casktura/SIBOOR-Voron-2.4-AUG/00_My_Build/STLs/BTT HDMI5 V1.2 display mount Voron/hdmi5-v1_2-mount-assy_voronlogo.step

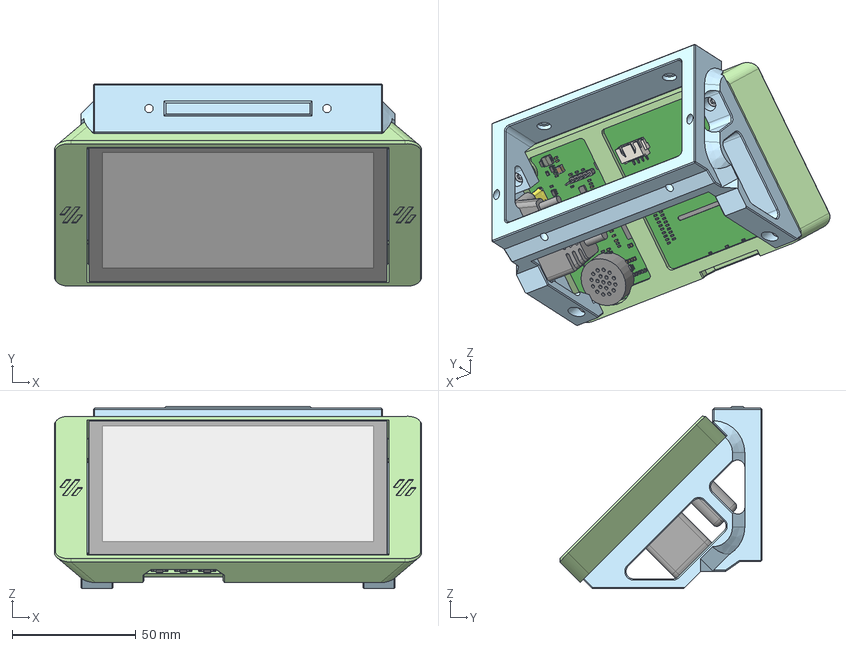
[picture p1: CAD file, 2026-06-15]
00_My_Build/STLs/BTT HDMI5 V1.2 display mount Voron/hdmi5-v1_2-mount-assy_voronlogo.step
148.4 x 81.8 x 73.8 mm
Hex socket head cap screw M3x0.50 x 6 x 4
BTT HDMI5 V1-2 mount bracket
USB-C 90 deg cable
BTT HDMI5 V1_2 mount frame
HDMI 90 deg cable
Speaker
R0603 x 150
Extruded x 150
SOT-23-5 x 14
User_Library-LTST-C190GKT_Lens
ts-1101vs-c-a-a x 3
Board
User_Library-LED_0603_G_Fillet
User_Library-LED_0603_G_Pad004
User_Library-LTST-C190GKT_Pad006
TSSOP-10
XH2.54-WS-Òý½Å x 4
R0805 x 2
LOGO?0.5 x 14
User_Library-LTST-C190GKT_Pad004
XB-CF24P-1
0420¶Ë×Ó x 2
CSAC0420
User_Library-LTST-C190GKT_Pad007
XH2.54-WS-4P x 3
L_tende.stp x 10
base.stp x 5
User_Library-LTST-C190GKT_Pad
User_Library-SOT1176-1-1_RGB659217 x 3
User_Library-LTST-C190GKT_Pad005
User_Library-SOT23-6-2 x 2
SOT-223_MP04A x 6
User_Library-C-1210-2_5x2_5x3_2
User_Library-LTST-C190GKT_Pad001
String+
String-
LOGOÔ²££°.£³ x 14
SOD-123
User_Library-LED_0603_G_Pad
LOGO?0.15 x 28
OSC_3225-4 x 12
User_Library-24_QFN_3x3 x 26
LOGO?0.25 x 14
FPC0.5_2H-W_Òý½Å x 6
FPC0.5_2H-S-W-6P x 2
LOGO? x 14
R_0603 x 3
User_Library-LTST-C190GKT_Pad003
User_Library-LED_0603_G_Pocket002
Strip
Button
Pin
Sheet_Metal_Part6 x 2
TSSOP-8 x 9
User_Library-LED_0603_G_Pocket001
COMPOUND^FPC-SMD_KH-FG0.5-H2.0-50PIN_U1_FPC0.5MM_WS_50P_C2797221(2)_F PC0.5MM_WS_50P_C2797221 x 56
QFN76_L9_W9_P0R4 x 78
