casktura/SIBOOR-Voron-2.4-AUG/00_My_Build/STLs/00_Prints/Annes Engineering - Panel Clips/2 Sides/lock_body_6mm_x4.STL

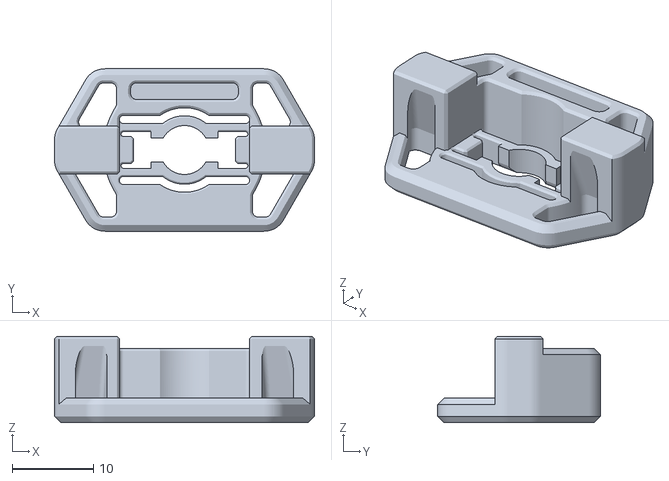
[picture p3: CAD file, 2026-05-06]
00_My_Build/STLs/00_Prints/Annes Engineering - Panel Clips/2 Sides/lock_body_6mm_x4.STL
32.0 x 20.0 x 10.6
