casktura/SIBOOR-Voron-2.4-AUG/00_My_Build/STLs/00_Prints/Annes Engineering - Panel Clips/Back/key_asymmetric_5_x11.STL

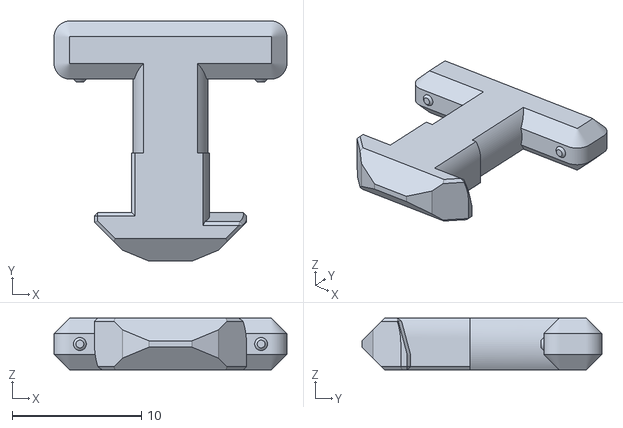
[picture p4: CAD file, 2026-05-06]
00_My_Build/STLs/00_Prints/Annes Engineering - Panel Clips/Back/key_asymmetric_5_x11.STL
18.0 x 18.6 x 4.00
