casktura/SIBOOR-Voron-2.4-AUG/00_My_Build/STLs/00_Prints/Annes Engineering - Panel Clips/Top/lock_body_4mm_x4.STL

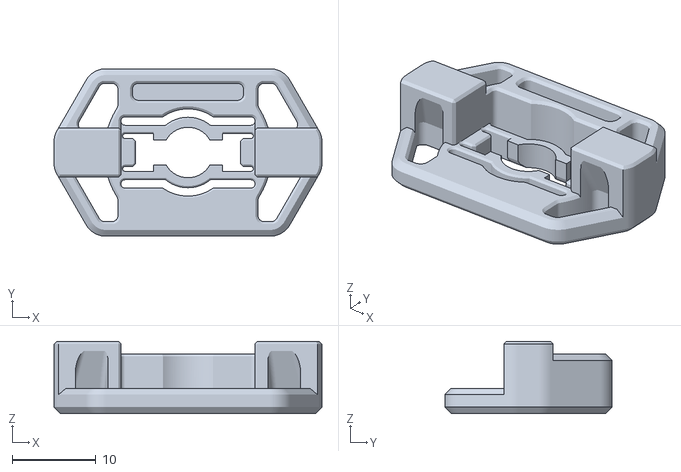
[picture p5: CAD file, 2026-05-06]
00_My_Build/STLs/00_Prints/Annes Engineering - Panel Clips/Top/lock_body_4mm_x4.STL
32.0 x 20.0 x 8.60
