casktura/SIBOOR-Voron-2.4-AUG/00_My_Build/STLs/00_Prints/Magnetic Door Hinge for V2.4 Remixed/magnetic_door_hinge_tape_v2__4mm.stl

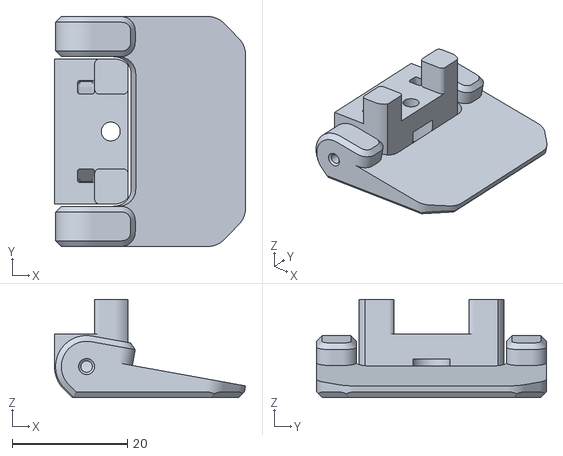
[picture p6: CAD file, 2026-05-18]
00_My_Build/STLs/00_Prints/Magnetic Door Hinge for V2.4 Remixed/magnetic_door_hinge_tape_v2__4mm.stl
33.2 x 40.0 x 17.1
