casktura/SIBOOR-Voron-2.4-AUG/00_My_Build/STLs/2020 Extrusion Cable Clips/clip_small.stl

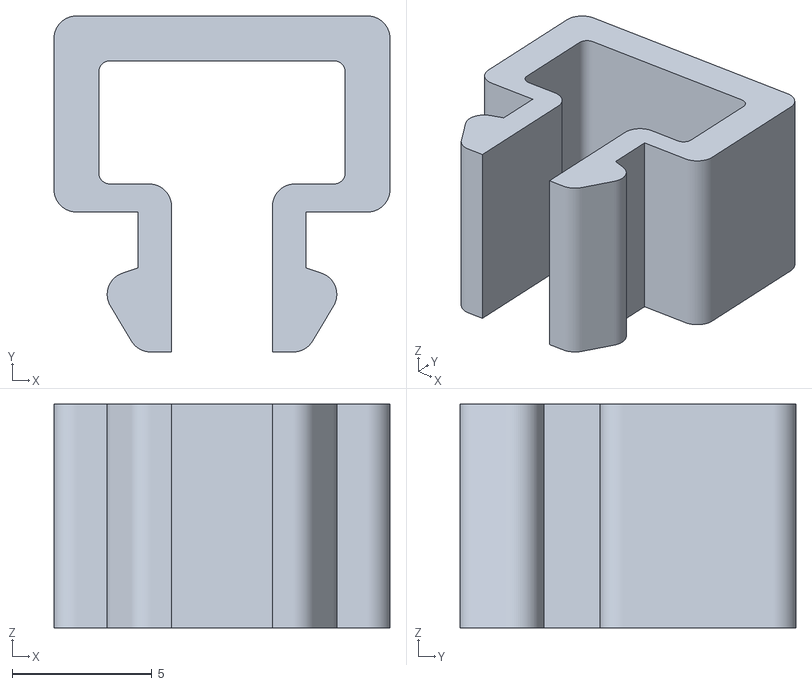
[picture p7: CAD file, 2026-05-06]
00_My_Build/STLs/2020 Extrusion Cable Clips/clip_small.stl
12.0 x 12.0 x 8.00
