casktura/SIBOOR-Voron-2.4-AUG/00_My_Build/STLs/Annes Engineering - Panel Clips/Source/hinge/qr/STL/support_plate_6mm_mirror.stl

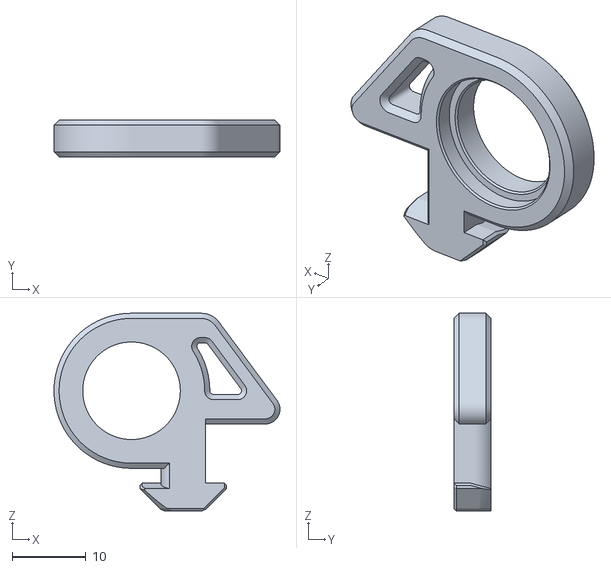
[picture p8: CAD file, 2026-05-06]
00_My_Build/STLs/Annes Engineering - Panel Clips/Source/hinge/qr/STL/support_plate_6mm_mirror.stl
30.6 x 5.00 x 26.8
