casktura/SIBOOR-Voron-2.4-AUG/00_My_Build/STLs/Annes Engineering - Panel Clips/Source/panel_clips_and_corners/key/CAD/key_asymmetric_9.STEP

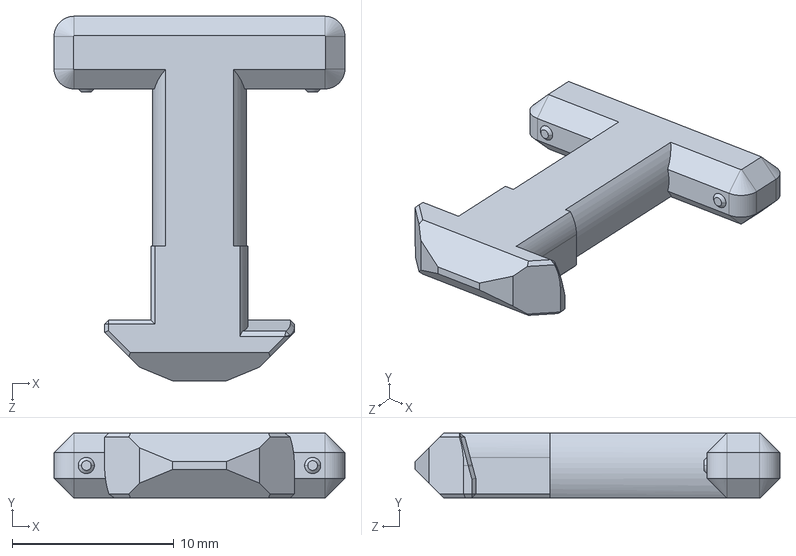
[picture p11: CAD file, 2026-05-06]
00_My_Build/STLs/Annes Engineering - Panel Clips/Source/panel_clips_and_corners/key/CAD/key_asymmetric_9.STEP
18.0 x 4.00 x 22.6 mm
