casktura/SIBOOR-Voron-2.4-AUG/00_My_Build/STLs/Annes Engineering - Panel Clips/Source/panel_latch/CAD/latch.STEP

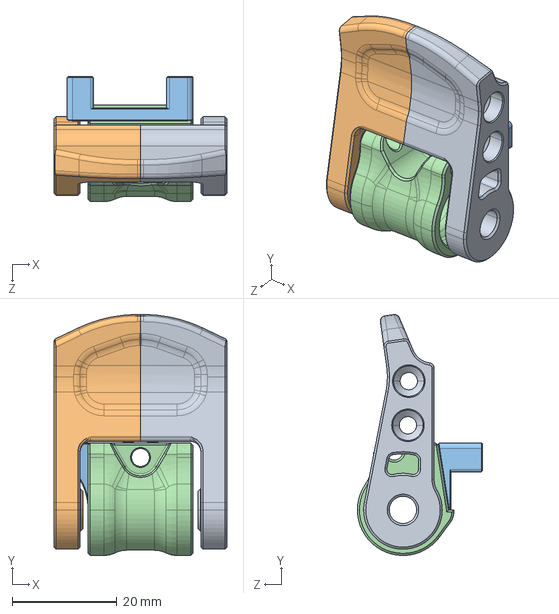
[picture p13: CAD file, 2026-05-06]
00_My_Build/STLs/Annes Engineering - Panel Clips/Source/panel_latch/CAD/latch.STEP
33.0 x 46.0 x 23.9 mm
