casktura/SIBOOR-Voron-2.4-AUG/00_My_Build/STLs/Annes Engineering - Panel Clips/Source/panel_latch/STLs/right.STL

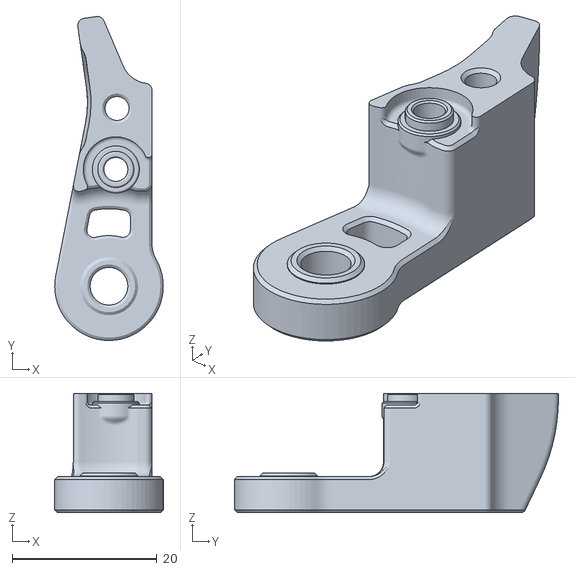
[picture p14: CAD file, 2026-05-06]
00_My_Build/STLs/Annes Engineering - Panel Clips/Source/panel_latch/STLs/right.STL
15.0 x 44.8 x 16.5
