casktura/SIBOOR-Voron-2.4-AUG/00_My_Build/STLs/Annes Engineering - Panel Clips/Source/panel_support/locking/STL/locing_panel_support_key_4mm.stl

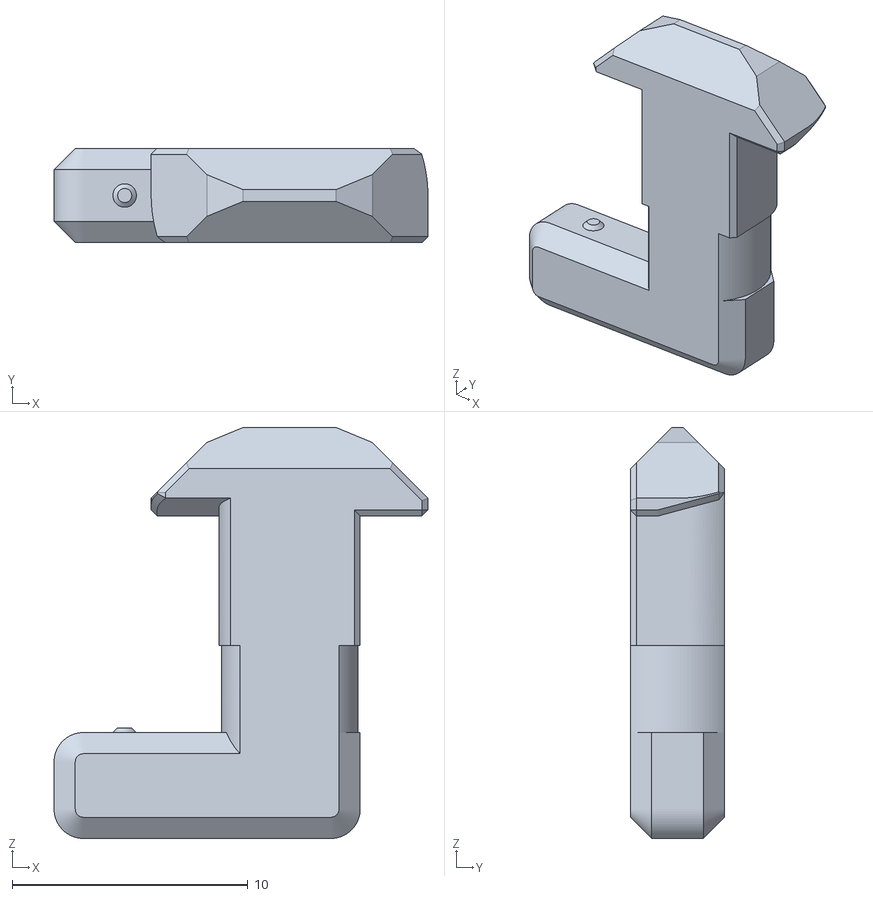
[picture p15: CAD file, 2026-05-06]
00_My_Build/STLs/Annes Engineering - Panel Clips/Source/panel_support/locking/STL/locing_panel_support_key_4mm.stl
15.9 x 4.00 x 17.4
