casktura/SIBOOR-Voron-2.4-AUG/00_My_Build/STLs/Annex Clip Wrench/annex_clips_wrench.stl

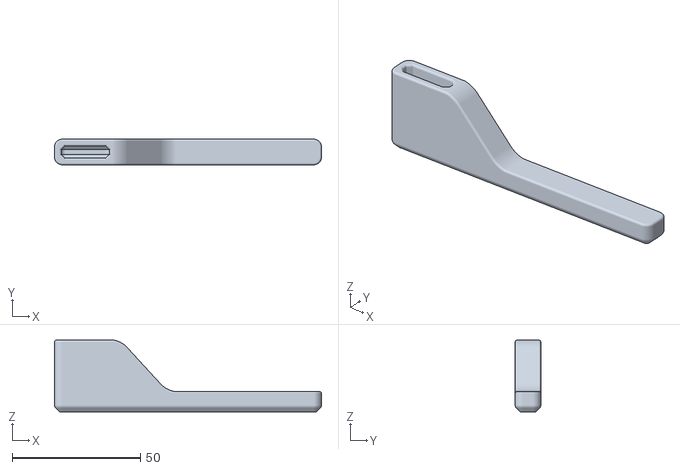
[picture p17: CAD file, 2026-05-20]
00_My_Build/STLs/Annex Clip Wrench/annex_clips_wrench.stl
104.0 x 10.0 x 28.0
