casktura/SIBOOR-Voron-2.4-AUG/00_My_Build/STLs/BTT HDMI5 V1.2 Display Voron V2.4 Mount/btt-hdmi5-v1_2-mount-frame_regular.stl

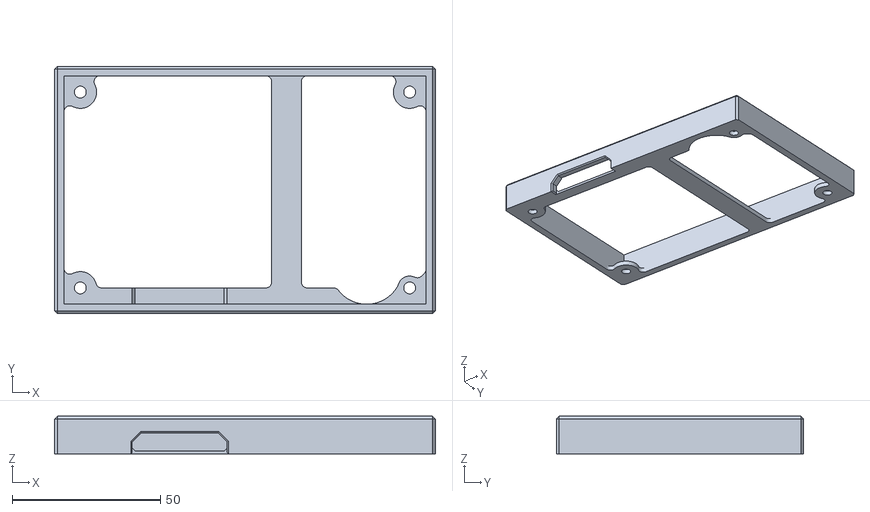
[picture p18: CAD file, 2026-06-15]
00_My_Build/STLs/BTT HDMI5 V1.2 Display Voron V2.4 Mount/btt-hdmi5-v1_2-mount-frame_regular.stl
128.4 x 83.4 x 12.7
