casktura/SIBOOR-Voron-2.4-AUG/00_My_Build/STLs/Exhaust Cover/Exhaust_cover.step

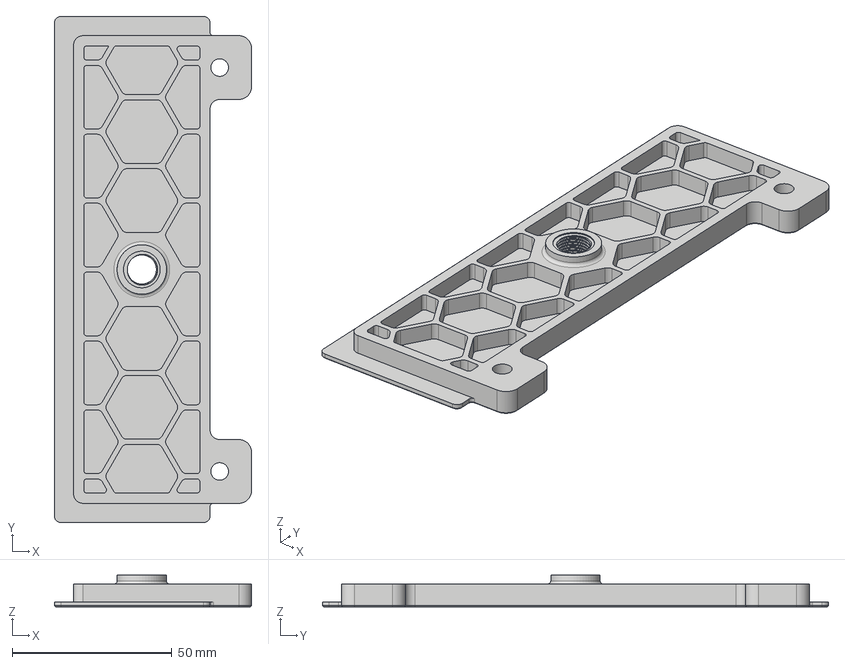
[picture p19: CAD file, 2026-05-06]
00_My_Build/STLs/Exhaust Cover/Exhaust_cover.step
61.8 x 158.6 x 10.00 mm
