casktura/SIBOOR-Voron-2.4-AUG/00_My_Build/STLs/Front Door M3/hinge_left_x2.stl

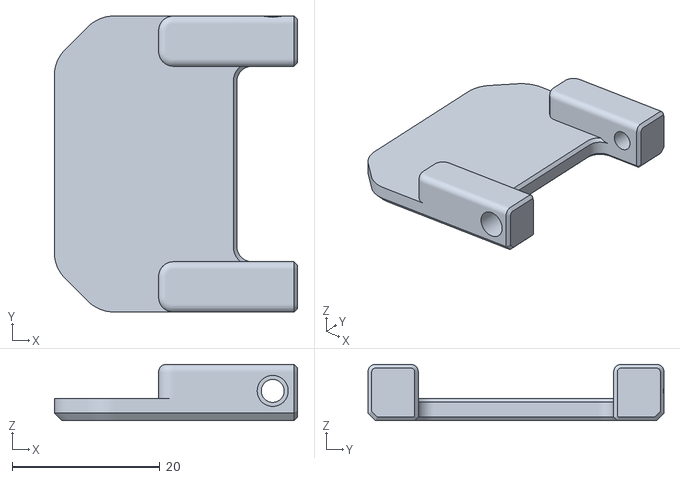
[picture p20: CAD file, 2026-05-06]
00_My_Build/STLs/Front Door M3/hinge_left_x2.stl
32.9 x 40.0 x 7.60
