casktura/SIBOOR-Voron-2.4-AUG/00_My_Build/STLs/GT2 Belt Tension Meter/CAD/Tension Meter Blank 1.0mm Offset.step

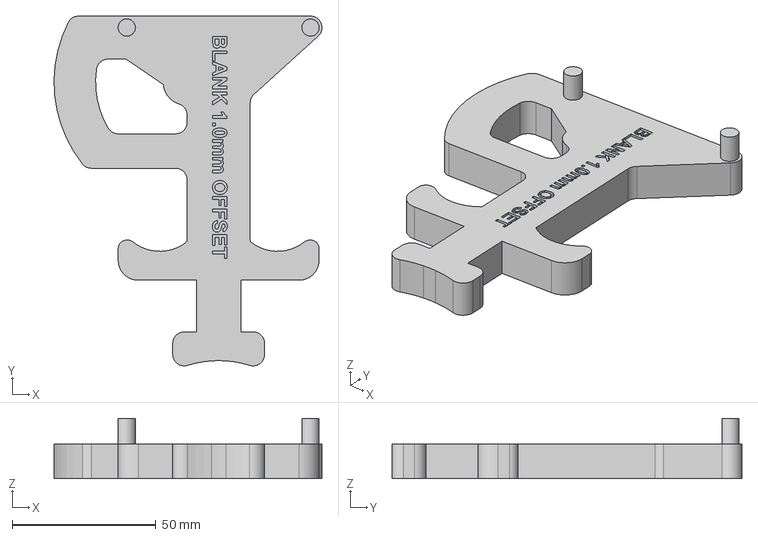
[picture p21: CAD file, 2026-06-15]
00_My_Build/STLs/GT2 Belt Tension Meter/CAD/Tension Meter Blank 1.0mm Offset.step
93.3 x 121.8 x 21.0 mm
