casktura/SIBOOR-Voron-2.4-AUG/00_My_Build/STLs/GT2 Belt Tension Meter/STLs/Needle 05-RC2.stl

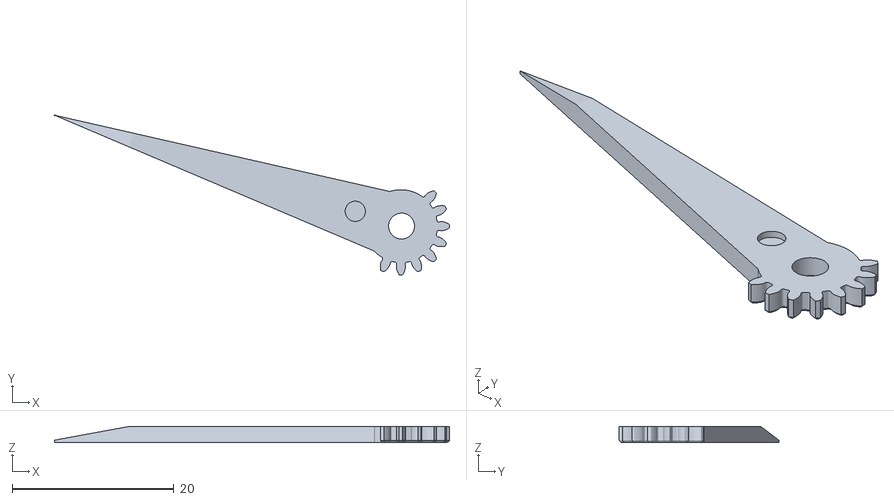
[picture p22: CAD file, 2026-06-15]
00_My_Build/STLs/GT2 Belt Tension Meter/STLs/Needle 05-RC2.stl
48.8 x 19.7 x 2.00
