casktura/SIBOOR-Voron-2.4-AUG/00_My_Build/STLs/Magnetic Door Hinge for V2.4 Remixed/Magnetic_door_hinge_v1/magnetic_door_hinge_4mm.stl

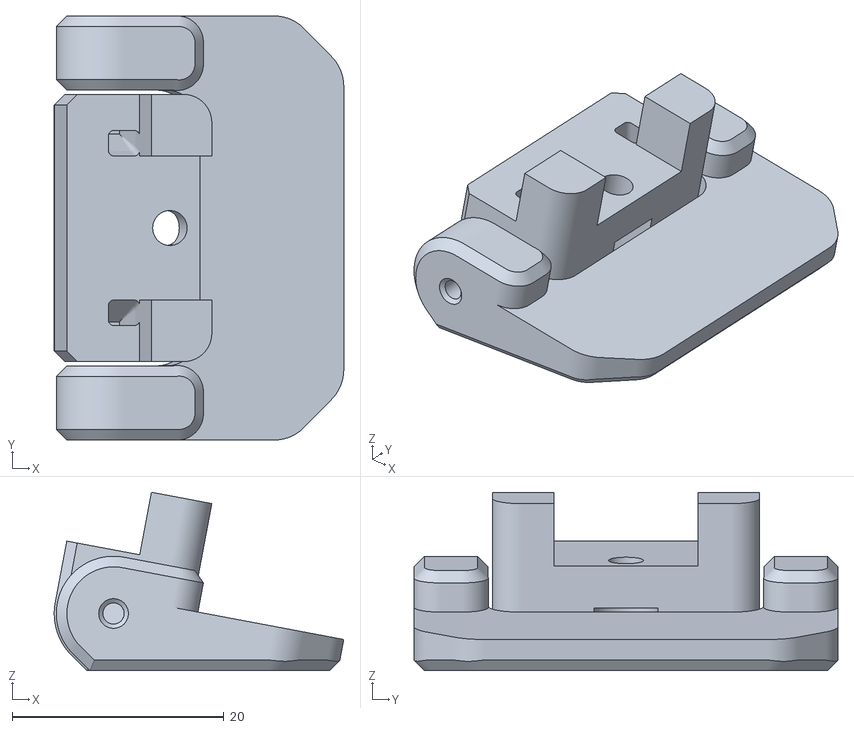
[picture p23: CAD file, 2026-05-18]
00_My_Build/STLs/Magnetic Door Hinge for V2.4 Remixed/Magnetic_door_hinge_v1/magnetic_door_hinge_4mm.stl
27.3 x 40.0 x 16.8
