casktura/SIBOOR-Voron-2.4-AUG/00_My_Build/STLs/Magnetic Door Hinge for V2.4 Remixed/Magnetic_door_hinge_v2 Tape_mount/magnetic_door_hinge_tape_v2_nologo__11mm.stl

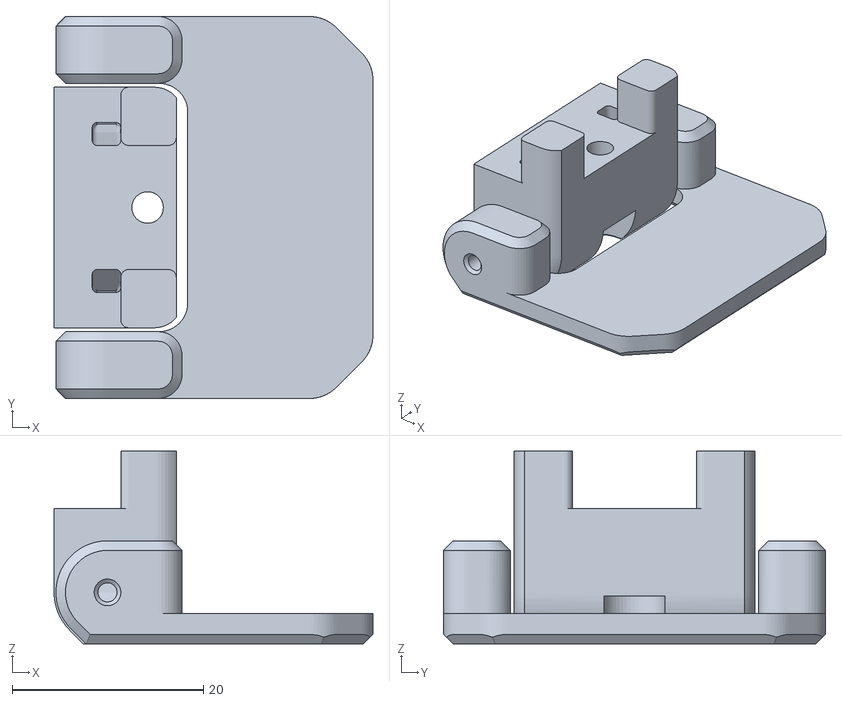
[picture p24: CAD file, 2026-05-18]
00_My_Build/STLs/Magnetic Door Hinge for V2.4 Remixed/Magnetic_door_hinge_v2 Tape_mount/magnetic_door_hinge_tape_v2_nologo__11mm.stl
33.4 x 40.0 x 20.2
