casktura/SIBOOR-Voron-2.4-AUG/00_My_Build/STLs/Mellow StealthBurner LED/Fly_Stealthburner_LED.step

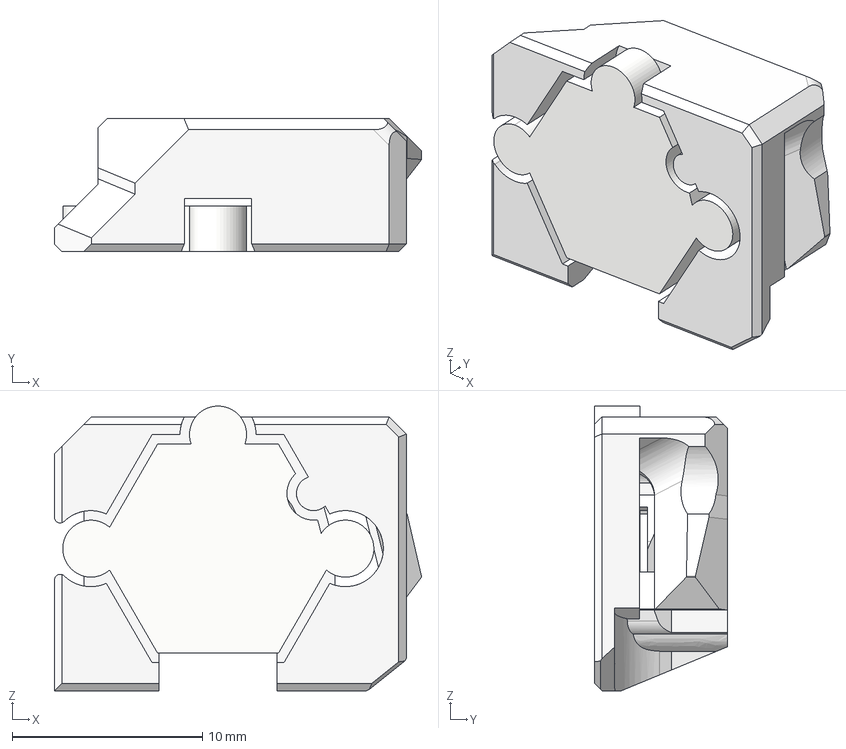
[picture p25: CAD file, 2026-06-09]
00_My_Build/STLs/Mellow StealthBurner LED/Fly_Stealthburner_LED.step
19.3 x 7.01 x 15.0 mm
