casktura/SIBOOR-Voron-2.4-AUG/00_My_Build/STLs/My Designs/Wi-Fi Card.stl

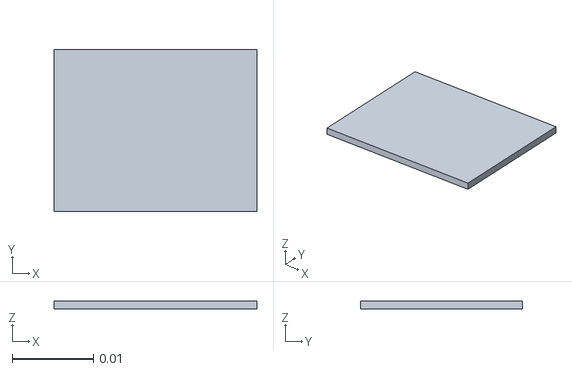
[picture p26: CAD file, 2026-06-09]
00_My_Build/STLs/My Designs/Wi-Fi Card.stl
0.025 x 0.02 x 0.001
