casktura/SIBOOR-Voron-2.4-AUG/00_My_Build/STLs/Nevermore V6 Carbon Filter- Easy Lid Remix With Magnets/door-v16.step

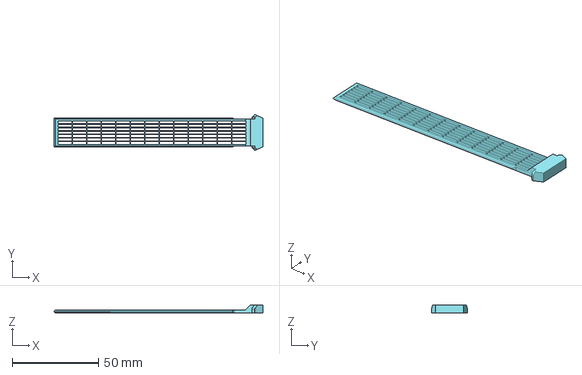
[picture p27: CAD file, 2026-06-09]
00_My_Build/STLs/Nevermore V6 Carbon Filter- Easy Lid Remix With Magnets/door-v16.step
121.2 x 20.6 x 4.80 mm
