casktura/SIBOOR-Voron-2.4-AUG/00_My_Build/STLs/Nevermore V6 Carbon Filter- Easy Lid Remix With Magnets/Superseeded/catridge-90-v14.step

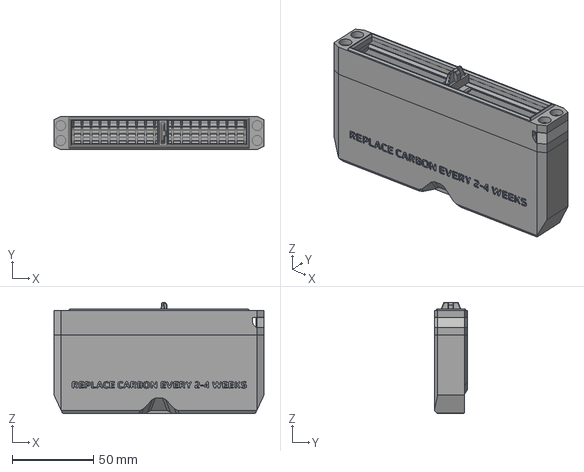
[picture p28: CAD file, 2026-06-09]
00_My_Build/STLs/Nevermore V6 Carbon Filter- Easy Lid Remix With Magnets/Superseeded/catridge-90-v14.step
129.6 x 20.6 x 68.7 mm
