casktura/SIBOOR-Voron-2.4-AUG/00_My_Build/STLs/Ultra Cool BTT Octopus Stepper Driver Fan Duct/Octopus_Stepper_Duct v3 - No Top or Side Vents.stl

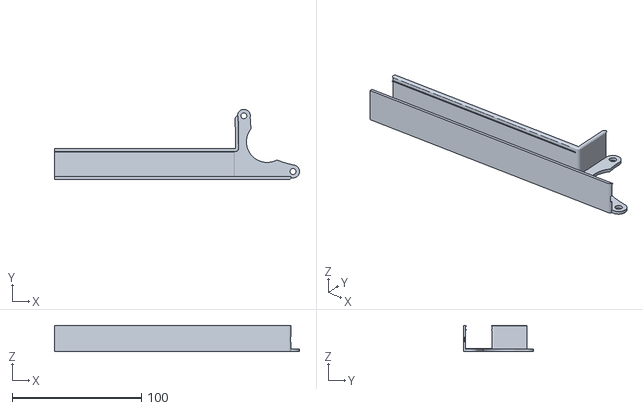
[picture p29: CAD file, 2026-06-09]
00_My_Build/STLs/Ultra Cool BTT Octopus Stepper Driver Fan Duct/Octopus_Stepper_Duct v3 - No Top or Side Vents.stl
189.4 x 54.3 x 20.3
