casktura/SIBOOR-Voron-2.4-AUG/00_My_Build/STLs/Voron 2.4 Carrying Handle/Voron Trident Handles.3mf

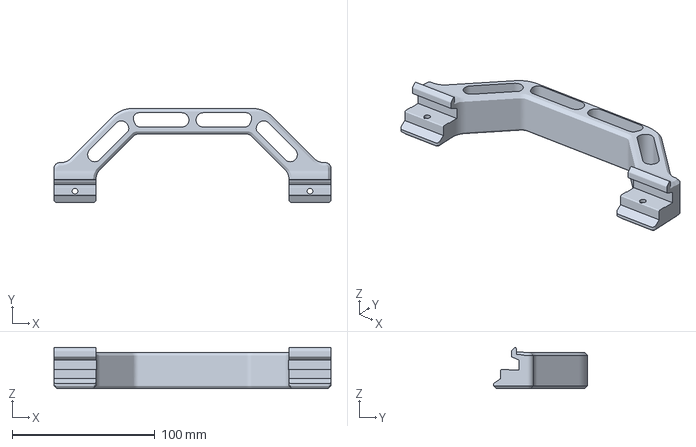
[picture p30: CAD file, 2026-05-06]
00_My_Build/STLs/Voron 2.4 Carrying Handle/Voron Trident Handles.3mf
194.3 x 66.0 x 28.9 mm
