casktura/SIBOOR-Voron-2.4-AUG/00_My_Build/STLs/Voron 2.4 Magnetic Door Hinges/Door holder right.step

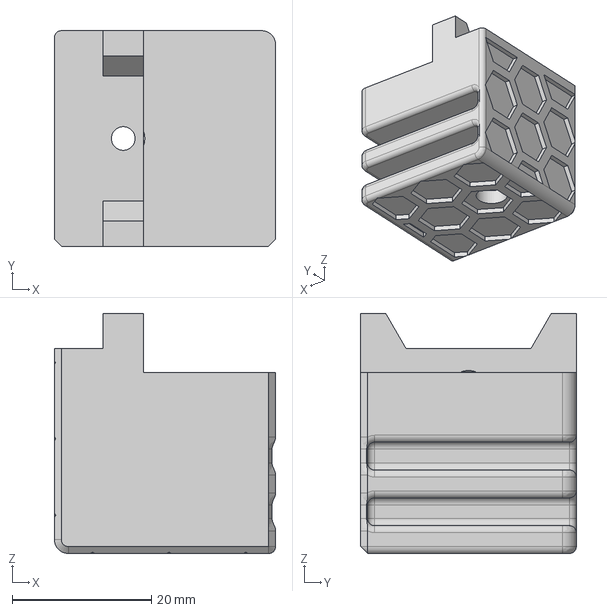
[picture p31: CAD file, 2026-05-18]
00_My_Build/STLs/Voron 2.4 Magnetic Door Hinges/Door holder right.step
31.8 x 31.0 x 34.5 mm
