casktura/SIBOOR-Voron-2.4-AUG/00_My_Build/STLs/Voron Chamber Temperature Sensor Mount/Chamber_Sensor_Voron.stp

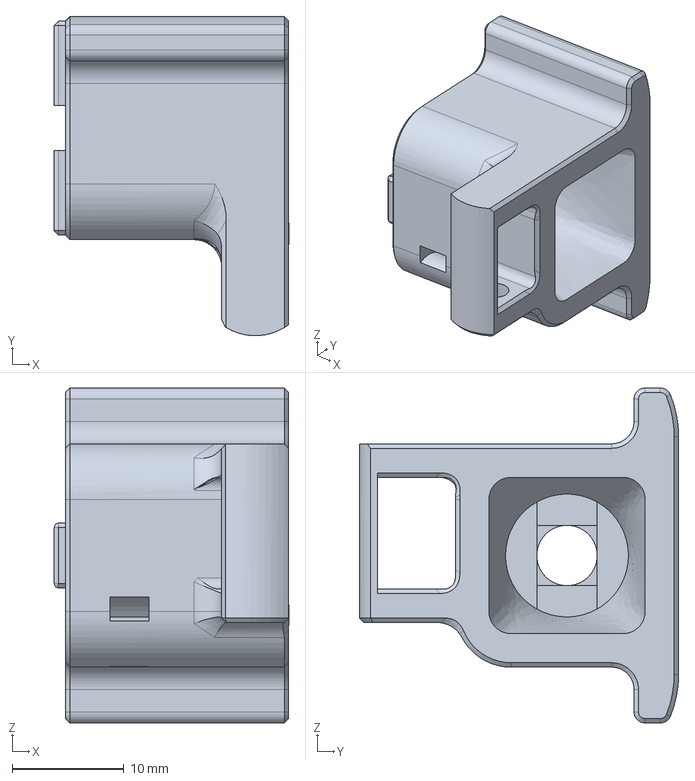
[picture p32: CAD file, 2026-05-06]
00_My_Build/STLs/Voron Chamber Temperature Sensor Mount/Chamber_Sensor_Voron.stp
21.0 x 28.6 x 30.0 mm
