casktura/SIBOOR-Voron-2.4-AUG/00_My_Build/STLs/Voron Exhaust Cover BTT SFS V2.0 Mount/BTT SFS V2.0 Sensor Mount.stl

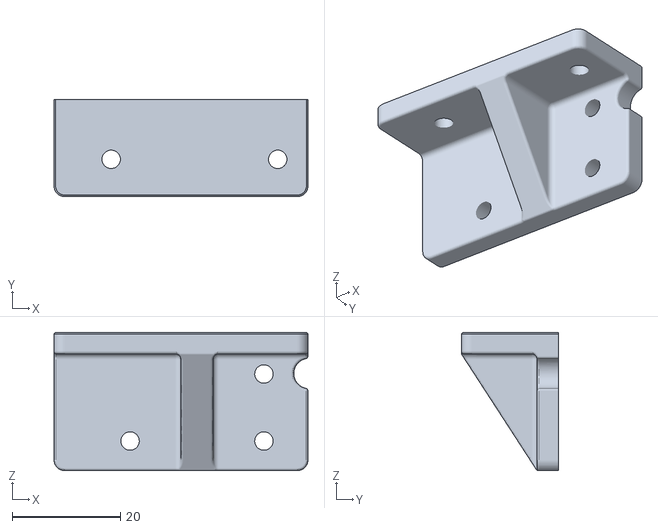
[picture p33: CAD file, 2026-05-06]
00_My_Build/STLs/Voron Exhaust Cover BTT SFS V2.0 Mount/BTT SFS V2.0 Sensor Mount.stl
47.0 x 18.0 x 25.6
