casktura/SIBOOR-Voron-2.4-AUG/00_My_Build/STLs/Voron Rollback Stands/mirrored-logo.stp

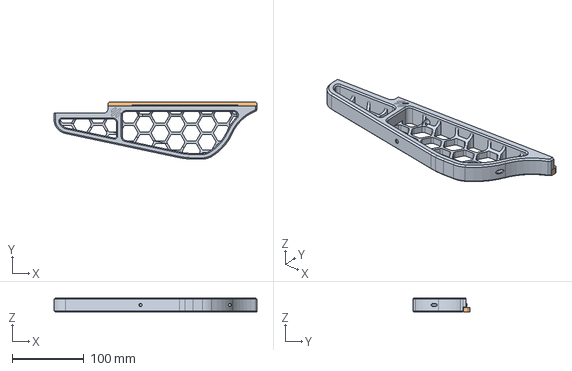
[picture p34: CAD file, 2026-05-06]
00_My_Build/STLs/Voron Rollback Stands/mirrored-logo.stp
282.2 x 79.5 x 20.0 mm
