casktura/SIBOOR-Voron-2.4-AUG/00_My_Build/STLs/00_Prints/Annes Engineering - Panel Clips/Back/corner_lock_body_5_x4.STL

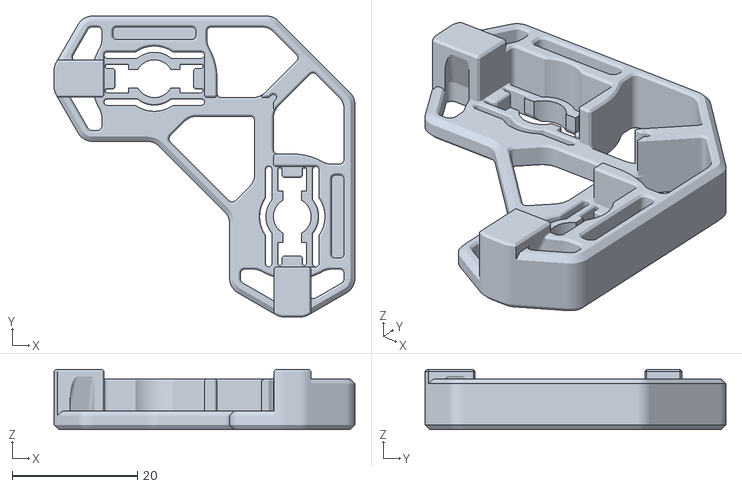
[picture p36: CAD file, 2026-05-06]
00_My_Build/STLs/00_Prints/Annes Engineering - Panel Clips/Back/corner_lock_body_5_x4.STL
48.0 x 48.0 x 9.60
