casktura/SIBOOR-Voron-2.4-AUG/00_My_Build/STLs/2020 Extrusion Cable Clips/flush_clip_small.stl

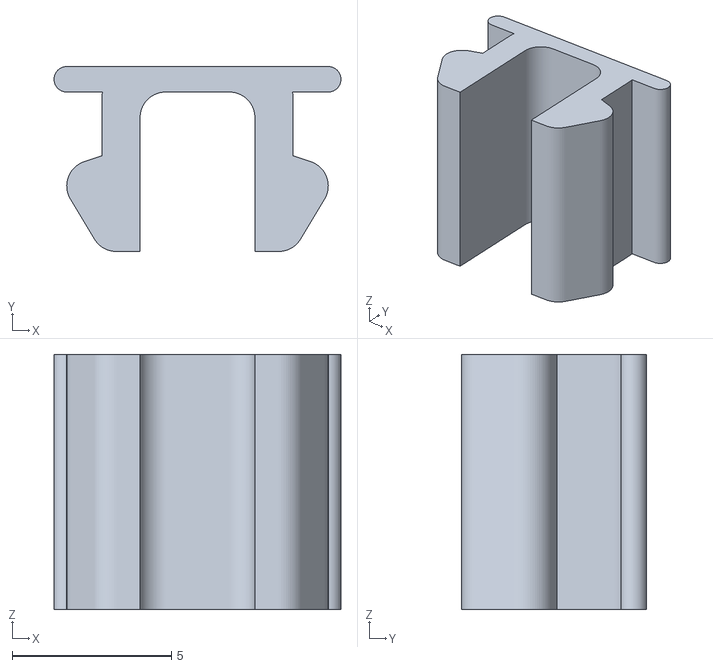
[picture p38: CAD file, 2026-05-06]
00_My_Build/STLs/2020 Extrusion Cable Clips/flush_clip_small.stl
9.00 x 5.80 x 8.00
