casktura/SIBOOR-Voron-2.4-AUG/00_My_Build/STLs/Annes Engineering - Panel Clips/Source/hinge/qr/STL/arm_6mm.stl

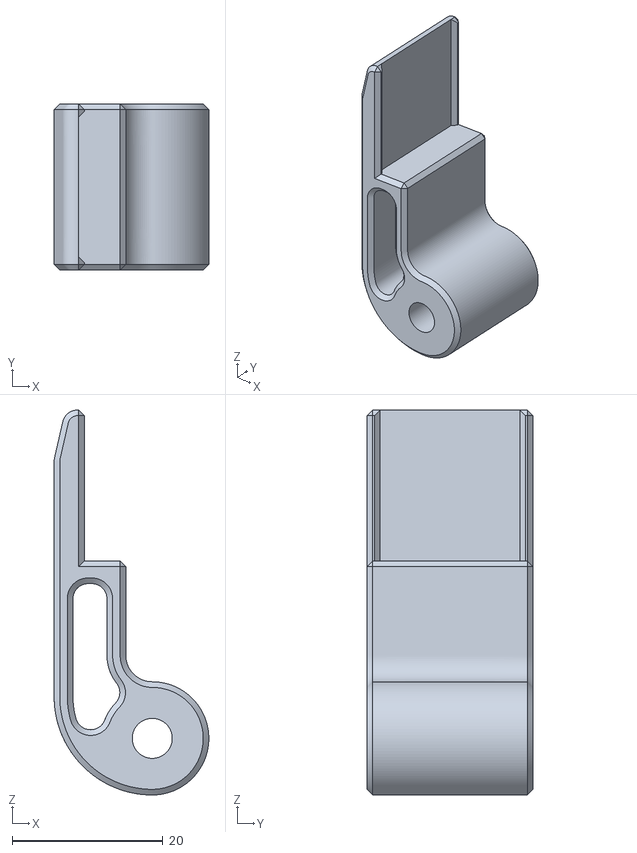
[picture p39: CAD file, 2026-05-06]
00_My_Build/STLs/Annes Engineering - Panel Clips/Source/hinge/qr/STL/arm_6mm.stl
20.5 x 22.0 x 51.0
