casktura/SIBOOR-Voron-2.4-AUG/00_My_Build/STLs/Annes Engineering - Panel Clips/Source/panel_clips_and_corners/corner/CAD/corner_lock_body_4.5.STEP

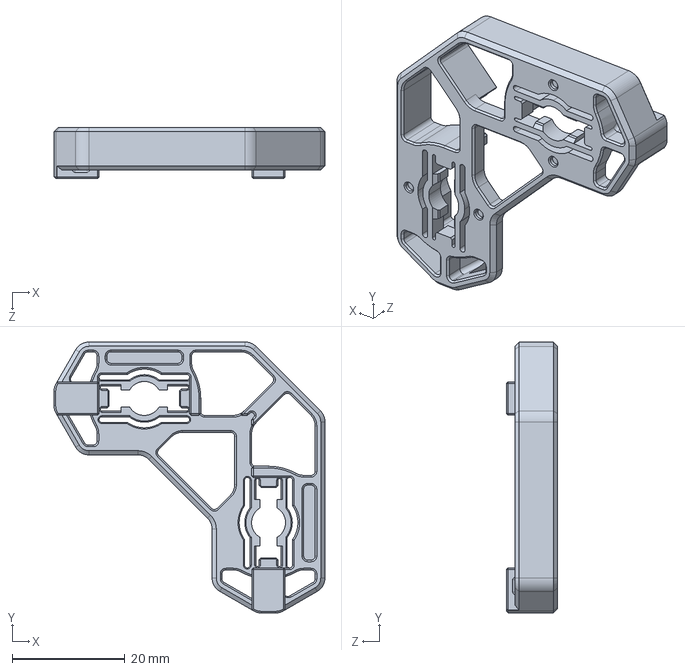
[picture p40: CAD file, 2026-05-06]
00_My_Build/STLs/Annes Engineering - Panel Clips/Source/panel_clips_and_corners/corner/CAD/corner_lock_body_4.5.STEP
48.0 x 48.0 x 9.10 mm
