casktura/SIBOOR-Voron-2.4-AUG/00_My_Build/STLs/Annes Engineering - Panel Clips/Source/panel_clips_and_corners/key/CAD/key_asymmetric_3.5.STEP

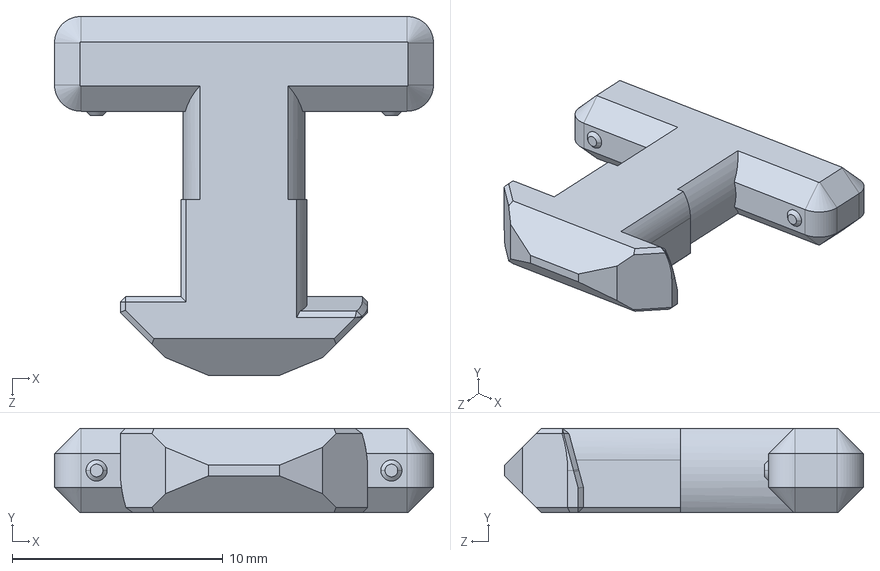
[picture p42: CAD file, 2026-05-06]
00_My_Build/STLs/Annes Engineering - Panel Clips/Source/panel_clips_and_corners/key/CAD/key_asymmetric_3.5.STEP
18.0 x 4.00 x 17.1 mm
