casktura/SIBOOR-Voron-2.4-AUG/00_My_Build/STLs/Annes Engineering - Panel Clips/Source/panel_clips_and_corners/single/CAD/lock_body_8mm.STEP

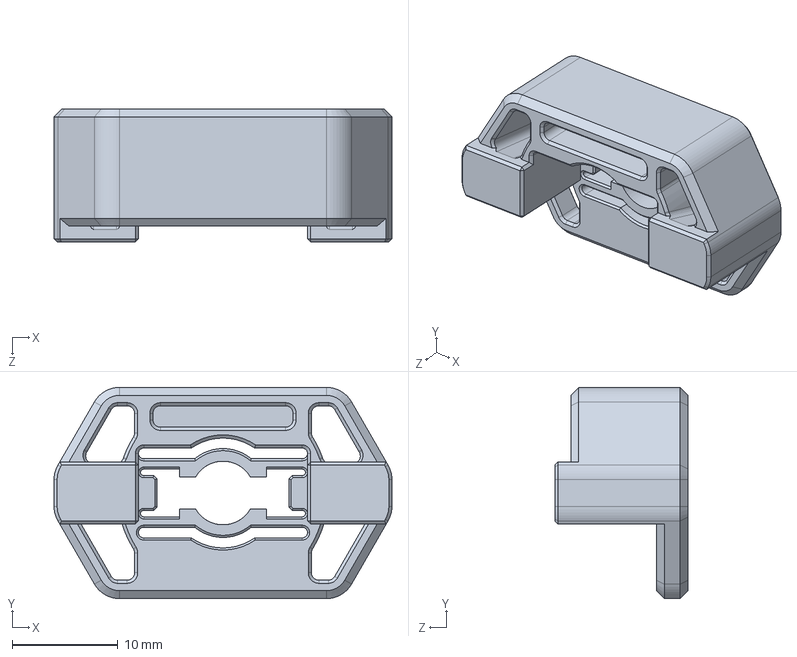
[picture p43: CAD file, 2026-05-06]
00_My_Build/STLs/Annes Engineering - Panel Clips/Source/panel_clips_and_corners/single/CAD/lock_body_8mm.STEP
32.0 x 20.0 x 12.6 mm
