casktura/SIBOOR-Voron-2.4-AUG/00_My_Build/STLs/Annes Engineering - Panel Clips/Source/panel_latch/STLs/body.STL

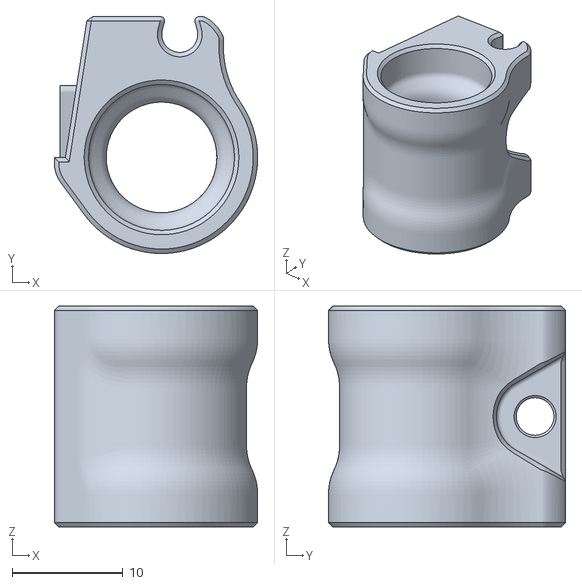
[picture p44: CAD file, 2026-05-06]
00_My_Build/STLs/Annes Engineering - Panel Clips/Source/panel_latch/STLs/body.STL
18.4 x 21.4 x 20.0
