casktura/SIBOOR-Voron-2.4-AUG/00_My_Build/STLs/Annes Engineering - Panel Clips/Source/panel_support/locking/STL/locing_panel_support_body_4mm.stl

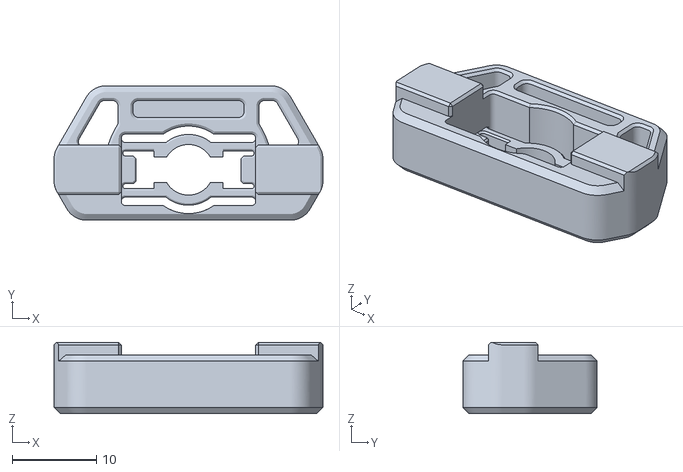
[picture p45: CAD file, 2026-05-06]
00_My_Build/STLs/Annes Engineering - Panel Clips/Source/panel_support/locking/STL/locing_panel_support_body_4mm.stl
32.0 x 16.0 x 8.50
