casktura/SIBOOR-Voron-2.4-AUG/00_My_Build/STLs/Annes Engineering - Panel Clips/Source/panel_support/simple/STL/panel_support_simple_4mm.stl

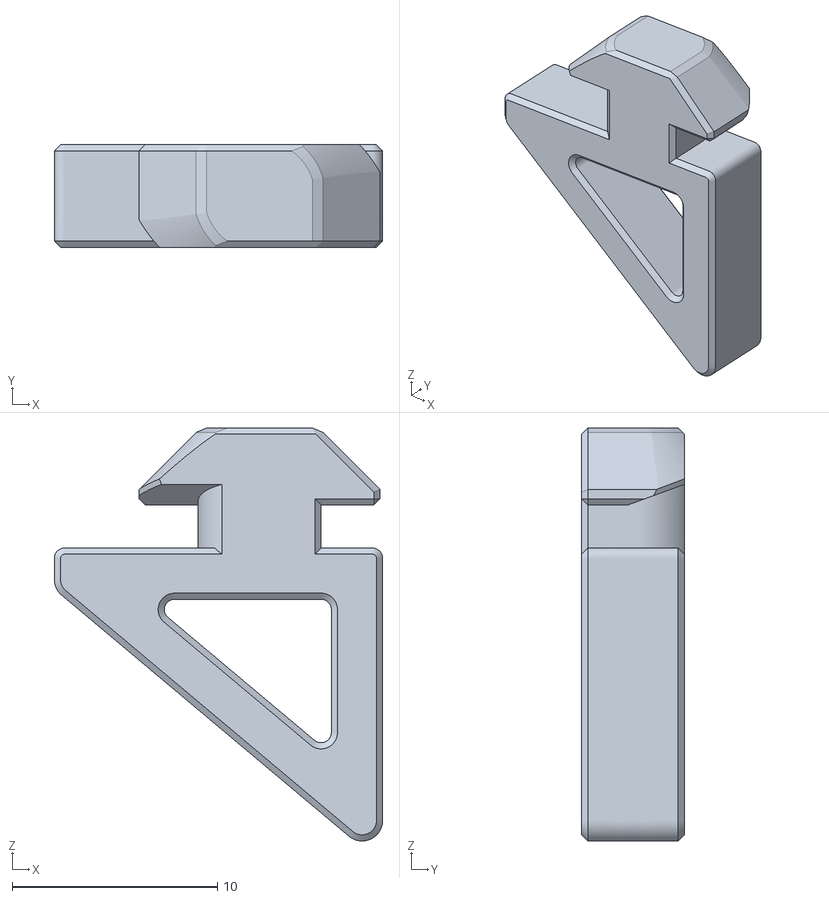
[picture p46: CAD file, 2026-05-06]
00_My_Build/STLs/Annes Engineering - Panel Clips/Source/panel_support/simple/STL/panel_support_simple_4mm.stl
16.0 x 5.00 x 20.1
