casktura/SIBOOR-Voron-2.4-AUG/00_My_Build/STLs/BTT HDMI5 V1.2 display mount Voron/btt-hdmi5-v1_2-mount-frame_voron-logo.stl

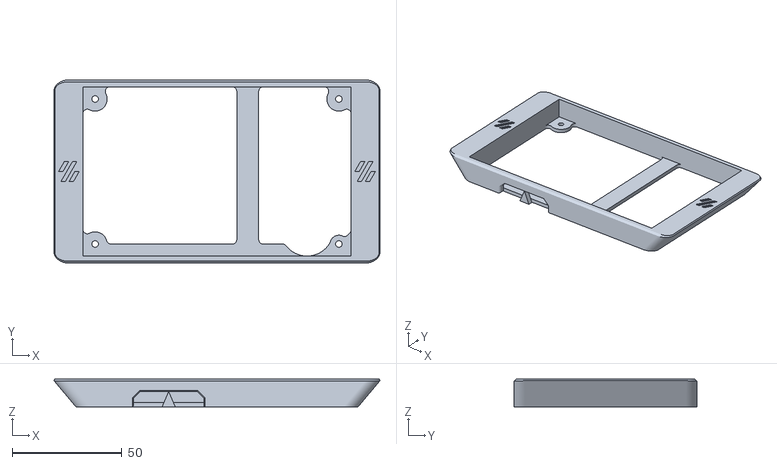
[picture p47: CAD file, 2026-06-15]
00_My_Build/STLs/BTT HDMI5 V1.2 display mount Voron/btt-hdmi5-v1_2-mount-frame_voron-logo.stl
148.4 x 83.4 x 12.7
