casktura/SIBOOR-Voron-2.4-AUG/00_My_Build/STLs/Front Door M3/latch_x2.stl

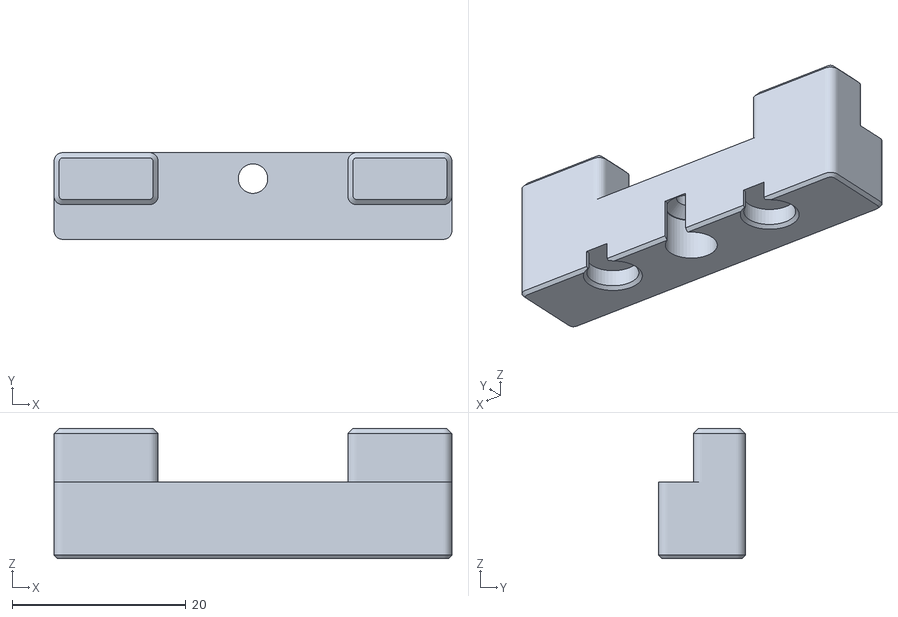
[picture p48: CAD file, 2026-05-06]
00_My_Build/STLs/Front Door M3/latch_x2.stl
45.9 x 10.00 x 15.0
