casktura/SIBOOR-Voron-2.4-AUG/00_My_Build/STLs/GT2 Belt Tension Meter/CAD/Tension Meter Blank 0.5mm Offset.step

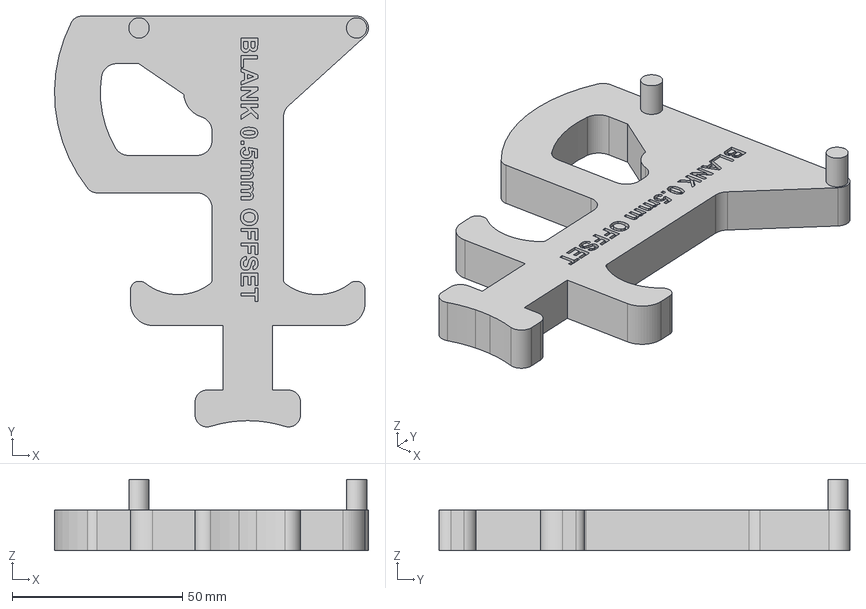
[picture p49: CAD file, 2026-06-15]
00_My_Build/STLs/GT2 Belt Tension Meter/CAD/Tension Meter Blank 0.5mm Offset.step
92.3 x 120.8 x 21.0 mm
