casktura/SIBOOR-Voron-2.4-AUG/00_My_Build/STLs/Magnetic Door Hinge for V2.4 Remixed/Magnetic_door_hinge_v1/magnetic_door_hinge_2mm.stl

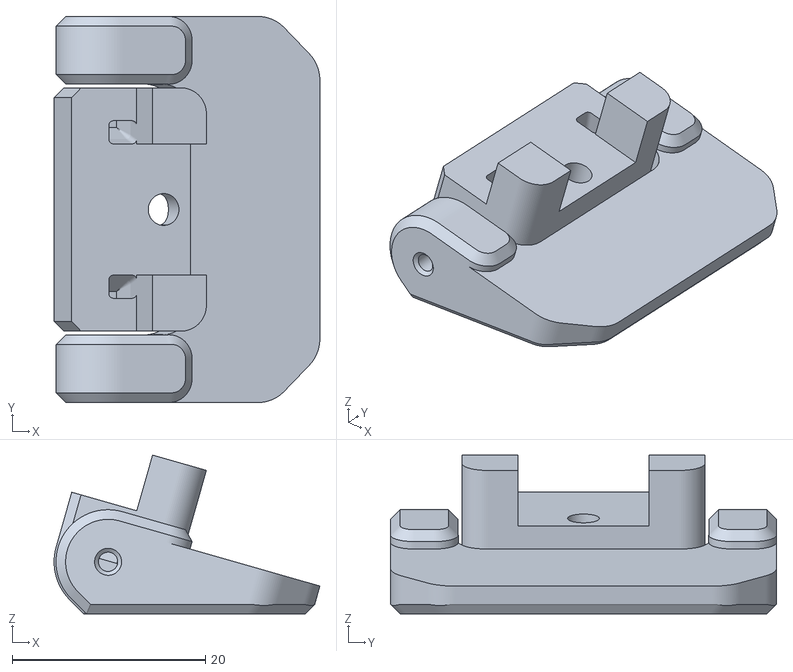
[picture p51: CAD file, 2026-05-18]
00_My_Build/STLs/Magnetic Door Hinge for V2.4 Remixed/Magnetic_door_hinge_v1/magnetic_door_hinge_2mm.stl
27.6 x 40.0 x 16.5
