casktura/SIBOOR-Voron-2.4-AUG/00_My_Build/STLs/My Designs/Door Jig.stl

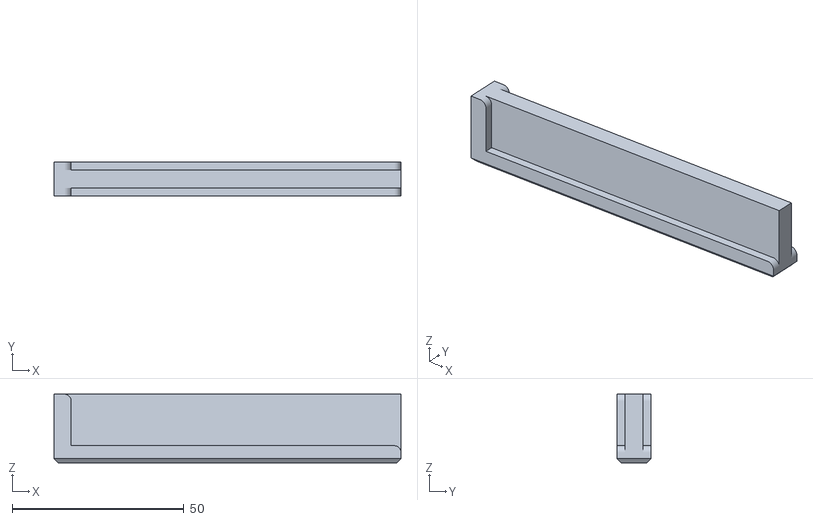
[picture p53: CAD file, 2026-06-09]
00_My_Build/STLs/My Designs/Door Jig.stl
101.0 x 10.0 x 20.0
