casktura/SIBOOR-Voron-2.4-AUG/00_My_Build/STLs/Nevermore V6 Carbon Filter- Easy Lid Remix With Magnets/cartridge-straight-v16.step

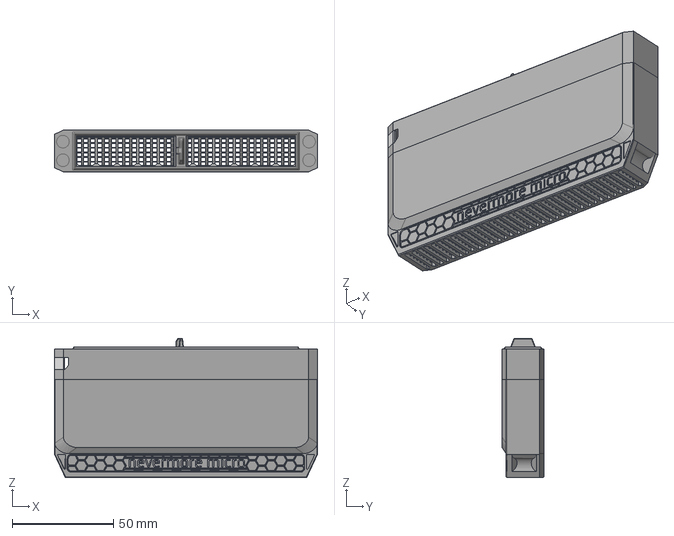
[picture p54: CAD file, 2026-06-09]
00_My_Build/STLs/Nevermore V6 Carbon Filter- Easy Lid Remix With Magnets/cartridge-straight-v16.step
129.6 x 20.6 x 68.7 mm
