casktura/SIBOOR-Voron-2.4-AUG/00_My_Build/STLs/Ultra Cool BTT Octopus Stepper Driver Fan Duct/Empty_Place_Filler.stl

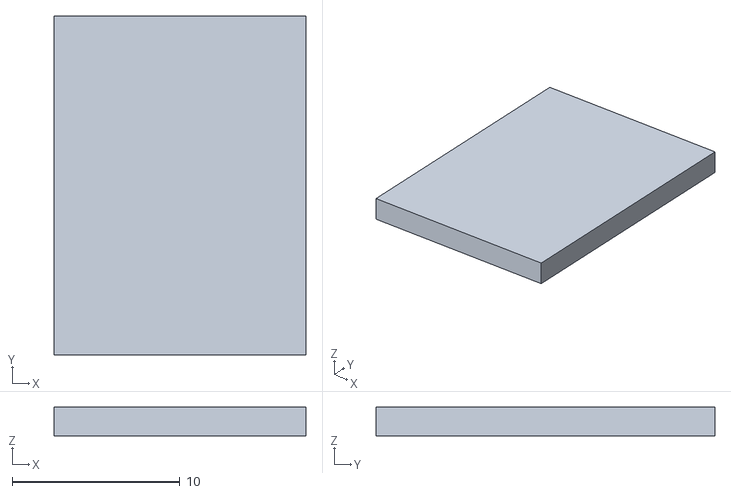
[picture p55: CAD file, 2026-06-09]
00_My_Build/STLs/Ultra Cool BTT Octopus Stepper Driver Fan Duct/Empty_Place_Filler.stl
15.0 x 20.2 x 1.70
