casktura/SIBOOR-Voron-2.4-AUG/00_My_Build/STLs/Voron Exhaust Cover BTT SFS V2.0 Mount/Voron BTT SFS Exhaust Cover.stl

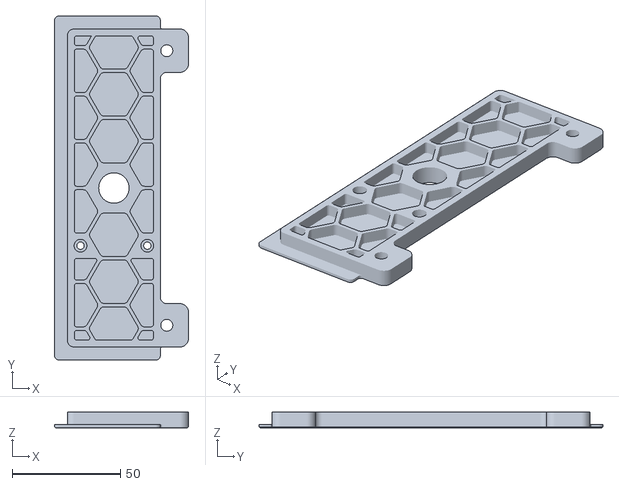
[picture p56: CAD file, 2026-05-06]
00_My_Build/STLs/Voron Exhaust Cover BTT SFS V2.0 Mount/Voron BTT SFS Exhaust Cover.stl
61.8 x 158.6 x 7.20
