casktura/SIBOOR-Voron-2.4-AUG/00_My_Build/STLs/Voron Rollback Stands/right-rocker3mmtape.stl

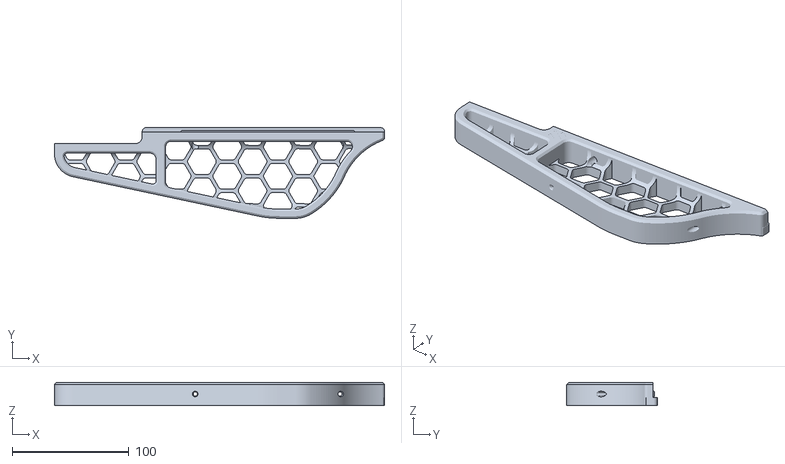
[picture p57: CAD file, 2026-05-06]
00_My_Build/STLs/Voron Rollback Stands/right-rocker3mmtape.stl
282.2 x 77.5 x 20.0
