casktura/SIBOOR-Voron-2.4-AUG/00_My_Build/STLs/00_Prints/Annes Engineering - Panel Clips/2 Sides/key_asymmetric_6_x12.STL

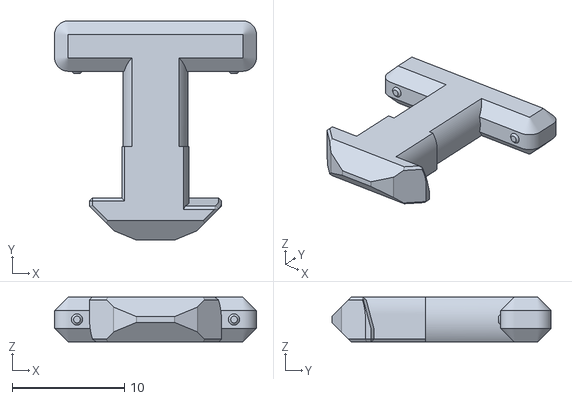
[picture p58: CAD file, 2026-05-06]
00_My_Build/STLs/00_Prints/Annes Engineering - Panel Clips/2 Sides/key_asymmetric_6_x12.STL
18.0 x 19.6 x 4.00
