casktura/SIBOOR-Voron-2.4-AUG/00_My_Build/STLs/00_Prints/Annes Engineering - Panel Clips/Back/lock_body_5mm_x3.STL

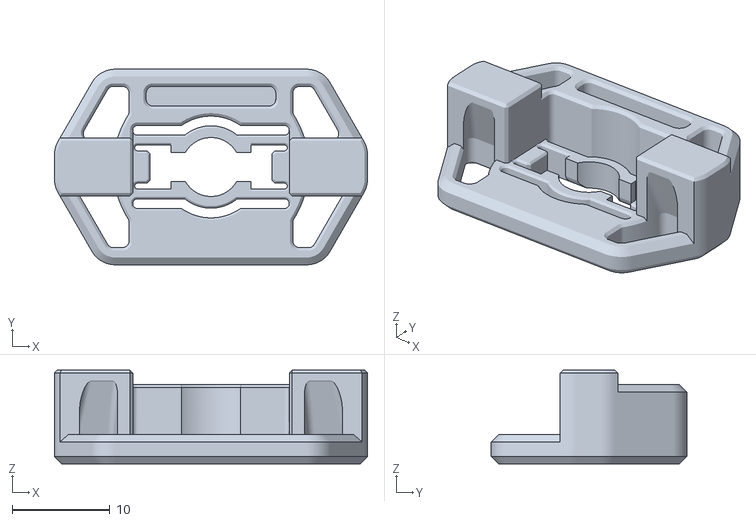
[picture p59: CAD file, 2026-05-06]
00_My_Build/STLs/00_Prints/Annes Engineering - Panel Clips/Back/lock_body_5mm_x3.STL
32.0 x 20.0 x 9.60
