casktura/SIBOOR-Voron-2.4-AUG/00_My_Build/STLs/00_Prints/Annes Engineering - Panel Clips/Top/key_asymmetric_4_x12.STL

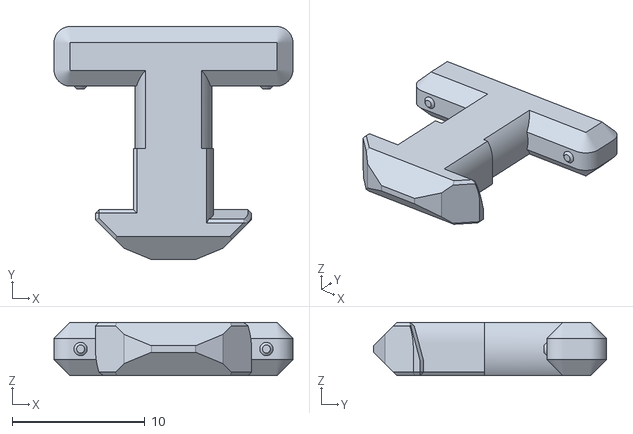
[picture p60: CAD file, 2026-05-06]
00_My_Build/STLs/00_Prints/Annes Engineering - Panel Clips/Top/key_asymmetric_4_x12.STL
18.0 x 17.5 x 4.00
