casktura/SIBOOR-Voron-2.4-AUG/00_My_Build/STLs/Annes Engineering - Panel Clips/Source/panel_clips_and_corners/single/CAD/lock_body_7mm.STEP

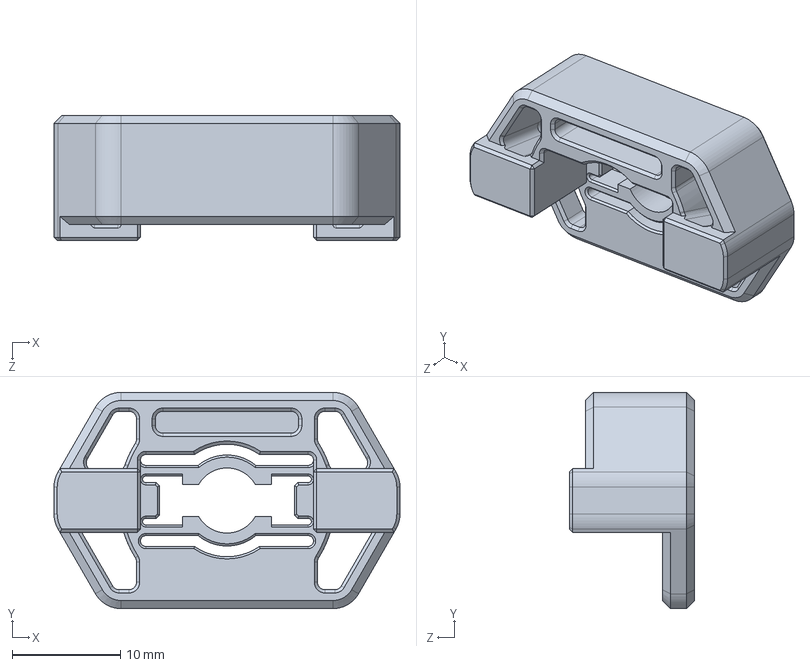
[picture p63: CAD file, 2026-05-06]
00_My_Build/STLs/Annes Engineering - Panel Clips/Source/panel_clips_and_corners/single/CAD/lock_body_7mm.STEP
32.0 x 20.0 x 11.6 mm
