casktura/SIBOOR-Voron-2.4-AUG/00_My_Build/STLs/Annes Engineering - Panel Clips/Source/panel_support/simple/STL/front_panel_support_simple_4mm.stl

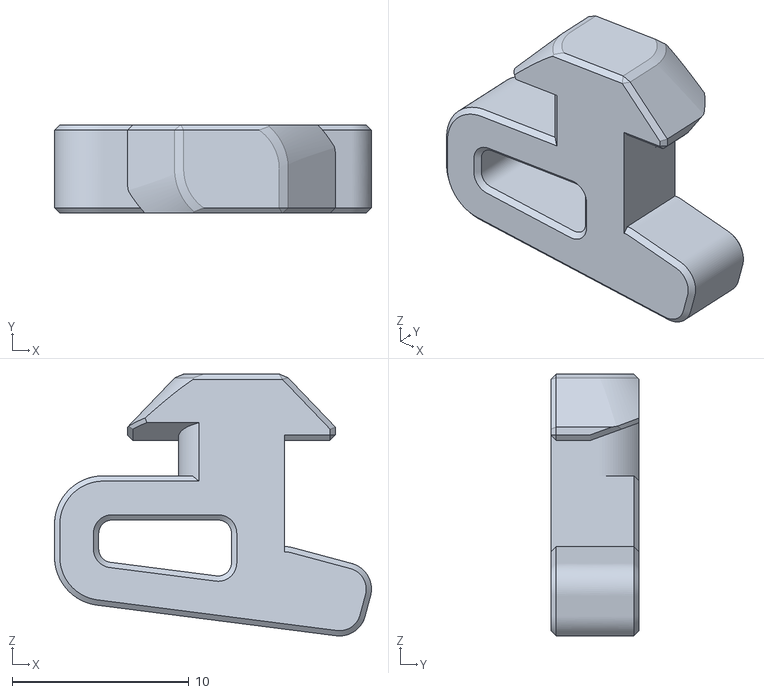
[picture p64: CAD file, 2026-05-06]
00_My_Build/STLs/Annes Engineering - Panel Clips/Source/panel_support/simple/STL/front_panel_support_simple_4mm.stl
17.9 x 5.00 x 14.8
