casktura/SIBOOR-Voron-2.4-AUG/00_My_Build/STLs/BTT HDMI5 V1.2 display mount Voron/btt-hdmi5-v1_2-mount-bracket_regular.stl

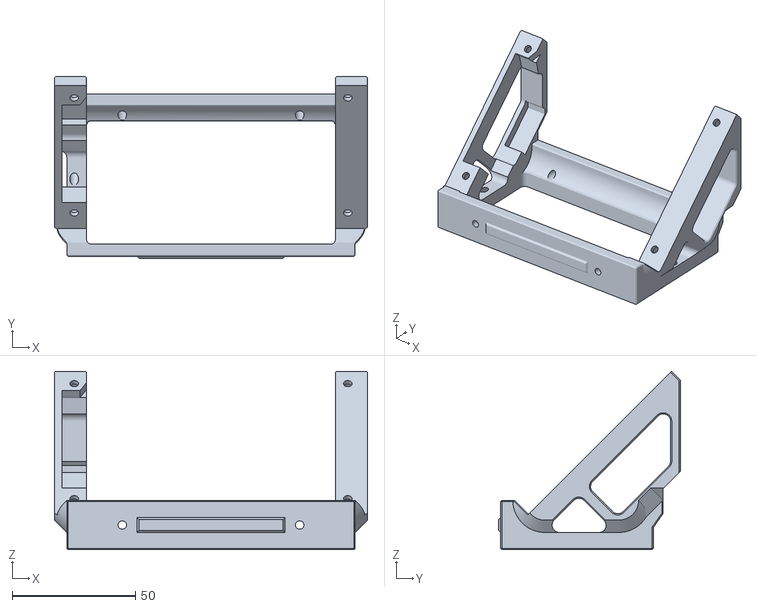
[picture p65: CAD file, 2026-06-15]
00_My_Build/STLs/BTT HDMI5 V1.2 display mount Voron/btt-hdmi5-v1_2-mount-bracket_regular.stl
127.0 x 73.8 x 72.4
