casktura/SIBOOR-Voron-2.4-AUG/00_My_Build/STLs/GT2 Belt Tension Meter/CAD/Tension Meter Blank 0.0mm Offset.step

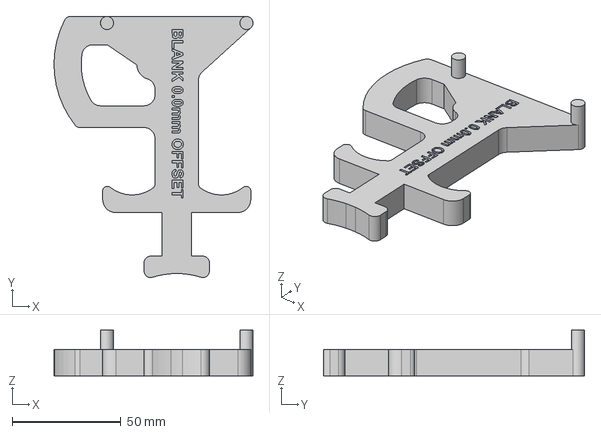
[picture p66: CAD file, 2026-06-15]
00_My_Build/STLs/GT2 Belt Tension Meter/CAD/Tension Meter Blank 0.0mm Offset.step
91.3 x 119.8 x 21.0 mm
