casktura/SIBOOR-Voron-2.4-AUG/00_My_Build/STLs/GT2 Belt Tension Meter/STLs/Meter Base-RC2.stl

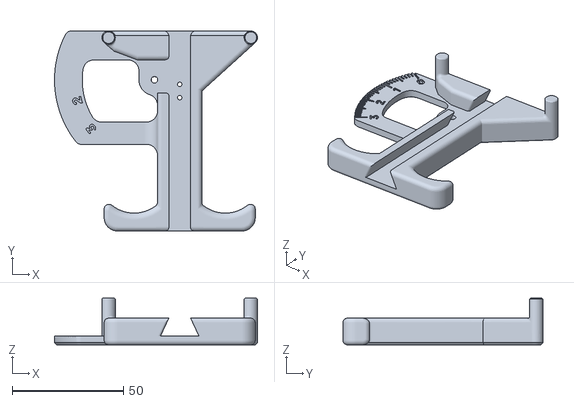
[picture p67: CAD file, 2026-06-15]
00_My_Build/STLs/GT2 Belt Tension Meter/STLs/Meter Base-RC2.stl
91.3 x 90.0 x 21.0
