casktura/SIBOOR-Voron-2.4-AUG/00_My_Build/STLs/Magnetic Door Hinge for V2.4 Remixed/Magnetic_door_hinge_v1/magnetic_door_hinge_2.5mm.stl

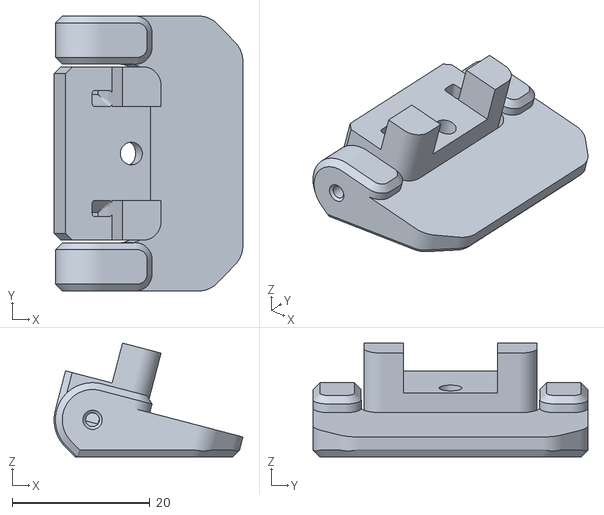
[picture p68: CAD file, 2026-05-18]
00_My_Build/STLs/Magnetic Door Hinge for V2.4 Remixed/Magnetic_door_hinge_v1/magnetic_door_hinge_2.5mm.stl
27.5 x 40.0 x 16.6
