casktura/SIBOOR-Voron-2.4-AUG/00_My_Build/STLs/Ultra Cool BTT Octopus Stepper Driver Fan Duct/Slip Cover v3.stl

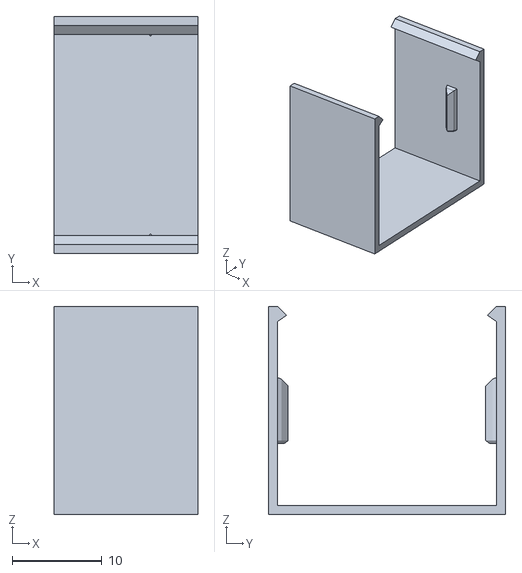
[picture p69: CAD file, 2026-06-09]
00_My_Build/STLs/Ultra Cool BTT Octopus Stepper Driver Fan Duct/Slip Cover v3.stl
16.0 x 26.4 x 23.2
