casktura/SIBOOR-Voron-2.4-AUG/00_My_Build/STLs/Voron 2.4 Magnetic Door Hinges/Door hinge mag.step

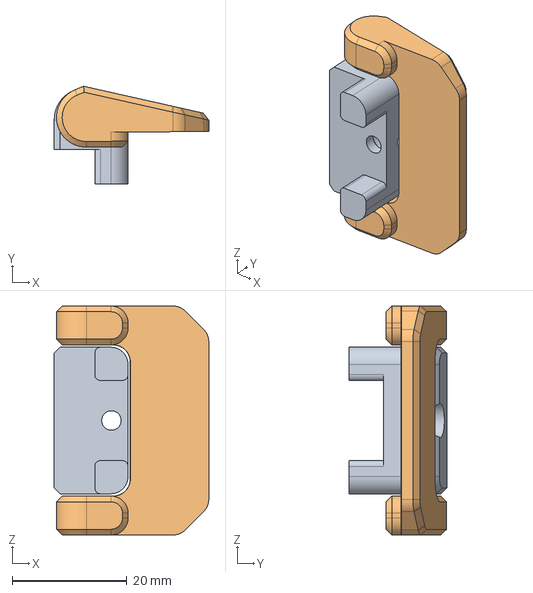
[picture p70: CAD file, 2026-05-18]
00_My_Build/STLs/Voron 2.4 Magnetic Door Hinges/Door hinge mag.step
27.0 x 17.0 x 40.0 mm
Magnetic door hinge int
Magnetic door hing ext
