casktura/SIBOOR-Voron-2.4-AUG/00_My_Build/STLs/Annes Engineering - Panel Clips/Source/hinge/qr/STL/support_plate_3.5mm_mirror.stl

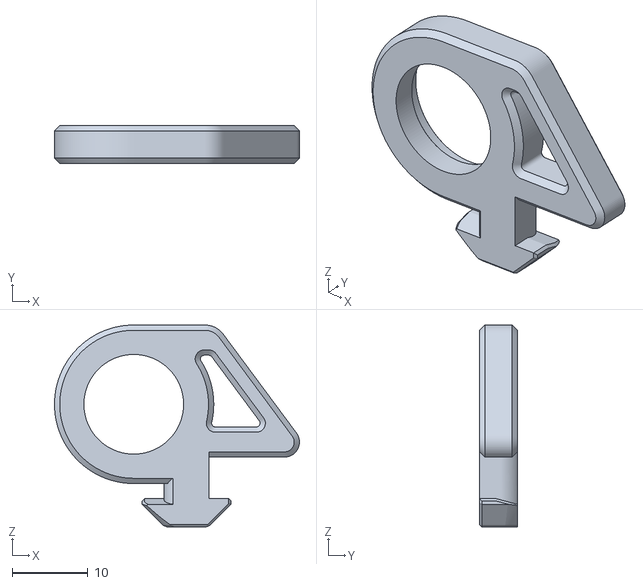
[picture p71: CAD file, 2026-05-06]
00_My_Build/STLs/Annes Engineering - Panel Clips/Source/hinge/qr/STL/support_plate_3.5mm_mirror.stl
32.5 x 5.00 x 26.8
