casktura/SIBOOR-Voron-2.4-AUG/00_My_Build/STLs/Annes Engineering - Panel Clips/Source/panel_clips_and_corners/key/CAD/key_asymmetric_8.5.STEP

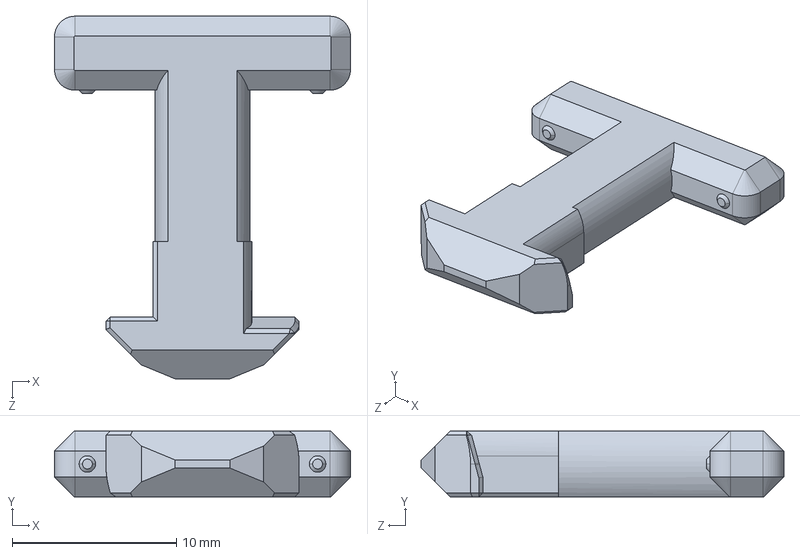
[picture p73: CAD file, 2026-05-06]
00_My_Build/STLs/Annes Engineering - Panel Clips/Source/panel_clips_and_corners/key/CAD/key_asymmetric_8.5.STEP
18.0 x 4.00 x 22.1 mm
