casktura/SIBOOR-Voron-2.4-AUG/00_My_Build/STLs/Annes Engineering - Panel Clips/Source/panel_latch/STLs/base.STL

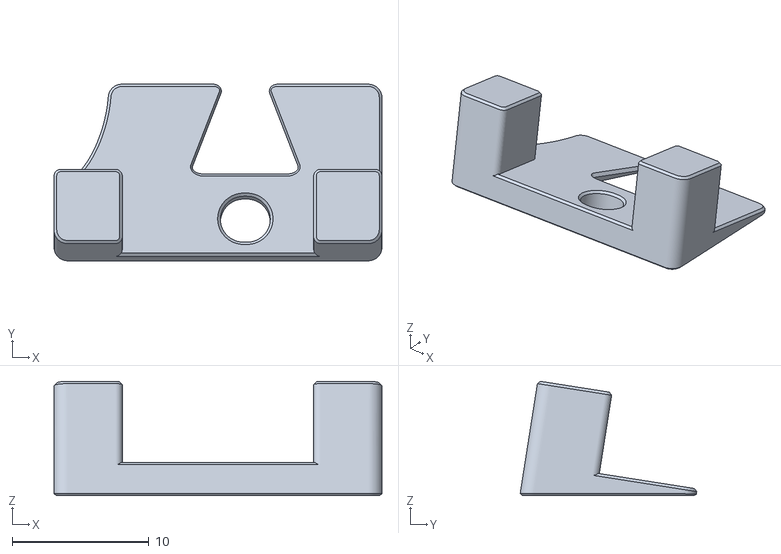
[picture p74: CAD file, 2026-05-06]
00_My_Build/STLs/Annes Engineering - Panel Clips/Source/panel_latch/STLs/base.STL
24.0 x 12.9 x 8.37
