casktura/SIBOOR-Voron-2.4-AUG/00_My_Build/STLs/Front Door M3/hinge_mount_x4.stl

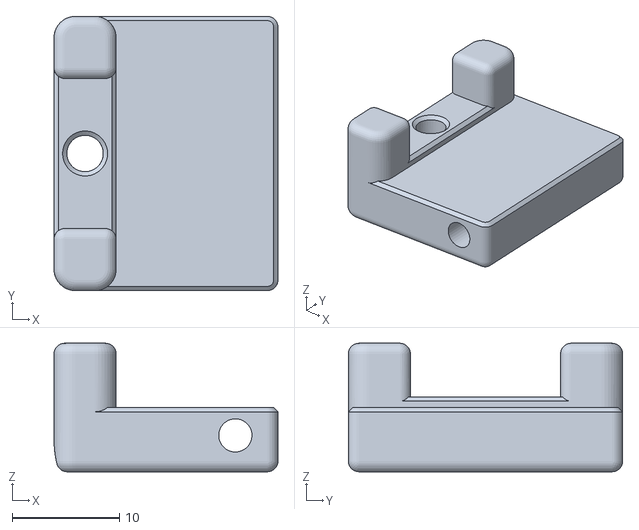
[picture p75: CAD file, 2026-05-06]
00_My_Build/STLs/Front Door M3/hinge_mount_x4.stl
20.9 x 25.6 x 12.0
