casktura/SIBOOR-Voron-2.4-AUG/00_My_Build/STLs/GT2 Belt Tension Meter/STLs/Needle 01-RC2.stl

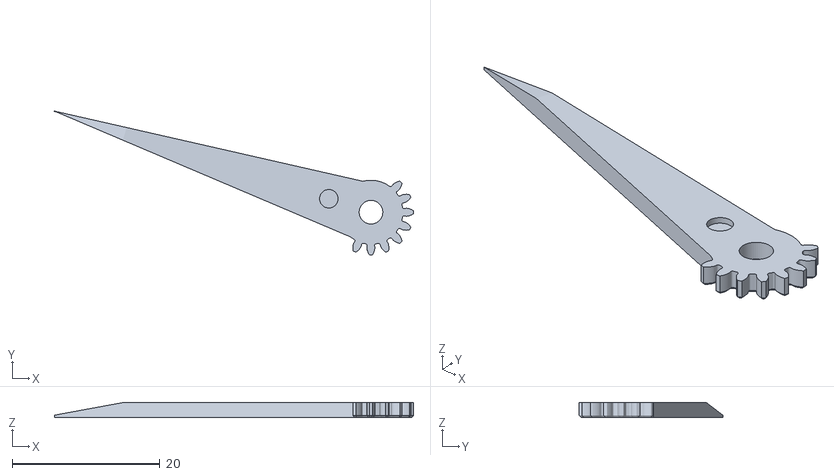
[picture p76: CAD file, 2026-06-15]
00_My_Build/STLs/GT2 Belt Tension Meter/STLs/Needle 01-RC2.stl
48.6 x 19.5 x 2.00
