casktura/SIBOOR-Voron-2.4-AUG/00_My_Build/STLs/Voron 2.4 Magnetic Door Hinges/Door-mag-hinge.3mf

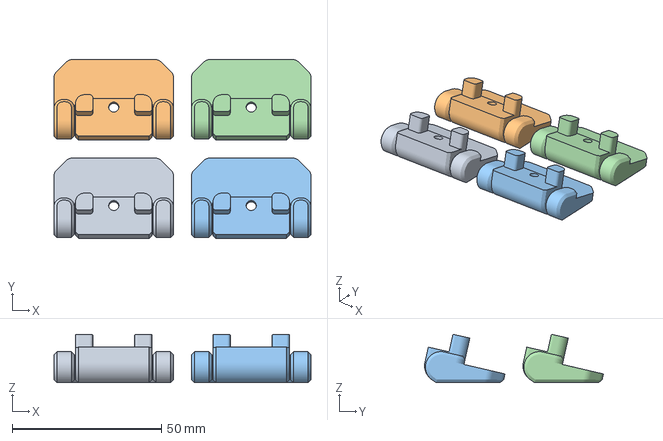
[picture p78: CAD file, 2026-05-18]
00_My_Build/STLs/Voron 2.4 Magnetic Door Hinges/Door-mag-hinge.3mf
86.0 x 59.9 x 16.2 mm
