casktura/SIBOOR-Voron-2.4-AUG/00_My_Build/STLs/Annes Engineering - Panel Clips/Source/panel_clips_and_corners/corner/CAD/corner_lock_body_9.STEP

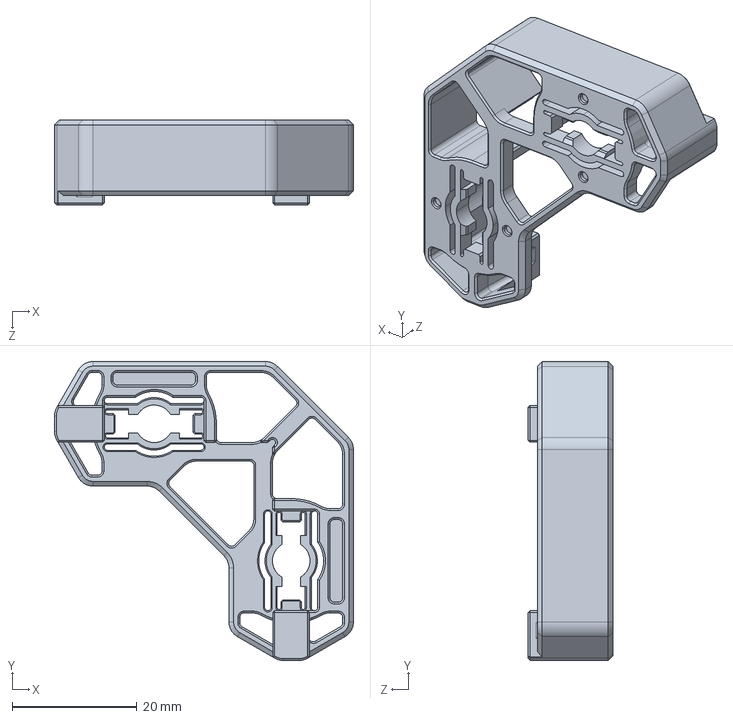
[picture p79: CAD file, 2026-05-06]
00_My_Build/STLs/Annes Engineering - Panel Clips/Source/panel_clips_and_corners/corner/CAD/corner_lock_body_9.STEP
48.0 x 48.0 x 13.6 mm
