casktura/SIBOOR-Voron-2.4-AUG/00_My_Build/STLs/Annes Engineering - Panel Clips/Source/panel_clips_and_corners/key/CAD/key_asymmetric_7.STEP

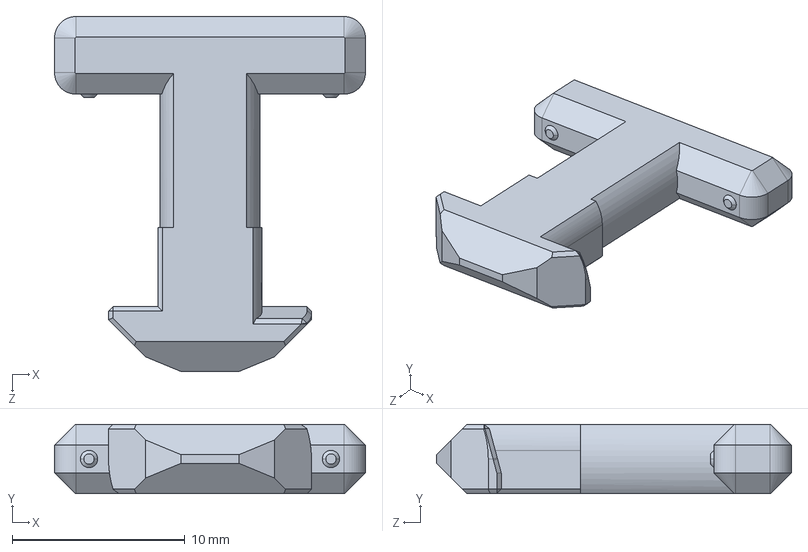
[picture p81: CAD file, 2026-05-06]
00_My_Build/STLs/Annes Engineering - Panel Clips/Source/panel_clips_and_corners/key/CAD/key_asymmetric_7.STEP
18.0 x 4.00 x 20.6 mm
