casktura/SIBOOR-Voron-2.4-AUG/00_My_Build/STLs/BTT HDMI5 V1.2 display mount Voron/btt-hdmi5-v1-2-mount-bracket_clicky-clack.stl

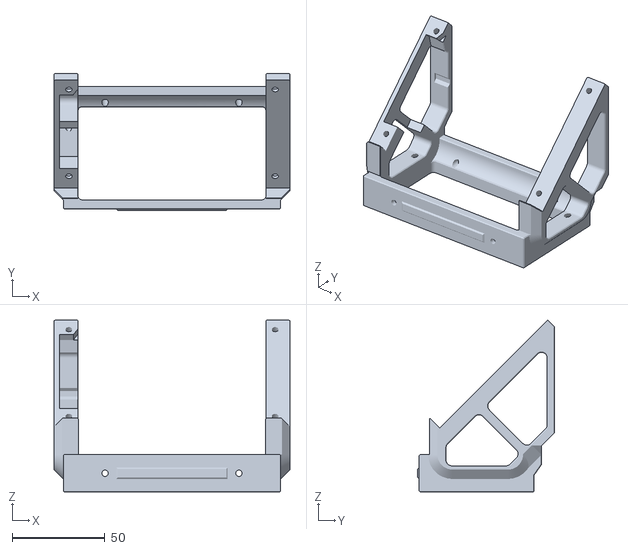
[picture p83: CAD file, 2026-06-15]
00_My_Build/STLs/BTT HDMI5 V1.2 display mount Voron/btt-hdmi5-v1-2-mount-bracket_clicky-clack.stl
127.0 x 73.8 x 92.4
