casktura/SIBOOR-Voron-2.4-AUG/00_My_Build/STLs/Magnetic Door Hinge for V2.4 Remixed/Magnetic_door_hinge_v2 Tape_mount/magnetic_door_hinge_tape_v2__10mm.stl

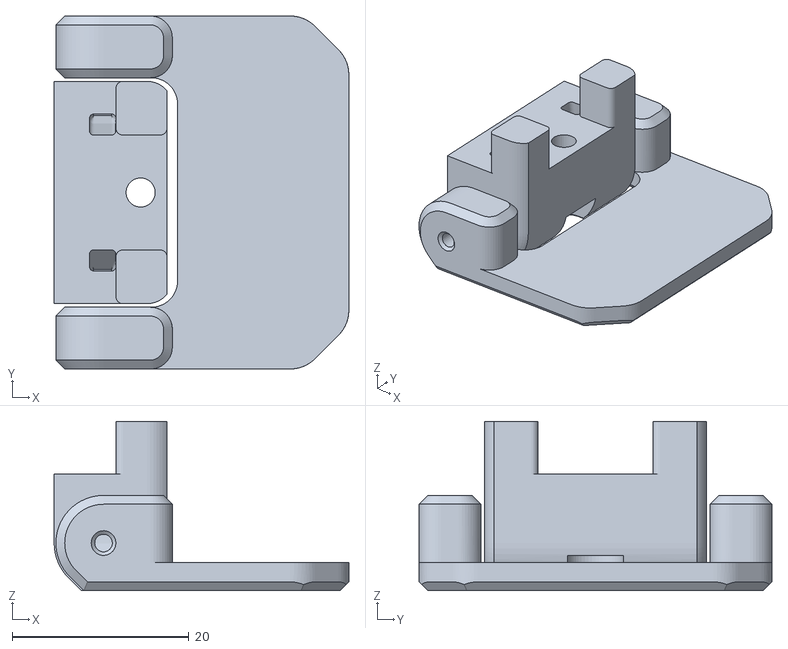
[picture p85: CAD file, 2026-05-18]
00_My_Build/STLs/Magnetic Door Hinge for V2.4 Remixed/Magnetic_door_hinge_v2 Tape_mount/magnetic_door_hinge_tape_v2__10mm.stl
33.4 x 40.0 x 19.2
