casktura/SIBOOR-Voron-2.4-AUG/00_My_Build/STLs/Voron 2.4 Magnetic Door Hinges/Door-holder.3mf

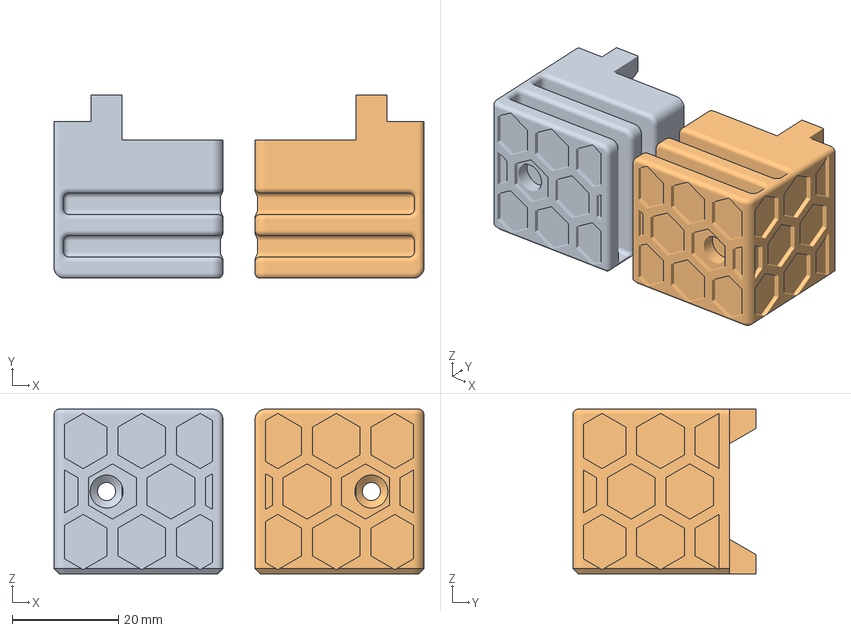
[picture p87: CAD file, 2026-05-18]
00_My_Build/STLs/Voron 2.4 Magnetic Door Hinges/Door-holder.3mf
69.6 x 34.5 x 31.0 mm
Door-holder-left.stl
Door-holder-right.stl
