casktura/SIBOOR-Voron-2.4-AUG/00_My_Build/STLs/Annes Engineering - Panel Clips/Source/panel_clips_and_corners/key/CAD/key_asymmetric_4.5.STEP

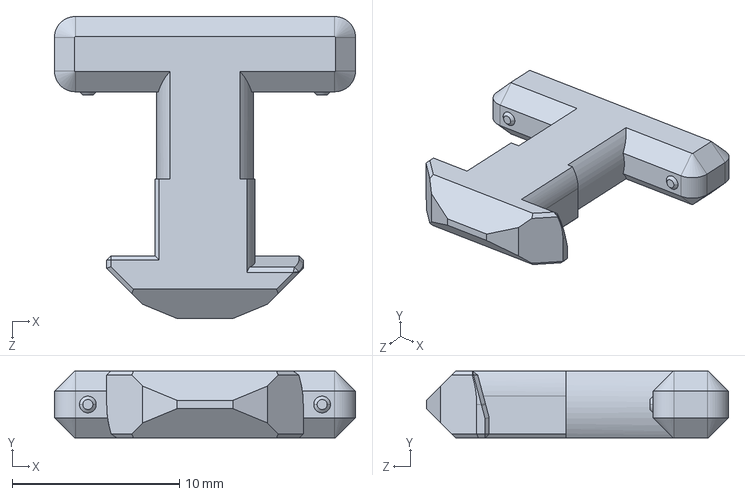
[picture p90: CAD file, 2026-05-06]
00_My_Build/STLs/Annes Engineering - Panel Clips/Source/panel_clips_and_corners/key/CAD/key_asymmetric_4.5.STEP
18.0 x 4.00 x 18.1 mm
