casktura/SIBOOR-Voron-2.4-AUG/00_My_Build/STLs/Ultra Cool BTT Octopus Stepper Driver Fan Duct/Octopus_Stepper_Duct Fan Base.stl

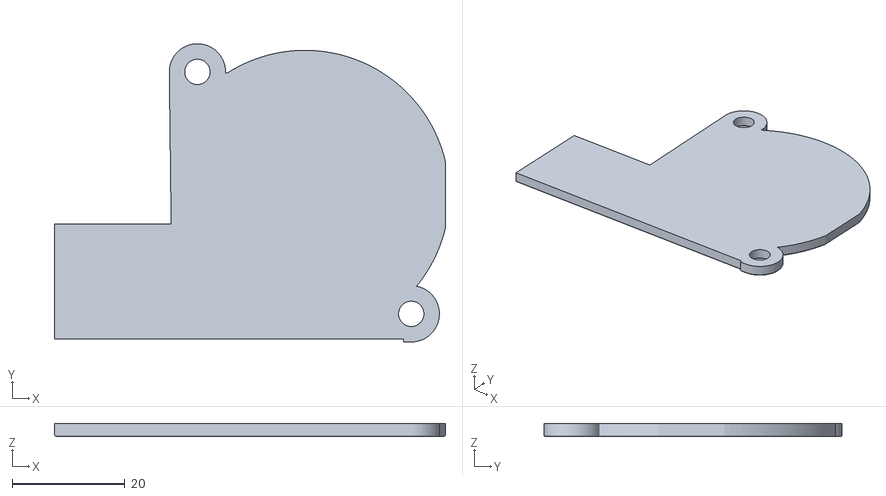
[picture p94: CAD file, 2026-06-09]
00_My_Build/STLs/Ultra Cool BTT Octopus Stepper Driver Fan Duct/Octopus_Stepper_Duct Fan Base.stl
69.5 x 53.0 x 2.30
