casktura/SIBOOR-Voron-2.4-AUG/00_My_Build/STLs/GT2 Belt Tension Meter/STLs/Meter Slide-RC2 .stl

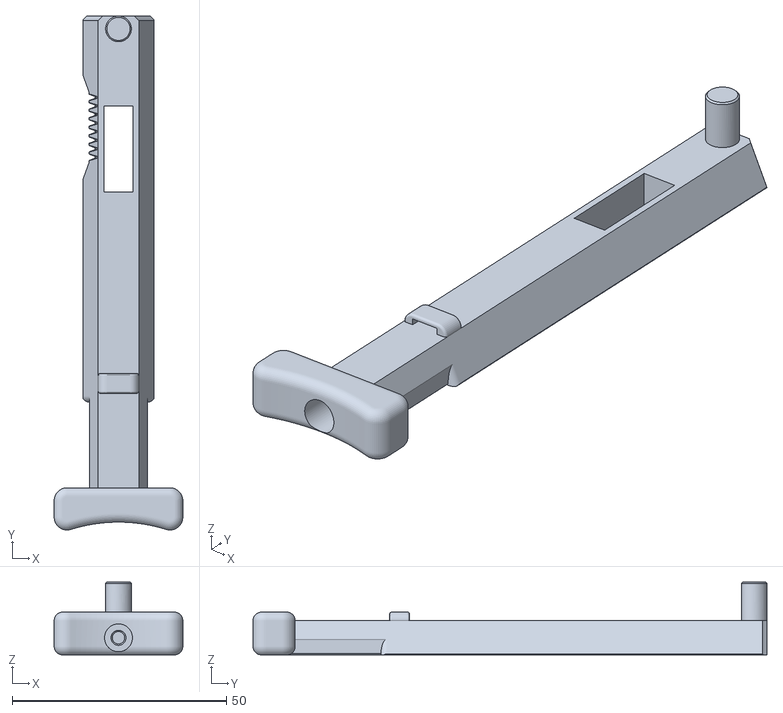
[picture p99: CAD file, 2026-06-15]
00_My_Build/STLs/GT2 Belt Tension Meter/STLs/Meter Slide-RC2 .stl
30.0 x 119.8 x 17.0
