casktura/SIBOOR-Voron-2.4-AUG/00_My_Build/STLs/GT2 Belt Tension Meter/STLs/Spring Block-RC2.stl

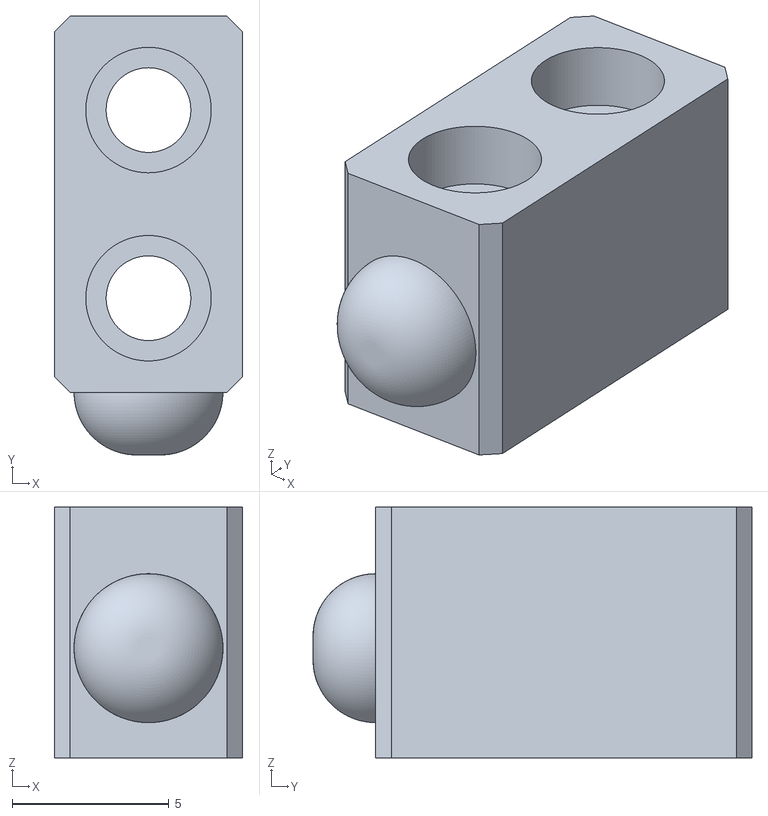
[picture p103: CAD file, 2026-06-15]
00_My_Build/STLs/GT2 Belt Tension Meter/STLs/Spring Block-RC2.stl
6.00 x 14.0 x 8.00
