casktura/SIBOOR-Voron-2.4-AUG/00_My_Build/STLs/GT2 Belt Tension Meter/STLs/Spring Spacer-RC2.stl

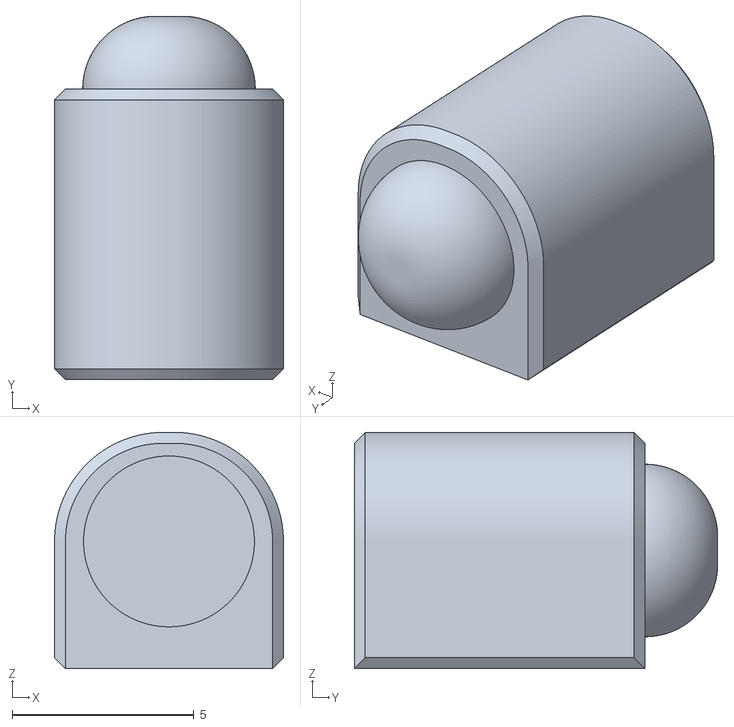
[picture p110: CAD file, 2026-06-15]
00_My_Build/STLs/GT2 Belt Tension Meter/STLs/Spring Spacer-RC2.stl
6.30 x 10.0 x 6.50
