casktura/SIBOOR-Voron-2.4-AUG/00_My_Build/STLs/GT2 Belt Tension Meter/STLs/GT2 Calibration Wire Pivot 0.032.stl

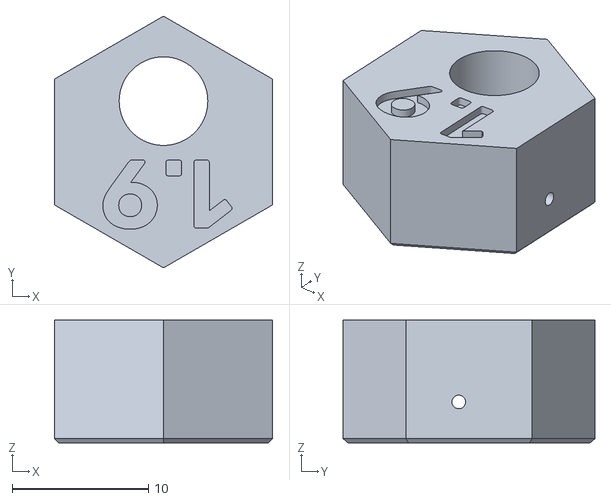
[picture p115: CAD file, 2026-06-15]
00_My_Build/STLs/GT2 Belt Tension Meter/STLs/GT2 Calibration Wire Pivot 0.032.stl
16.0 x 18.5 x 9.00
