casktura/SIBOOR-Voron-2.4-AUG/00_My_Build/STLs/Magnetic Door Hinge for V2.4 Remixed/Magnetic_door_hinge_v2 Tape_mount/magnetic_door_hinge_tape_v2__9mm.stl

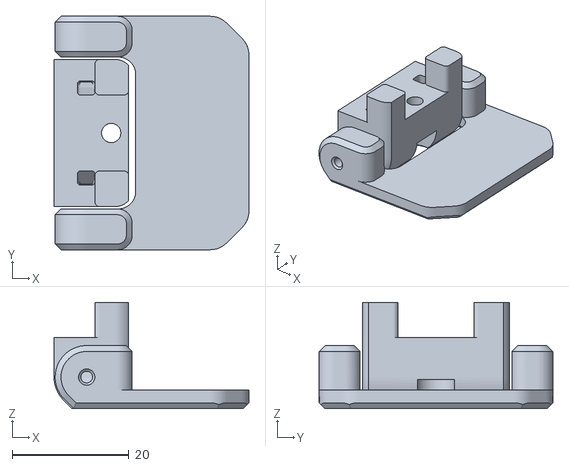
[picture p116: CAD file, 2026-05-18]
00_My_Build/STLs/Magnetic Door Hinge for V2.4 Remixed/Magnetic_door_hinge_v2 Tape_mount/magnetic_door_hinge_tape_v2__9mm.stl
33.4 x 40.0 x 18.2
