casktura/SIBOOR-Voron-2.4-AUG/(list of files, cad)

Other CAD files:
00_My_Build/STLs/BTT HDMI5 V1.2 Display Voron V2.4 Mount/btt-hdmi5-v12-mount.step
00_My_Build/STLs/Nevermore V6 Carbon Filter- Easy Lid Remix With Magnets/Superseeded/door-v14.step
00_My_Build/STLs/Voron 2.4 Magnetic Door Hinges/Door holder left.step
00_My_Build/STLs/Annes Engineering - Panel Clips/Source/hinge/qr/STL/support_plate_6mm.stl
00_My_Build/STLs/Annes Engineering - Panel Clips/Source/panel_clips_and_corners/key/CAD/key_asymmetric_6.STEP
00_My_Build/STLs/Annes Engineering - Panel Clips/Source/panel_latch/STLs/left.STL
00_My_Build/STLs/Front Door M3/hinge_right_x2.stl
00_My_Build/STLs/Magnetic Door Hinge for V2.4 Remixed/Magnetic_door_hinge_v2 Tape_mount/magnetic_door_hinge_tape_v2__2.5mm.stl
00_My_Build/STLs/Nevermore V6 Carbon Filter- Easy Lid Remix With Magnets/catridge-90-v16.step
00_My_Build/STLs/Nevermore V6 Carbon Filter- Easy Lid Remix With Magnets/Superseeded/cartridge-straight-v14.step
00_My_Build/STLs/Voron Rollback Stands/left-rocker.stl
00_My_Build/STLs/Annes Engineering - Panel Clips/Source/panel_clips_and_corners/corner/CAD/corner_lock_body_4.STEP
00_My_Build/STLs/Annes Engineering - Panel Clips/Source/panel_clips_and_corners/single/CAD/lock_body_8.5mm.STEP
00_My_Build/STLs/Annes Engineering - Panel Clips/Source/panel_support/simple/STL/front_panel_support_simple_3-75mm.stl
00_My_Build/STLs/Magnetic Door Hinge for V2.4 Remixed/Magnetic_door_hinge_v1/magnetic_door_hinge_3.5mm.stl
00_My_Build/STLs/Voron Rollback Stands/leftrocker3mmtape.stl
00_My_Build/STLs/Annes Engineering - Panel Clips/Source/hinge/qr/STL/support_plate_3.5mm.stl
00_My_Build/STLs/Magnetic Door Hinge for V2.4 Remixed/Magnetic_door_hinge_v1/magnetic_door_hinge_3mm.stl
00_My_Build/STLs/Voron Rollback Stands/right-rocker.stp
00_My_Build/STLs/Annes Engineering - Panel Clips/Source/panel_clips_and_corners/corner/CAD/corner_lock_body_6.STEP
00_My_Build/STLs/Magnetic Door Hinge for V2.4 Remixed/Magnetic_door_hinge_v1/magnetic_door_hinge_5.5mm.stl
00_My_Build/STLs/Magnetic Door Hinge for V2.4 Remixed/Magnetic_door_hinge_v2 Tape_mount/magnetic_door_hinge_tape_v2__3mm.stl
00_My_Build/STLs/BTT HDMI5 V1.2 display mount Voron/btt-hdmi5-v1_2-mount-frame_regular.stl
00_My_Build/STLs/Magnetic Door Hinge for V2.4 Remixed/Magnetic_door_hinge_v1/magnetic_door_hinge_4.5mm.stl
00_My_Build/STLs/Magnetic Door Hinge for V2.4 Remixed/Magnetic_door_hinge_v2 Tape_mount/magnetic_door_hinge_tape_v2_nologo__7.5mm.stl
00_My_Build/STLs/Annes Engineering - Panel Clips/Source/panel_clips_and_corners/key/CAD/key_asymmetric_5.STEP
00_My_Build/STLs/Magnetic Door Hinge for V2.4 Remixed/Magnetic_door_hinge_v1/magnetic_door_hinge_5mm.stl
00_My_Build/STLs/Magnetic Door Hinge for V2.4 Remixed/Magnetic_door_hinge_v2 Tape_mount/magnetic_door_hinge_tape_v2__10.5mm.stl
00_My_Build/STLs/GT2 Belt Tension Meter/STLs/Needle 04-RC2.stl
00_My_Build/STLs/Magnetic Door Hinge for V2.4 Remixed/Magnetic_door_hinge_v2 Tape_mount/magnetic_door_hinge_tape_v2_nologo__6.5mm.stl
00_My_Build/STLs/Annes Engineering - Panel Clips/Source/panel_clips_and_corners/corner/CAD/corner_lock_body_5.STEP
00_My_Build/STLs/Annes Engineering - Panel Clips/Source/panel_clips_and_corners/single/CAD/lock_body_6mm.STEP
00_My_Build/STLs/Magnetic Door Hinge for V2.4 Remixed/Magnetic_door_hinge_v2 Tape_mount/magnetic_door_hinge_tape_v2_nologo__5mm.stl
00_My_Build/STLs/Annes Engineering - Panel Clips/Source/hinge/screw_mount/R4/STL/arm_4.5mm.stl
00_My_Build/STLs/Annes Engineering - Panel Clips/Source/hinge/screw_mount/R4/STL/arm_4mm.stl
00_My_Build/STLs/Annes Engineering - Panel Clips/Source/hinge/screw_mount/R4/STL/arm_6mm.stl
00_My_Build/STLs/Annes Engineering - Panel Clips/Source/hinge/screw_mount/R4/STL/bearing_mount.stl
00_My_Build/STLs/Annes Engineering - Panel Clips/Source/hinge/screw_mount/R4/STL/bearing_mount_mirror.stl
00_My_Build/STLs/Annes Engineering - Panel Clips/Source/hinge/screw_mount/R4_625/STL/arm_625_4.5mm.stl
00_My_Build/STLs/Annes Engineering - Panel Clips/Source/hinge/screw_mount/R4_625/STL/arm_625_6mm.stl
00_My_Build/STLs/Annes Engineering - Panel Clips/Source/hinge/screw_mount/R4_625/STL/bearing_mount_625.stl
00_My_Build/STLs/Annes Engineering - Panel Clips/Source/hinge/screw_mount/R4_625/STL/bearing_mount_625_mirror.stl
00_My_Build/STLs/Annes Engineering - Panel Clips/Source/hinge/screw_mount/R4_glass_alpha/STL/arm_1_8_in.stl
00_My_Build/STLs/Annes Engineering - Panel Clips/Source/hinge/screw_mount/R4_glass_alpha/STL/arm_3mm_p_3mm_f.stl
00_My_Build/STLs/Annes Engineering - Panel Clips/Source/hinge/screw_mount/R4_glass_alpha/STL/screw_plate.stl
00_My_Build/STLs/Annes Engineering - Panel Clips/Source/hinge/screw_mount/R5_hd/STL/arm_front_3p_2.6f.stl
00_My_Build/STLs/Annes Engineering - Panel Clips/Source/hinge/screw_mount/R5_hd/STL/arm_front_3p_3f.stl
00_My_Build/STLs/Annes Engineering - Panel Clips/Source/hinge/screw_mount/R5_hd/STL/arm_rear_3p_2.6f.stl
00_My_Build/STLs/Annes Engineering - Panel Clips/Source/hinge/screw_mount/R5_hd/STL/arm_rear_3p_3f.stl
00_My_Build/STLs/Annes Engineering - Panel Clips/Source/panel_clips_and_corners/corner/CAD/corner_lock_body_3.STEP
00_My_Build/STLs/Annes Engineering - Panel Clips/Source/panel_clips_and_corners/corner/CAD/corner_lock_body_5.5.STEP
00_My_Build/STLs/Annes Engineering - Panel Clips/Source/panel_clips_and_corners/corner/CAD/corner_lock_body_7.STEP
00_My_Build/STLs/Annes Engineering - Panel Clips/Source/panel_clips_and_corners/corner/CAD/corner_lock_body_8.STEP
00_My_Build/STLs/Annes Engineering - Panel Clips/Source/panel_clips_and_corners/corner/STL/corner_lock_body_10.STL
00_My_Build/STLs/Annes Engineering - Panel Clips/Source/panel_clips_and_corners/corner/STL/corner_lock_body_3.5.STL
00_My_Build/STLs/Annes Engineering - Panel Clips/Source/panel_clips_and_corners/corner/STL/corner_lock_body_3.STL
00_My_Build/STLs/Annes Engineering - Panel Clips/Source/panel_clips_and_corners/corner/STL/corner_lock_body_4.5.STL
00_My_Build/STLs/Annes Engineering - Panel Clips/Source/panel_clips_and_corners/corner/STL/corner_lock_body_5.5.STL
00_My_Build/STLs/Annes Engineering - Panel Clips/Source/panel_clips_and_corners/corner/STL/corner_lock_body_6.5.STL
00_My_Build/STLs/Annes Engineering - Panel Clips/Source/panel_clips_and_corners/corner/STL/corner_lock_body_7.5.STL
00_My_Build/STLs/Annes Engineering - Panel Clips/Source/panel_clips_and_corners/corner/STL/corner_lock_body_7.STL
00_My_Build/STLs/Annes Engineering - Panel Clips/Source/panel_clips_and_corners/corner/STL/corner_lock_body_8.5.STL
00_My_Build/STLs/Annes Engineering - Panel Clips/Source/panel_clips_and_corners/corner/STL/corner_lock_body_8.STL
00_My_Build/STLs/Annes Engineering - Panel Clips/Source/panel_clips_and_corners/corner/STL/corner_lock_body_9.5.STL
00_My_Build/STLs/Annes Engineering - Panel Clips/Source/panel_clips_and_corners/corner/STL/corner_lock_body_9.STL
00_My_Build/STLs/Annes Engineering - Panel Clips/Source/panel_clips_and_corners/corner_2060/CAD/corner_lock_body_2060_4.5.STEP
00_My_Build/STLs/Annes Engineering - Panel Clips/Source/panel_clips_and_corners/corner_2060/CAD/corner_lock_body_2060_5.5.STEP
00_My_Build/STLs/Annes Engineering - Panel Clips/Source/panel_clips_and_corners/corner_2060/CAD/corner_lock_body_2060_6.STEP
00_My_Build/STLs/Annes Engineering - Panel Clips/Source/panel_clips_and_corners/corner_2060/CAD/corner_lock_body_2060_9.STEP
00_My_Build/STLs/Annes Engineering - Panel Clips/Source/panel_clips_and_corners/corner_2060/STL/corner_lock_body_2060_10.STL
00_My_Build/STLs/Annes Engineering - Panel Clips/Source/panel_clips_and_corners/corner_2060/STL/corner_lock_body_2060_3.5.STL
00_My_Build/STLs/Annes Engineering - Panel Clips/Source/panel_clips_and_corners/corner_2060/STL/corner_lock_body_2060_3.STL
00_My_Build/STLs/Annes Engineering - Panel Clips/Source/panel_clips_and_corners/corner_2060/STL/corner_lock_body_2060_4.5.STL
00_My_Build/STLs/Annes Engineering - Panel Clips/Source/panel_clips_and_corners/corner_2060/STL/corner_lock_body_2060_4.STL
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
