casktura/SIBOOR-Voron-2.4-AUG/00_My_Build/STLs/BTT HDMI5 V1.2 display mount Voron/README.md

- https://www.printables.com/model/926845-btt-hdmi5-v12-display-mount-voron
