casktura/SIBOOR-Voron-2.4-AUG/00_My_Build/STLs/BTT HDMI5 V1.2 Display Voron V2.4 Mount/README.md

- https://www.printables.com/model/1185031-btt-hdmi5-v12-display-voron-v24-mount
