casktura/SIBOOR-Voron-2.4-AUG/00_My_Build/STLs/Mellow StealthBurner LED/README.md

- https://mellow.klipper.cn/en/docs/ProductDoc/ExtensionBoard/fly-sb-led/wiring
