casktura/SIBOOR-Voron-2.4-AUG/00_My_Build/STLs/Nevermore V6 Carbon Filter- Easy Lid Remix With Magnets/README.md

- https://www.printables.com/model/1230986-nevermore-v6-carbon-filter-easy-lid-remix-with-mag
