casktura/SIBOOR-Voron-2.4-AUG/00_My_Build/STLs/Ultra Cool BTT Octopus Stepper Driver Fan Duct/README.md

- https://www.printables.com/model/494141-ultra-cool-btt-octopus-stepper-driver-fan-duct
