casktura/SIBOOR-Voron-2.4-AUG/00_My_Build/STLs/Annex Clip Wrench/README.md

- https://www.printables.com/model/1222151-annex-clips-wrench
