casktura/SIBOOR-Voron-2.4-AUG/00_My_Build/STLs/Magnetic Door Hinge for V2.4 Remixed/README.md

- https://www.printables.com/model/359114-magnetic-door-hinge-for-v24-remixed
