casktura/SIBOOR-Voron-2.4-AUG/00_My_Build/STLs/Voron 2.4 Magnetic Door Hinges/README.md

- https://www.printables.com/model/221377-voron-24-magnetic-door-hinges
