casktura/SIBOOR-Voron-2.4-AUG/00_My_Build/STLs/2020 Extrusion Cable Clips/README.md

- https://www.printables.com/model/142395-2020-extrusion-cable-clips-flush-and-guide
