casktura/SIBOOR-Voron-2.4-AUG/00_My_Build/STLs/Annes Engineering - Panel Clips/README.md

- https://github.com/Annex-Engineering/Annex-Engineering_User_Mods/tree/main/Printers/All_Printers/annex_dev-Panel_2020_Clips_and_Hinges
