casktura/SIBOOR-Voron-2.4-AUG/00_My_Build/STLs/Exhaust Cover/README.md

- https://mods.vorondesign.com/details/sChDLllFG34KYroxSym6MQ
- https://github.com/VoronDesign/VoronUsers/tree/main/printer_mods/Fiction/Exhaust_cover
