casktura/SIBOOR-Voron-2.4-AUG/00_My_Build/STLs/Front Door M3/README.md

- https://github.com/VoronDesign/VoronUsers/tree/main/printer_mods/quattroerik/front_door_m3_180_deg_3mm
