casktura/SIBOOR-Voron-2.4-AUG/00_My_Build/STLs/Voron 2.4 Carrying Handle/README.md

- https://www.printables.com/model/450348-voron-24-trident-carrying-handle
