casktura/SIBOOR-Voron-2.4-AUG/00_My_Build/STLs/Voron Chamber Temperature Sensor Mount/README.md

- https://www.printables.com/model/473545-voron-chamber-temperature-sensor-mount
