casktura/SIBOOR-Voron-2.4-AUG/00_My_Build/STLs/Voron Exhaust Cover BTT SFS V2.0 Mount/README.md

- https://www.printables.com/model/907509-voron-exhaust-cover-btt-sfs-v20-mount
