casktura/SIBOOR-Voron-2.4-AUG/00_My_Build/STLs/Voron Rollback Stands/README.md

- https://www.printables.com/model/408015-voron-rollback-stands
