casktura/SIBOOR-Voron-2.4-AUG/00_My_Build/STLs/GT2 Belt Tension Meter/Manual/GT2_Tensiometer_Assembly_Manual.pdf

# GT2 Belt Tensiometer

(RC2)

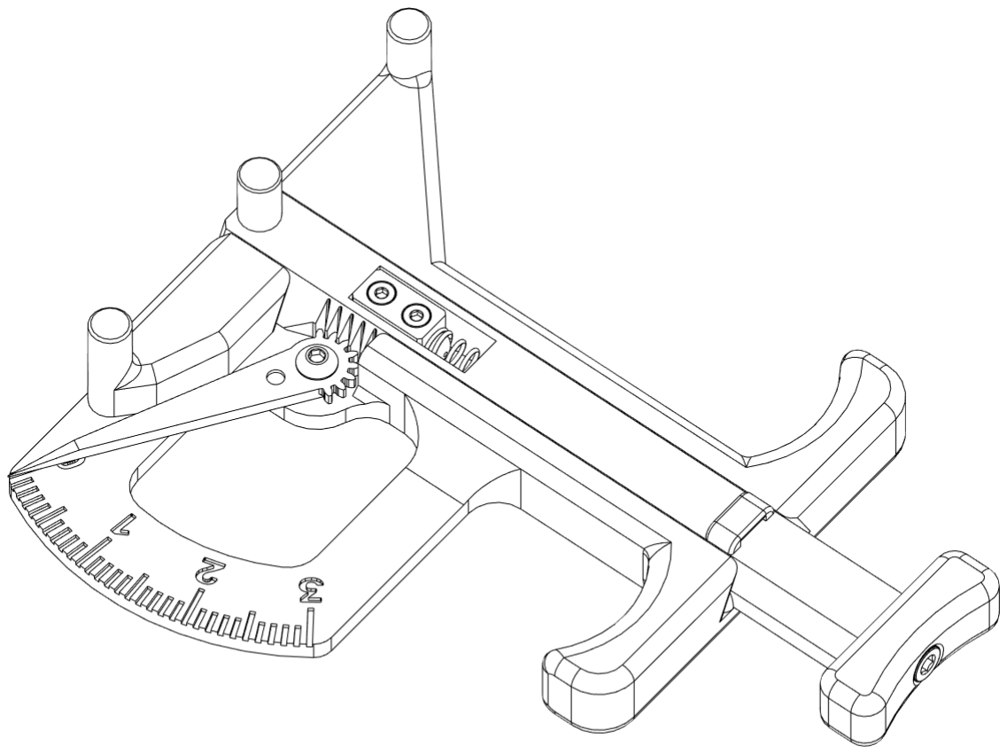
[picture p145: figure]

DETAILS:

This 3D printed tension meter is designed to measure belt deflection to determine belt tension for Gates 6 and 9mm GT2 belts. The goal is to eliminate the need for phone apps that use frequency to determine tension and to provide an easily quantifiable and repeatable number to use when tensioning belts on a 3D printer. The repeatability and accuracy of this meter will be partially dependent on the build quality but you can expect approximately ± 1.0N (0.25lb) accuracy on a carefully built and calibrated meter.

BOM:

- 1x M3x7 Button Head Cap Screw (or M3x6 BHCS if available)
- 1x M3x25 Socket Head Cap Screw
- 1x M3x8x0.6 Washer
- 2x M2x10 Socket Head Self Tapping Screws
- 1x 0.81mm x 100mm (0.032” x 4”) tempered straight steel music wire
- 1x 6mm OD x 0.6mm wire dia. x 50mm free length compression spring with 20 active coils (0.35N/mm spring rate)

TOOLS:

- M3 drill bit and holder
- ABS safe grease such as SuperLube Synthetic or Oatey/Harvey's silicone grease
- 1.5, 2, and 2.5mm hex bit drivers. Ball end hex keys will likely give you a hard time here.
- Toothpicks and Q-tips for applying grease
- Hobby knife (X-Acto)
- Small flat needle file (optional)
- Small triangular smooth cut file (for cleaning up gear teeth and slide channel if needed)
- Cutter capable of cutting hardened music wire (do NOT use your nice flush cutters for this)

PRINT SETTINGS:

- Print in ABS or ASA for best results
- Slide, needles and spring spacer components work best when printed on smooth or satin PEI
- Layer height 0.2mm
- 4 perimeters 5 top and 5 bottom layers
- 40% grid infill

- 0.4mm nozzle with 0.4mm line width throughout
- No seams allowed on needle or slide gear teeth, use blockers or adjust seam settings in your slicer
- Color change at layer 18 for Base and layer 43 Pivot for dual color contrasting text.
- Print one of each needle sizes for ease of assembly/tuning
- Your printer should be well tuned for this project (for example, able to produce a near-perfect Voron cube). Any PA issues or over/under extrusion will likely result in a poorly performing meter

ASSEMBLY:

1. Clean up printed parts as needed. Correct any zits, blobs or other print defects using a small file or hobby knife. Pay special attention to the gear teeth on the slide and needle. Carefully remove any stringing or blobs taking care not to change the tooth profile.
2. Check the fit between the slide and base. It should be loose enough to drop into the base freely without using force.
3. Using a cotton swab, apply a light layer of grease to the spring channel in the shaded area shown below. Do not lubricate the meter Base or Slide dovetail area as stiction may occur causing inaccurate readings.

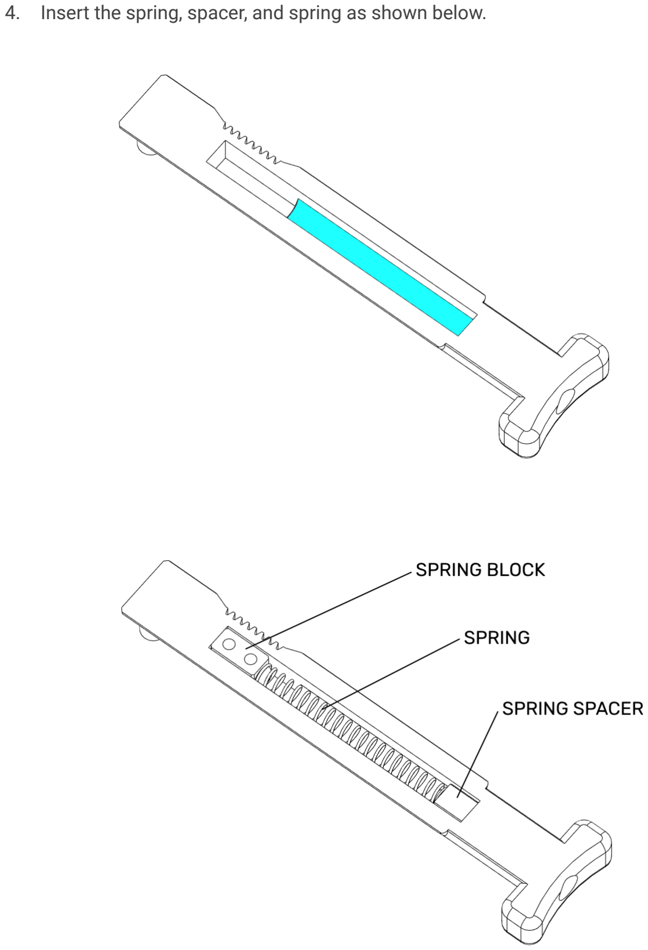
[picture p146: page 4]

4. Insert the spring, spacer, and spring as shown below.

5. Insert the spring spacer, spring and spring block in that order as shown. Note of the position of the counterbores on the spring block, they should be facing down in this step.
6. Flip the assembled slide and carefully insert the slide into the base as shown below. Spring tension should hold the parts in place.

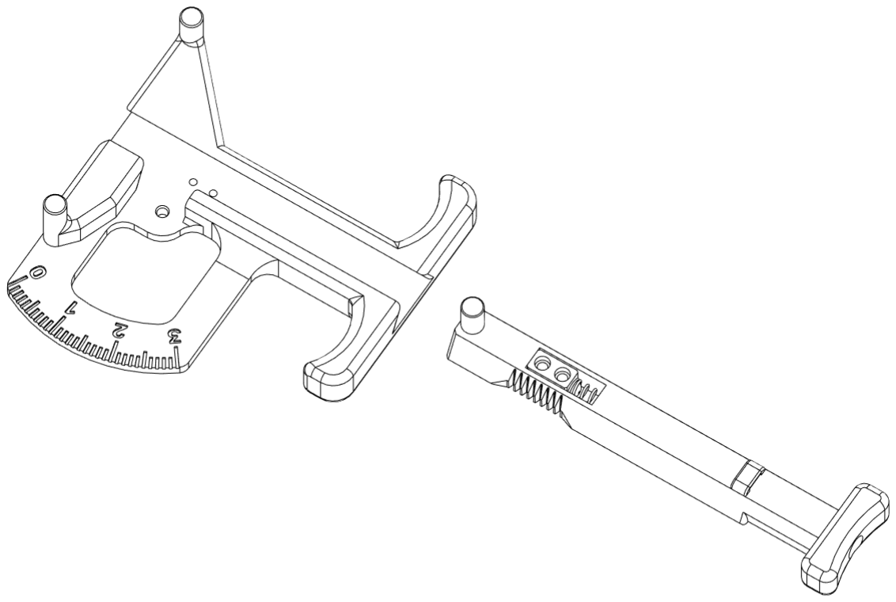
[picture p147: figure]

7. Align the slide with the front of the base so that they are flush and the two holes in the spring block are aligned with the corresponding holes in the base.
8. Secure the spring block to the base using two self-tapping M2 screws.

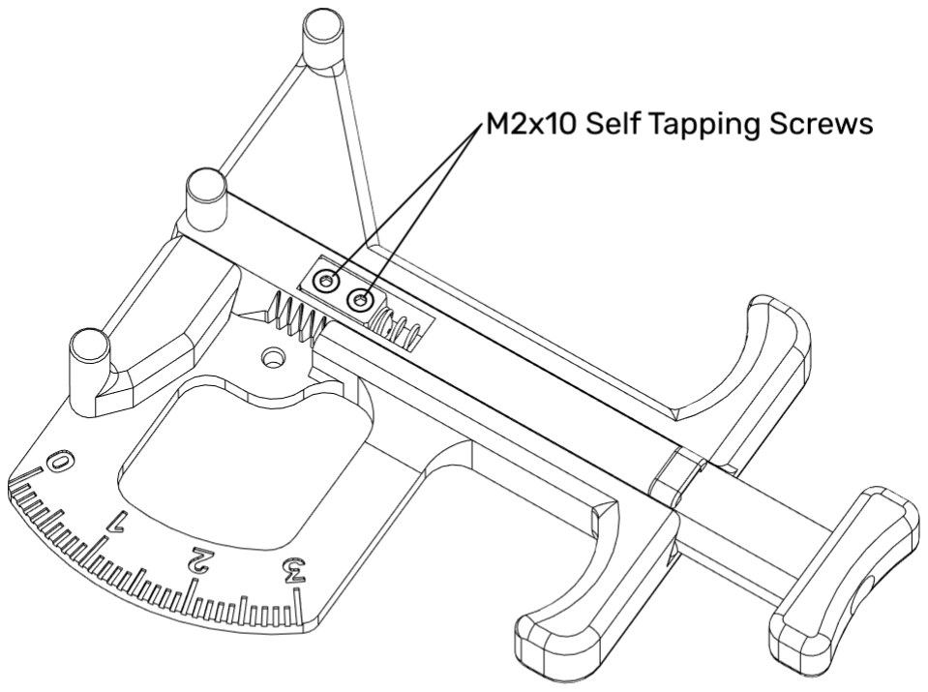
[picture p148: figure]

9. Depress slide plunger to check that the slide is moving smoothly and without binding.
10. Starting with a #2 needle use trial and error to determine the needle with the best fit. When aligned on the hole, the needle’s teeth will mesh with the slide’s teeth. The two holes should be close to concentric.

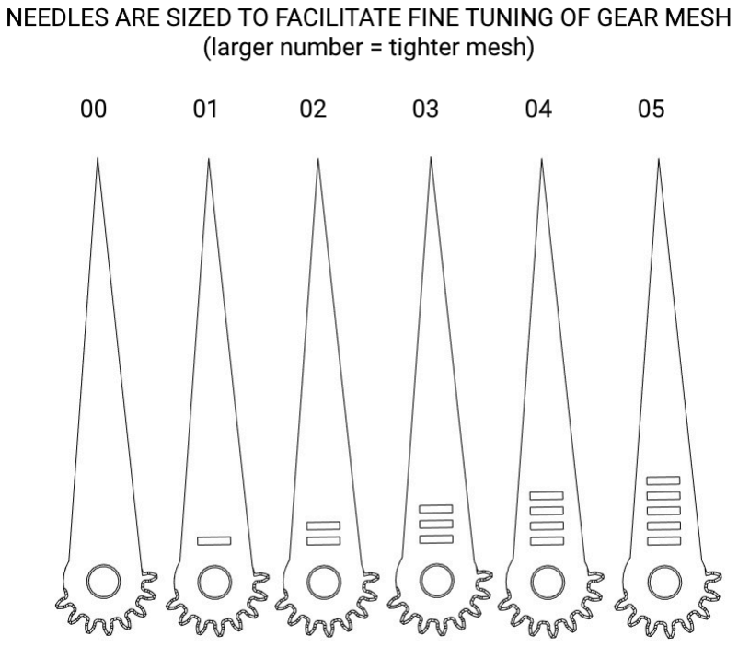
[picture p149: figure]

(Bottom view of needles showing sizing markers)

11. Ream the hole in the needle with a 3mm drill bit and check the fit using the M3x25 SHCS screw. The needle should rotate freely under its own weight. (tip: if you don’t own a 3mm drill bit you can use the M3x25 screw to ream the hole by screwing it into the needle and intentionally stripping the threads)
12. Insert the M3x6 BHCS through the top of the needle (as denoted by the circular stamp).
13. Place the M3x8 washer onto the base, aligning it with the hole with the smoothest side up. (some washers have a burr from stamping, this should face down for best result)

14. Secure the needle onto the washer with the M3x7 BHCS, making sure the needle aligns to the zero position and the round divot is facing up.

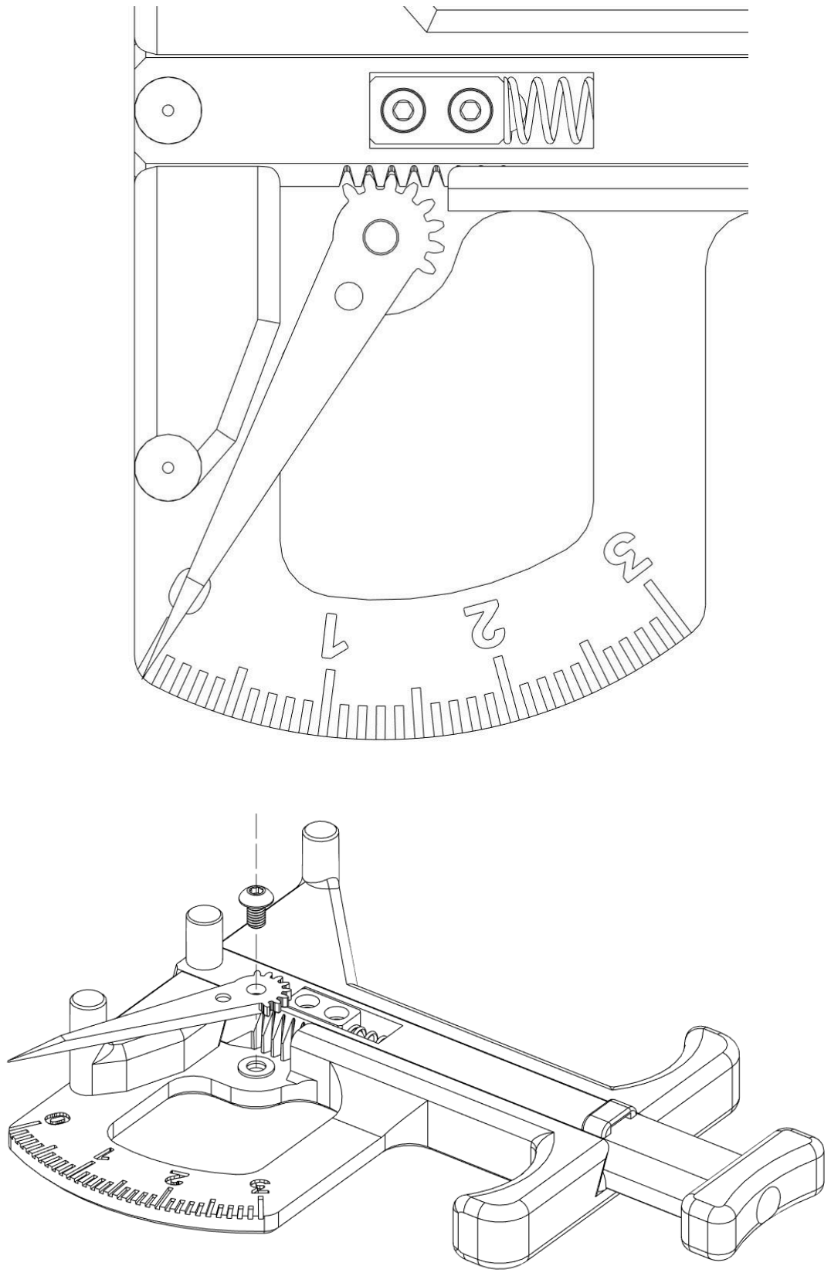
[picture p150: page 9]

15. Tighten screw until just snug then back off in small increments until the needle moves freely.
16. Depress the slide’s plunger several times to ensure that the needle moves freely without jumping or binding.
17. Check the needle’s backlash by gently wiggling with a finger. If the needle moves more than one tick on the dial, swap to the next size up and repeat this test. You want a needle size that gives you the least amount of backlash while still allowing smooth motion of the slide.
18. Once you have the correct needle selected, use a toothpick or similar to apply a very small amount of grease to the areas shown below.
19. Test to confirm that the needle spins freely on the screw.

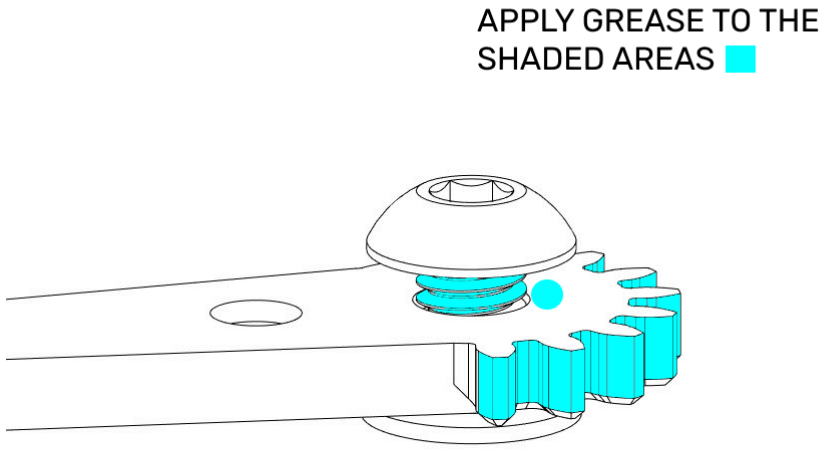
[picture p151: figure]

20. Flip the needle over and apply a very light layer of grease to the area that contacts the M3x8 washer, being careful not to get any on the lower threads.

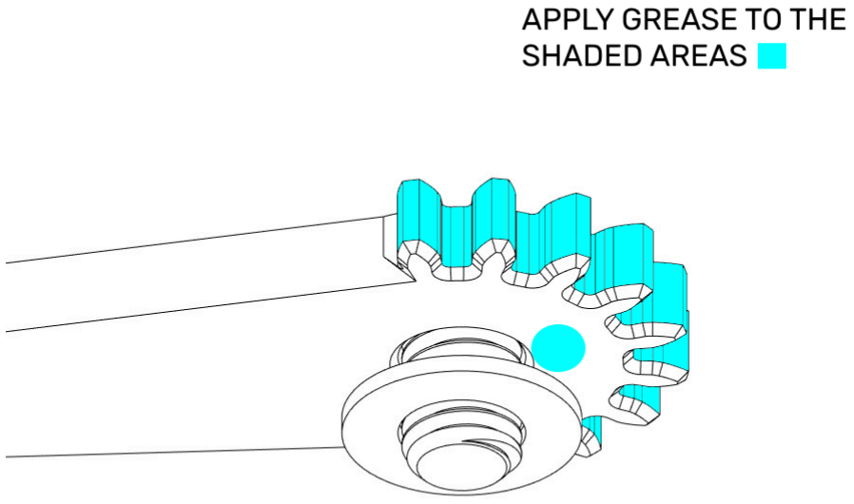
[picture p152: figure]

21. Apply a small amount of grease to the teeth on the needle as shown..
22. Place the M3x8 washer onto the base.
23. Again, tighten the screw until just snug then back off until the needle swings freely.
24. Cycle the slide 20-30 times to make sure grease is distributed and the gears mesh.
25. Slowly cycle the slide several times and observe the needle’s motion. It should be smooth throughout its entire range with no sticking or jumping. Adjust screw securing needle as needed to facilitate free movement.
26. Finally, install the M3x25 SHCS preload screw into the slide plunger as shown. This screw is threaded into plastic. Tighten until the head is flush with the plunger. Your meter is now assembled and ready for calibration.

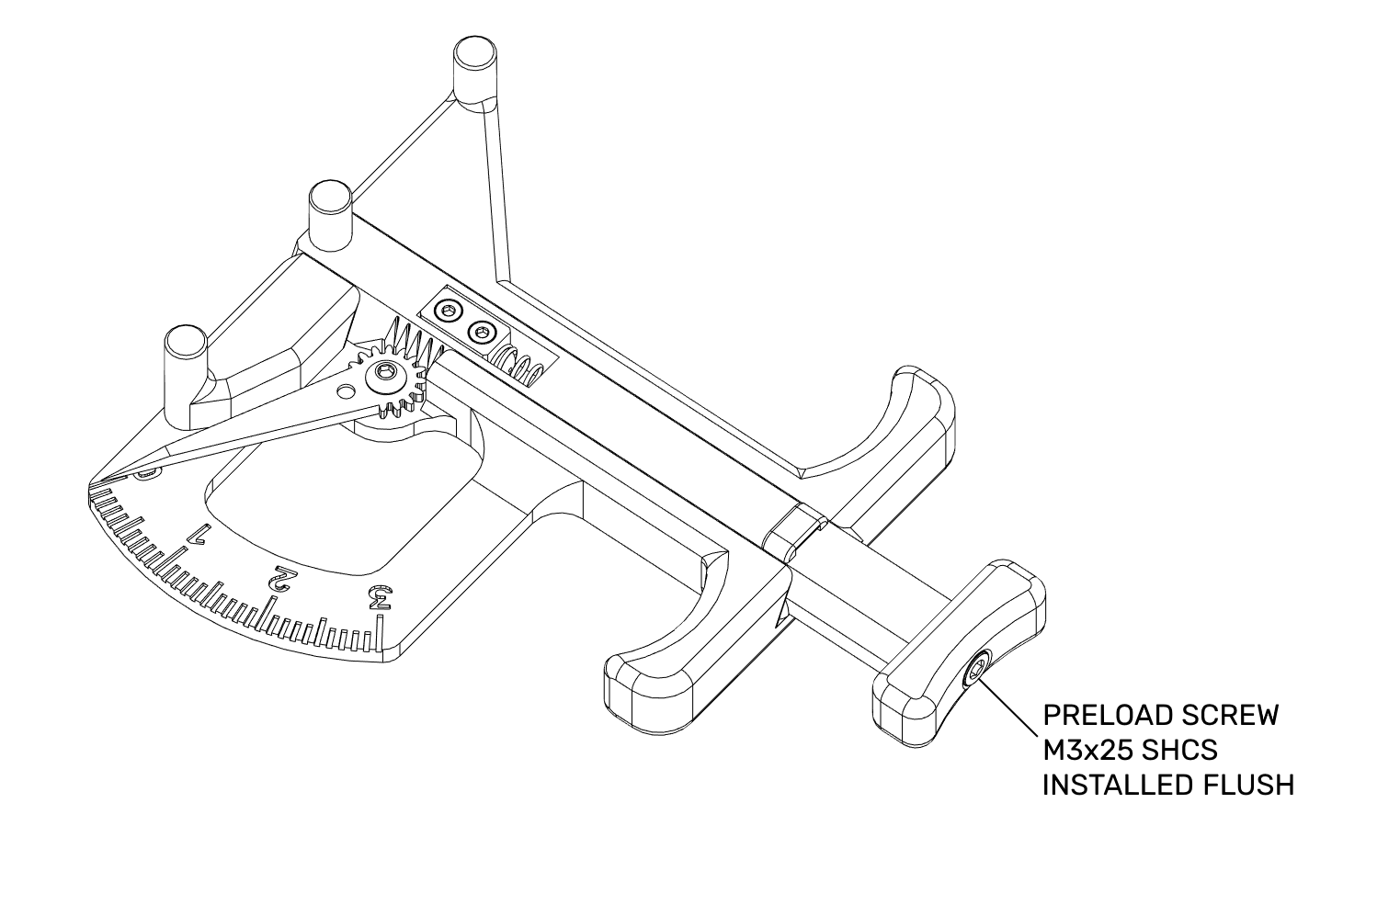
[picture p153: figure]

*Note: If your meter dial is not resting on the zero mark you may need to loosen the two self tapping screws in the spring block to adjust.

CALIBRATION:

1. Cut music wire to 100mm and deburr the ends with a file. (note: do not use your good side cutters for music wire, dremel cutoff or hard wire cutter
recommended)
2. Glue the wire into the hole on the side of the calibration handle making sure it is fully seated and flush on the opposite side. Afterwards remove any burrs or glue from the hole in the calibration pivot. It should rotate freely on the left pin when

installed.

3. Depress plunger and place calibration wire into the jaws making sure the pivot is seated all the way on the left pin as shown. Eye protection is recommended for this step.

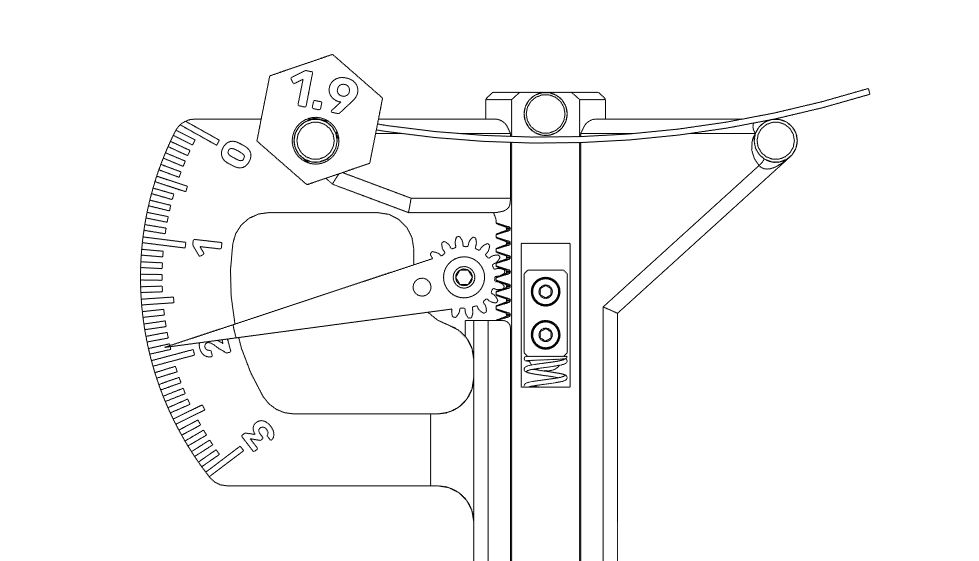
[picture p154: figure]

4. Release the plunger and note the reading on the dial. Lightly tapping or “pumping” the plunger handle can help to settle the needle and get a better reading.
5. Tighten the preload screw in the back of the plunger one turn then depress and release the plunger again. Note that the reading has changed.
6. Repeat steps 3 -5 until your meter consistently reads 1.9 when checking the deflection of the music wire.

7. Your meter is now calibrated and ready for use.

ALTERNATIVE CALIBRATION:

- If straight tempered music wire is not available a suitable weight and spare section of belt can be used. A gallon plastic water jug and scale works well for this. Do not trust weights marked on fitness equipment, weigh them first.
- Suspend a 1.36Kg (3lb) weight from a 250mm section of GT2 belt and measure the tension with the belt teeth in contact with the two outer pins on the meter as shown below in step 3.
- Adjust the preload screw as needed until the meter reads consistently across several measurements. 2.1 for standard rubber or 2.2 EPDM high temperature belt.

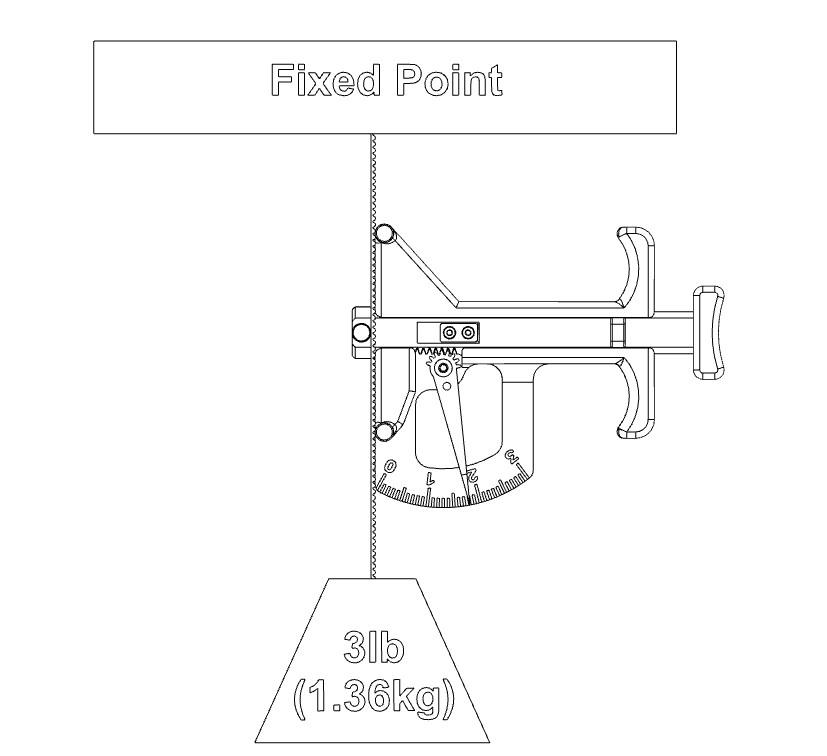
[picture p155: figure]

Calibration wire can be stowed on the center pin with wire secured beneath the slides wire keeper.

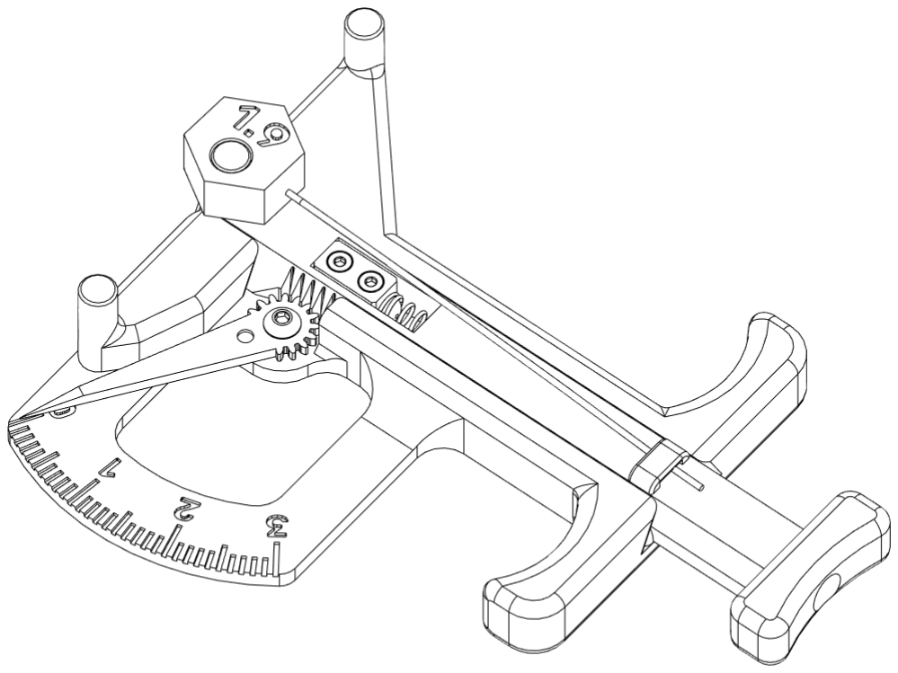
[picture p156: figure]

TENSION MEASUREMENT A/B BELTS:

1. Refer to your printer's documentation for proper belt tension or see table below
2. Issue G28 to home printer. Printer should be cold for this test.
3. Center toolhead on X and then move Y until the X/Y idler centers are 150mm from the front idler centers. Motors should be on for this test. (note: unlike phone apps the 150mm distance is not a critical distance just a way to ensure that the toolhead is centered and to aid in obtaining repeatable results)

4. Depress plunger and place meter on the 150mm belt span so that belt is routed through the gauge pins as shown.

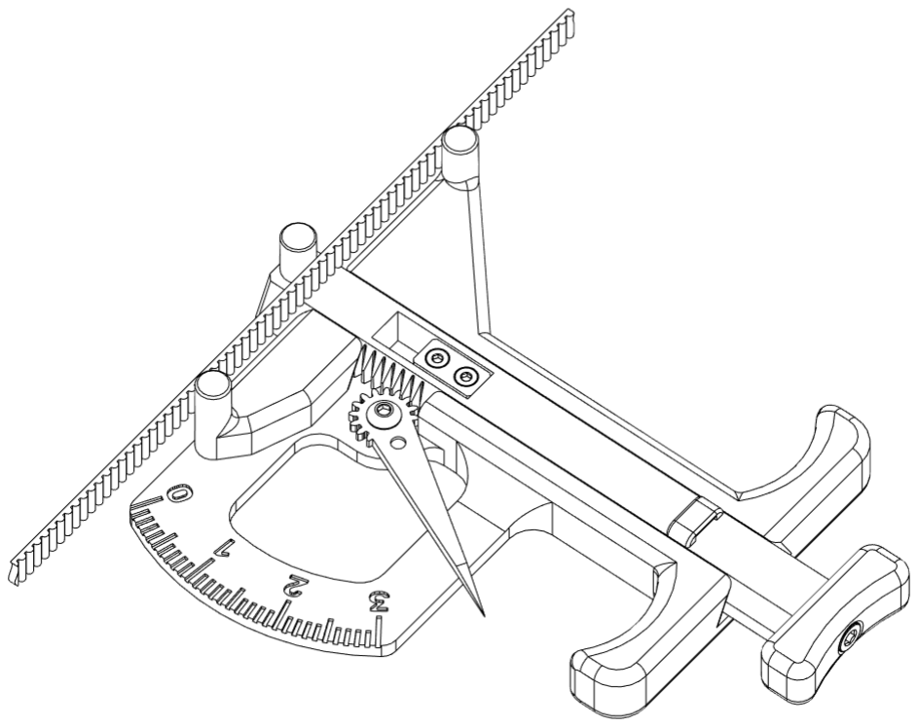
[picture p157: figure]

5. Slowly release the plunger and note the reading on the dial. *rocking the meter very slightly fore and aft or lightly “pumping” plunger can help to settle the needle and get an accurate reading.
6. Repeat three times to ensure you are getting consistent readings.
7. Adjust belt tension then repeat steps 3-5 until you reach the desired tension (see table below) The A/B belt tensions can affect each other. Tightening one will also tighten the other. Go back and forth adjusting each until they are equal.

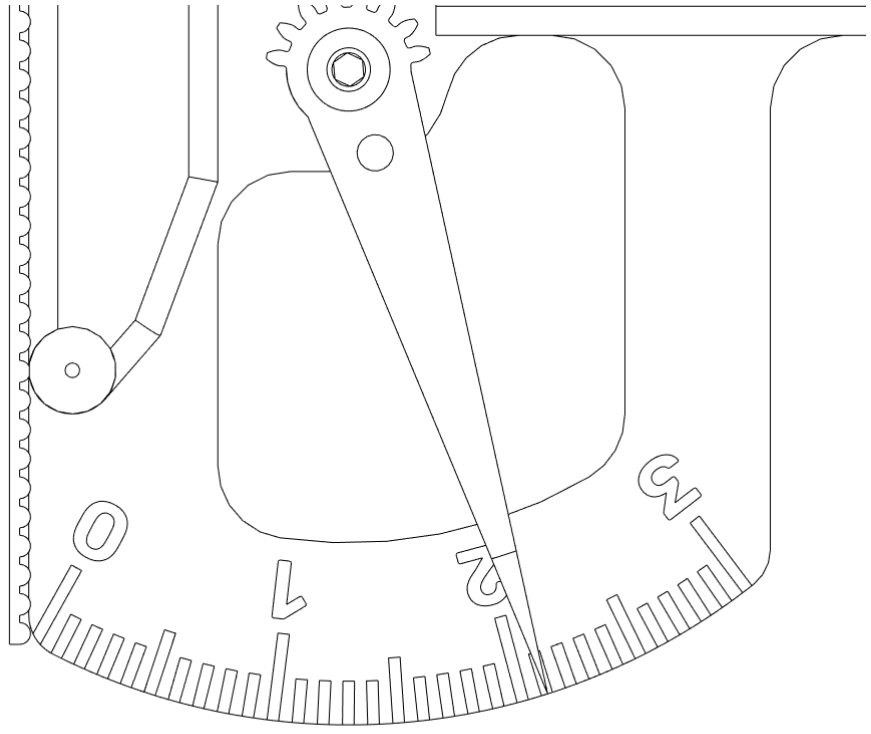
[picture p158: figure]

8. Home X and Y to seat the belts then repeat steps 2-5 to verify that tension is correct and make followup adjustments as needed.
9. Your belts should now be properly tensioned.

Note: Depending on your style of printer your belt tension may increase slightly when utilizing a heated chamber so keep this in mind when selecting tensions in the higher range. Check your belts after a preheat to be sure you are not exceeding safe limits. When checking tension always remember to run the measured axis through its full range of travel before measuring to normalize the tension in the belt path.

Tension guidelines for tested printers

PRINTER MODEL - BELT | MIN TENSION (meter reading) | MAX TENSION (meter reading)
Voron - A/B (all stock models) | 1.8 (1.9 EPDM) | 2.2 (2.3 EPDM)
Voron 2.4 and Micron - Z | 2.5 (2.6 EPDM) | 2.8 (2.9 EPDM)
Switchwire - “Z” | 1.8 (1.9 EPDM) | 2.2 (2.3 EPDM)
Bambu Lab X1 and P series | N/A | 2.4*
Prusa Mk3 and MK4 | 1.8** | 2.5**
Creality Ender3 | 1.8** | 2.2**

* Based on measurements taken from factory tensioned/calibrated printers.

** Based on common specifications for unsupported NEMA17 stepper motor shaft and community input.

6mm & 9mm GT2 and GT3

STATIC BELT TENSION N (lb) | METER READING (NEOPRENE) | METER READING (EPDM)
8.90 ( 2.0) | 1.8 | 1.9
11.12 (2.5) | 2.0 | 2.1
13.34 (3.0) | 2.1 | 2.2
15.57 (3.5) | 2.3 | 2.4
17.8 (4.0) | 2.4 | 2.5
20.02 (4.5) | 2.5 | 2.6
22.24 (5.0) | 2.6 | 2.7
24.47 (5.5) | 2.7 | 2.8
26.69 (6.0) | 2.8 | 2.9
29.40 (6.5) | 2.9 | 3.0

31.14 (7.0) | 3.0 | N/A

Common NEMA 14 & 17 Stepper Motor Maximum Radial Force Ratings

DISTANCE FROM STEPPER MOTOR FLANGE | 5mm | 10mm | 20mm
recommended Radial force: | 20N (4.5lb) | 13N (2.9lb) | 9N (2.0lb)
maximum Radial force: | 58N (13lb) | 37N (8.3lb) | 28N (6.8lb)

Radial Force = Static Belt Tension * 2

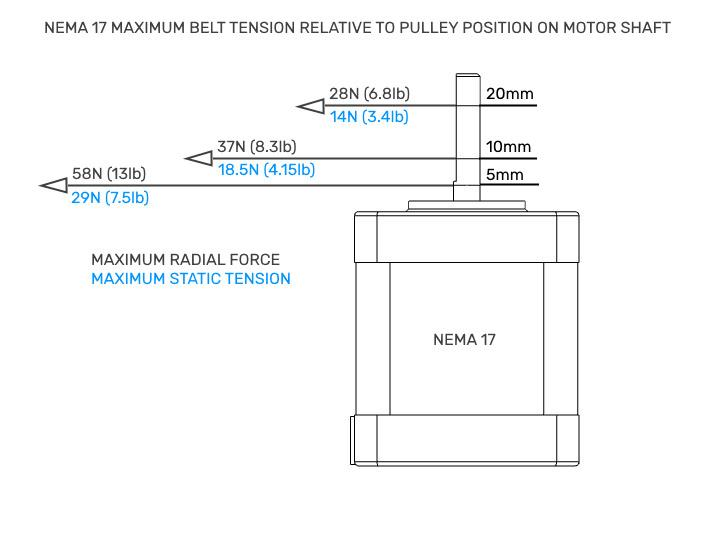
[picture p159: figure]

KITS:

- Complete Hardware Kits (https://www.etsy.com/listing/1508474957/hardware-kit-for-diy-3d-printer-belt?click_sum=25d1381a)
- Complete Assembled and Calibrated Meters (https://www.etsy.com/listing/1508462271/belt-tension-meter-for-3d-printers?click_sum=d5bdfbd0&frs=1)

HARDWARE SOURCES:

- Spring (https://www.amazon.com/dp/B076LTYY5K?psc=1&ref=ppx_yo2ov_dt_b_product_details)
- Music Wire (https://www.amazon.com/gp/product/B002WXGIHC/ref=ppx_yo_dt_b_search_asin_title?ie=UTF8&psc=1)
- Superlube Synthetic Grease (https://www.amazon.com/Super-Lube-21010-Grease/dp/B005R2NIIC) Tested NGLI 0 through 2
- Harvey's Silicone Grease (https://www.amazon.com/Wm-Harvey-050090-C-Silicone-Grease/dp/B000FPANUW)

REFERENCE:

- Stepper Info (http://ldomotors.com/products/show/42mm-hybrid-stepper-series)
- Belt Tension Calculators (https://www.clavis.co.uk/belt-calculator/)
- Spring Rate Calculator (https://www.acxesspring.com/compression-spring-calculations.html)

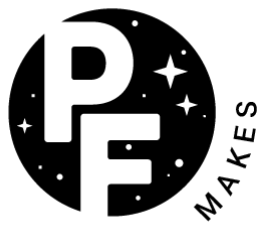
[picture p160: figure]

Manual Rev.G

This work is licensed under the Creative Commons Attribution-NonCommercial-ShareAlike 4.0 International License. To view a copy of this license, visit http://creativecommons.org/licenses/by-nc-sa/4.0/ or send a letter to Creative Commons, PO Box 1866, Mountain View, CA 94042, USA.
