casktura/SIBOOR-Voron-2.4-AUG/00_My_Build/[Klipper] EBB.png

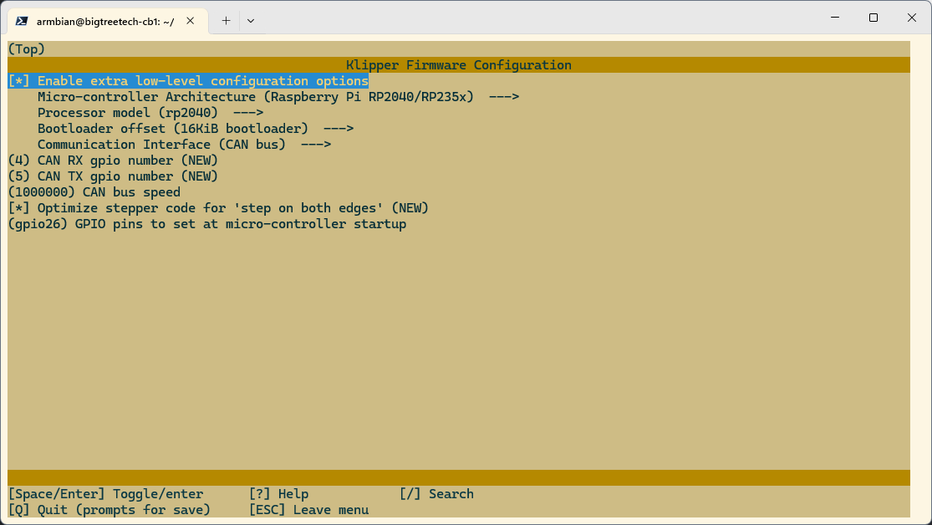
00_My_Build/[Klipper] EBB.png
