casktura/SIBOOR-Voron-2.4-AUG/00_My_Build/[Klipper] Octopus Pro.png

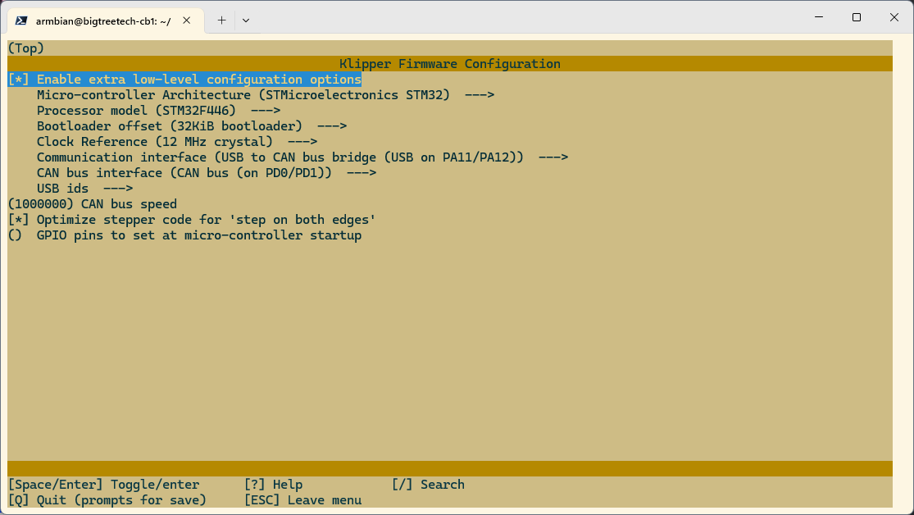
00_My_Build/[Klipper] Octopus Pro.png
