casktura/SIBOOR-Voron-2.4-AUG/00_My_Build/STLs/GT2 Belt Tension Meter/Images/LM3D.jpg

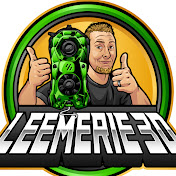
00_My_Build/STLs/GT2 Belt Tension Meter/Images/LM3D.jpg
