casktura/SIBOOR-Voron-2.4-AUG/00_My_Build/printer.cfg

[include mainsail.cfg]

#####################################################################
#                  Model and Acceleration
#####################################################################

[printer]
kinematics: corexy                     # Printer type: corexy.
max_velocity: 300                      # Maximum speed (max. 300 mm/s).
max_accel: 5000                        # Maximum acceleration (max. 5000 mm/s²).
minimum_cruise_ratio: 0.5
max_z_velocity: 15                     # Z-axis maximum speed (15 mm/s).
max_z_accel: 350                       # Z-axis maximum acceleration (350 mm/s²).
square_corner_velocity: 5.0            # Square corner velocity (5.0 mm/s).

#####################################################################
#                  MCU EBBCan
#####################################################################

[mcu EBBCan]
canbus_uuid: 747323232eb7              # CAN bus unique identifier for EBBCan MCU.

#####################################################################
#                  Cartographer V3 (ADXL 345)
#####################################################################

[mcu cartographer]
canbus_uuid: 14c8757f4532

[cartographer]
mcu: cartographer
x_offset: 0
y_offset: 21
verbose: no                            # For extra output.

[adxl345]
cs_pin: cartographer:PA3               # For Cartographer V3.
spi_bus: spi1

[resonance_tester]
accel_chip: adxl345
accel_chip_z: adxl345
probe_points: 175, 175, 20             # Fill out the blank with x and y coordinates where you want to run the resonance test.

[safe_z_home]
home_xy_position: 150,150              # Example home_xy_position: 175,175 - This would be for a 350 * 350mm bed.
z_hop: 5                               # Z axis hop height after homing.

#####################################################################
#                  MCU Octopus
#####################################################################

[mcu]
canbus_uuid: 1e691b91fae3              # CAN bus unique identifier for Octopus MCU.
canbus_interface: can0                 # CAN bus interface.

#####################################################################
#                  Temperature Monitoring
#####################################################################

[temperature_sensor EBB_SB2209]
sensor_type: Generic 3950                # Sensor type for NTC thermistor.
sensor_pin: EBBCan:gpio28                # Pin connected to NTC thermistor.

[temperature_sensor Octopus_Pro]
sensor_type: temperature_mcu

[temperature_sensor BTT_Pi]
sensor_type: temperature_host

[temperature_sensor Cartographer]
sensor_type: temperature_mcu
sensor_mcu: cartographer
min_temp: 5
max_temp: 105

[temperature_sensor Chamber]
sensor_type: Generic 3950
sensor_pin: PF4

#####################################################################
#                  B(X) ---------A(Y)
#                  |                |
#                  |                |
#                  |--------E-------|
#                  |                |
#                  |                |
#                  |                |
#####################################################################
#                  X-axis on MOTOR_0 (B Motor)
#####################################################################

[stepper_x]
step_pin: PF13                         # X-axis motor pulse pin setting.
dir_pin: PF12                          # X-axis motor direction pin setting.
enable_pin: !PF14                      # X-axis motor enable pin setting.
microsteps: 32                         # Motor microsteps setting.
rotation_distance: 40                  # Active pulley circumference in mm (2GT-20T pulley 40, 2GT-16T pulley 32).
full_steps_per_rotation: 200           # Number of pulses required for a single motor revolution (1.8 degree motor: 200, 0.9 degree motor: 400).
endstop_pin: EBBCan:gpio24             # Limit switch pin setting (X-).
position_min: 0                        # X-axis minimum travel - software limit.
position_endstop: 300                  # Mechanical reset point coordinates for X-axis (change to 350 for 350 models).
position_max: 300                      # X-axis maximum travel - software limit (change to 350 for 350 models).
homing_speed: 200
homing_retract_dist: 5                 # Setback distance after the first trigger of the reset switch.
homing_positive_dir: true              # Direction of reset (generally no change required).

[tmc2240 stepper_x]
cs_pin: PC4                            # Chip select pin for TMC2240 driver.
spi_software_sclk_pin: PA5             # SPI software clock pin.
spi_software_mosi_pin: PA7             # SPI software MOSI pin.
spi_software_miso_pin: PA6             # SPI software MISO pin.
driver_TPFD: 0                         # TMC2240 TPFD setting.
run_current: 1.2                       # Motor running current value (A).
driver_SLOPE_CONTROL: 3

#####################################################################
#                  Y-axis on MOTOR_1（A Motor）
#####################################################################

[stepper_y]
step_pin: PG0                          # Y-axis motor pulse pin setting.
dir_pin: PG1                           # Y-axis motor direction pin setting.
enable_pin: !PF15                      # Y-axis motor enable pin setting.
microsteps: 32                         # Motor microsteps setting.
rotation_distance: 40                  # Active pulley circumference in mm (2GT-20T pulley 40, 2GT-16T pulley 32).
full_steps_per_rotation: 200           # Number of pulses required for a single motor revolution (1.8 degree motor: 200, 0.9 degree motor: 400).
endstop_pin: PG9                       # Limit switch pin setting (Y-).
position_min: 0                        # Y-axis minimum travel - software limit.
position_endstop: 300                  # Mechanical reset point coordinates for Y-axis (change to 350 for 350 models).
position_max: 300                      # Y-axis maximum travel - software limit (change to 350 for 350 models).
homing_speed: 200
homing_retract_dist: 5                 # Setback distance after the first trigger of the reset switch.
homing_positive_dir: true              # Direction of reset (generally no change required).

[tmc2240 stepper_y]
cs_pin: PD11                           # Chip select pin for TMC2240 driver.
spi_software_sclk_pin: PA5             # SPI software clock pin.
spi_software_mosi_pin: PA7             # SPI software MOSI pin.
spi_software_miso_pin: PA6             # SPI software MISO pin.
driver_TPFD: 0                         # TMC2240 TPFD setting.
run_current: 1.2                       # Motor running current value (A).
driver_SLOPE_CONTROL: 3

#####################################################################
#                  z1 -------------- z2
#                  |                 |
#                  |                 |
#                  |                 |
#                  |                 |
#                  |                 |
#                  |                 |
#                  z0-----display----z3
#####################################################################
#                  Z0-axis on MOTOR_2 (left front)
#####################################################################

[stepper_z]
step_pin: PF11                         # Z-axis motor pulse pin.
dir_pin: PG3                           # Z-axis motor direction pin setting.
enable_pin: !PG5                       # Z-axis motor enable pin setting.
rotation_distance: 40                  # Active pulley circumference mm (2GT-20T pulley 40, 2GT-16T pulley 32).
gear_ratio: 80:16
microsteps: 32
endstop_pin: probe:z_virtual_endstop   # Limit switch interface.
position_max: 280                      # Maximum Z-axis print height, 350mm = 340.
position_min: -5                       # Soft Limit Minimum Stroke.
homing_speed: 50
second_homing_speed: 5
homing_retract_dist: 0                 # Retreat distance.

[tmc2240 stepper_z]
cs_pin: PC6                            # Chip select pin for TMC2240 driver.
spi_software_sclk_pin: PA5             # SPI software clock pin.
spi_software_mosi_pin: PA7             # SPI software MOSI pin.
spi_software_miso_pin: PA6             # SPI software MISO pin.
driver_TPFD: 0                         # TMC2240 TPFD setting.
driver_SLOPE_CONTROL: 3
interpolate: true                      # Enable 256 microstep interpolation.
run_current: 0.8                       # Motor running current value(mA).
stealthchop_threshold: 200             # Mute threshold.

#####################################################################
##                 Z1-axis on MOTOR_3 (left rear)
#####################################################################

[stepper_z1]
step_pin: PG4                          # Z1-axis motor pulse pin setting.
dir_pin: !PC1                          # Z1-axis motor direction pin setting.
enable_pin: !PA0                       # Z1-axis motor enable pin setting.
rotation_distance: 40                  # Active pulley circumference in mm (2GT-20T pulley 40, 2GT-16T pulley 32).
gear_ratio: 80:16                      # Reduction ratio.
microsteps: 32                         # Motor microsteps setting.

[tmc2240 stepper_z1]
cs_pin: PC7
spi_software_sclk_pin: PA5
spi_software_mosi_pin: PA7
spi_software_miso_pin: PA6
driver_TPFD: 0
driver_SLOPE_CONTROL: 3
interpolate: true
run_current: 0.8
stealthchop_threshold: 200

#####################################################################
#                  Z2-axis on MOTOR_4 (right rear)
#####################################################################

[stepper_z2]
step_pin: PF9                          # Z2-axis motor pulse pin setting.
dir_pin: PF10                          # Z2-axis motor direction pin setting.
enable_pin: !PG2                       # Z2-axis motor enable pin setting.
rotation_distance: 40                  # Active pulley circumference in mm (2GT-20T pulley 40, 2GT-16T pulley 32).
gear_ratio: 80:16                      # Reduction ratio.
microsteps: 32                         # Motor microsteps setting.

[tmc2240 stepper_z2]
cs_pin: PF2
spi_software_sclk_pin: PA5
spi_software_mosi_pin: PA7
spi_software_miso_pin: PA6
driver_TPFD: 0
driver_SLOPE_CONTROL: 3
interpolate: true
run_current: 0.8
stealthchop_threshold: 200

#####################################################################
#                  Z3-axis on MOTOR_5 (right front)
#####################################################################

[stepper_z3]
step_pin: PC13                         # Z3-axis motor pulse pin setting.
dir_pin: !PF0                          # Z3-axis motor direction pin setting.
enable_pin: !PF1                       # Z3-axis motor enable pin setting.
rotation_distance: 40                  # Active pulley circumference in mm (2GT-20T pulley 40, 2GT-16T pulley 32).
gear_ratio: 80:16                      # Reduction ratio.
microsteps: 32                         # Motor microsteps setting.

[tmc2240 stepper_z3]
cs_pin: PE4
spi_software_sclk_pin: PA5
spi_software_mosi_pin: PA7
spi_software_miso_pin: PA6
driver_TPFD: 0
driver_SLOPE_CONTROL: 3
interpolate: true
run_current: 0.8
stealthchop_threshold: 200

#####################################################################
#                  Extruder Motor
#####################################################################


[extruder]
step_pin: EBBCan:gpio18                # Step pin.
dir_pin: EBBCan:gpio19                 # Direction pin, "!" indicates logic inversion.
enable_pin: !EBBCan:gpio17             # Enable pin, "!" indicates logic inversion.
full_steps_per_rotation: 200           # Number of pulses required for a single motor revolution (1.8 degree motor: 200, 0.9 degree motor: 400).
microsteps: 16                         # Microsteps setting.
gear_ratio: 50:10                      # Gear ratio.
rotation_distance: 22.4455464          # Rotation distance, normally: 22.6789511.
nozzle_diameter: 0.400                 # Nozzle diameter.
filament_diameter: 1.750               # Filament diameter.
heater_pin: EBBCan:gpio7               # Heater pin.
# control: pid                         # Control method.
# pid_Kp: 24.328                       # Proportional parameter of the PID controller.
# pid_Ki: 1.908                        # Integral parameter of the PID controller.
# pid_Kd: 77.543                       # Derivative parameter of the PID controller.
min_temp: -20                          # Minimum temperature.
max_temp: 350                          # Maximum temperature.
min_extrude_temp: 170                  # Minimum extrude temperature.
pressure_advance: 0.05                 # Pressure advance - try to keep pressure below 1.0.
pressure_advance_smooth_time: 0.040    # Pressure advance smooth time - default is 0.040.
sensor_type: MAX31865                  # Temperature sensor type.
sensor_pin: EBBCan:gpio9               # Sensor pin.
spi_software_sclk_pin: EBBCan:gpio10   # SPI clock pin.
spi_software_mosi_pin: EBBCan:gpio8    # SPI master out slave in pin.
spi_software_miso_pin: EBBCan:gpio11   # SPI master in slave out pin.
rtd_nominal_r: 100                     # RTD nominal resistance.
rtd_reference_r: 430                   # RTD reference resistance.
rtd_num_of_wires: 2                    # Number of wires for the RTD.

[verify_heater extruder]               # Heater block temperature tolerance configuration.
max_error: 120                         # Maximum error.
check_gain_time: 120                   # Tolerance time.
hysteresis: 50                         # Tolerance temperature.
heating_gain: 2                        # Heating gain.

[tmc2209 extruder]
uart_pin: EBBCan:gpio20
run_current: 0.550
stealthchop_threshold: 999999

#####################################################################
#                  Heater Bed
#####################################################################

[heater_bed]
heater_pin: PA3                        # (HE1).
sensor_pin: PF3                        # sensor interface(TB).
sensor_type: ATC Semitec 104GT-2       # ATC Semitec 104GT-2.
min_temp: 0                            # Minimum temperature threshold.
max_temp: 120                          # Maximum temperature threshold.
max_power: 1.0                         # Maximum power for the heater or fan.

[idle_timeout]
timeout: 1800                          # Time in seconds (30 minutes) before turning off the hot bed if idle.

#####################################################################
#                  Bed Grid Calibration
#####################################################################

[bed_mesh]
zero_reference_position: 150, 150      # This option is suitable for the 300 model. Set this to the middle of your bed.
speed: 300                             # Movement speed of toolhead during bed mesh.
horizontal_move_z: 3                   # Height of scanner during bed mesh scan.
mesh_min: 30, 30                       # Start point of bed mesh [X, Y].
mesh_max: 270, 270                     # End point of bed mesh [X, Y].
probe_count: 30, 30
adaptive_margin: 10
mesh_pps: 0, 0                         # Disable interpolation - mesh is probably dense enough.
algorithm: bicubic

#####################################################################
#                  Fans
#####################################################################

[fan]                                  # Parts Cooling Fan.
pin: EBBCan:gpio13                     # Pin for general fan control.
kick_start_time: 0.5                   # Time to start the fan.
off_below: 0.10                        # Temperature below which the fan turns off.

[heater_fan hotend_fan]                # Hotend fan.
pin: EBBCan:gpio14                     # Pin for hotend fan control.
heater: extruder                       # Heater associated with this fan.
heater_temp: 50.0                      # Temperature at which the fan deactivates after disabled.

[heater_fan nevermore]                 # Nevermore V6.
pin: PA8                               # Pin for Nevermore fan control.
max_power: 1.0                         # Maximum power for the fan.
shutdown_speed: 1.0                    # Speed at which the fan shuts down.
kick_start_time: 5.0                   # Start-up time for the fan.
heater: extruder                       # Heater associated with this fan.
heater_temp: 180                       # Temperature at which the fan deactivates after disabled.
fan_speed: 1.0                         # Fan speed.

[controller_fan driver_fan]            # Driver fan.
pin: PE5
kick_start_time: 0.5
stepper: stepper_x, stepper_y, stepper_z, stepper_z1, stepper_z2, stepper_z3

#####################################################################
#                  LED Light Settings
#####################################################################

[neopixel StealthBurner_LEDs]
pin: EBBCan:gpio16
chain_count: 10
color_order: GRB
initial_RED: 0.1
initial_GREEN: 0.1
initial_BLUE: 0.1

# BTT LEDs
# [neopixel hotend_rgb]
# pin: EBBCan:gpio16
# chain_count: 3
# color_order: GRBW
# initial_RED: 0.4
# initial_GREEN: 0.4
# initial_BLUE: 0.4
# initial_WHITE: 0.4

#####################################################################
#                  Gantry Leveling Settings
#####################################################################

[quad_gantry_level]
gantry_corners:                        # Coordinates for the gantry corners.
  -60,-10
  360,370
points:
  50,25
  50,225
  250,225
  250,25
speed: 500                             # Levelling speed in mm/min.
horizontal_move_z: 2                   # Z-axis height for horizontal moves.
retries: 5                             # Number of retries for out-of-tolerance adjustments.
retry_tolerance: 0.01                  # Tolerance for retrying.
max_adjust: 10                         # Maximum adjustment stroke for leveling.

#####################################################################
#                  Etc.
#####################################################################

[exclude_object]

[firmware_retraction]
retract_length: 0.5
retract_speed: 35

[skew_correction]

#####################################################################
#                  Macros
#####################################################################

[gcode_macro PARK_WAIT]
gcode:
  {% set z_position = params.Z|default(25)|float %}
  {% set x_center = printer.toolhead.axis_maximum.x|float / 2 %}     # Bed center X.
  {% set y_center = printer.toolhead.axis_maximum.y|float / 2 %}     # Bed center Y.
  G0 X{x_center} Y{y_center} Z{z_position} F9000                     # Move to bed center.

#--------------------------------------------------------------------

[gcode_macro G32]
gcode:
  BED_MESH_CLEAR                       # Clear bed mesh data.
  G28                                  # Home all axes.
  QUAD_GANTRY_LEVEL                    # Perform gantry leveling.
  PARK_WAIT

#--------------------------------------------------------------------

[delayed_gcode _CLEAR_DISPLAY]
gcode:
  SET_DISPLAY_TEXT

#--------------------------------------------------------------------

[gcode_macro CLEAR_DISPLAY_SOON]
gcode:
  UPDATE_DELAYED_GCODE ID=_CLEAR_DISPLAY DURATION=5

#--------------------------------------------------------------------

[gcode_macro SLEEP]
gcode:
  {% set MS = params.MS|default(1000)|int %}        # Pause duration in ms.

  G4 P{MS}

#--------------------------------------------------------------------

[gcode_macro PAUSE]
rename_existing: _PAUSE
gcode:
  {% set z = params.Z|default(10)|int %}                                                      # Z hop amount.

  {% if printer['pause_resume'].is_paused|int == 0 %}
    SET_GCODE_VARIABLE MACRO=RESUME VARIABLE=z_hop VALUE={z}                                   # Set z hop variable for reference in resume macro.
    SET_GCODE_VARIABLE MACRO=RESUME VARIABLE=e_temp VALUE={printer['extruder'].target}         # Set hotend temp variable for reference in resume macro.

    # SET_FILAMENT_SENSOR SENSOR=filament_sensor ENABLE=0                                     # Disable filament sensor.
    SAVE_GCODE_STATE NAME=PAUSE                                                               # Save current print position for resume.
    _PAUSE                                                                                    # Pause print.

    {% if (printer.gcode_move.position.z + z) < printer.toolhead.axis_maximum.z %}            # Check that z_hop doesn't exceed z max.
      G91                                                                                     # Relative positioning.
      G1 Z{z} F900                                                                            # Raise Z up by z hop amount.
    {% else %}
      { action_respond_info("Pause z_hop exceeds maximum Z height.") }                         # If z max is exceeded, show message and set z_hop value for resume to 0.
      SET_GCODE_VARIABLE MACRO=RESUME VARIABLE=z_hop VALUE=0
    {% endif %}

    G90                                                                                       # Absolute positioning.
    G1 X{printer.toolhead.axis_maximum.x / 2} Y{printer.toolhead.axis_minimum.y + 5} F9000    # Park toolhead at front center.
    SAVE_GCODE_STATE NAME=PAUSE_PARK                                                           # Save parked position in case toolhead is moved during the pause (otherwise the return z_hop can error).
    M104 S0                                                                                   # Turn off hotend.
    SET_IDLE_TIMEOUT TIMEOUT=43200                                                            # Set timeout to 12 hours.
  {% endif %}

#--------------------------------------------------------------------

[gcode_macro RESUME]
rename_existing: _RESUME
variable_z_hop: 0
variable_e_temp: 0
gcode:
  {% set e = params.E|default(2.5)|int %}                                           # Hotend prime amount (in mm).

  {% if printer['pause_resume'].is_paused|int == 1 %}
    # SET_FILAMENT_SENSOR SENSOR=filament_sensor ENABLE=1                           # Enable filament sensor.
    # Set to INITIAL_RGB                                                            # Reset LCD color.
    SET_IDLE_TIMEOUT TIMEOUT={printer.configfile.settings.idle_timeout.timeout}

    {% if e_temp > 0 %}
      M109 S{e_temp|int}                                                             # Wait for hotend to heat back up.
    {% endif %}

    RESTORE_GCODE_STATE NAME=PAUSE_PARK MOVE=1 MOVE_SPEED=100                        # Go back to parked position in case toolhead was moved during pause (otherwise the return z_hop can error).
    G91                                                                             # Relative positioning.
    M83                                                                             # Relative extruder positioning.

    {% if printer[printer.toolhead.extruder].temperature >= printer.configfile.settings.extruder.min_extrude_temp %}
      G1 Z{z_hop * -1} E{e} F900                                                     # Prime nozzle by E, lower Z back down.
    {% else %}
      G1 Z{z_hop * -1} F900                                                          # Lower Z back down without priming (just in case we are testing the macro with cold hotend).
    {% endif %}

    RESTORE_GCODE_STATE NAME=PAUSE MOVE=1 MOVE_SPEED=60                             # Restore position.
    _RESUME                                                                         # Resume print.
  {% endif %}

#--------------------------------------------------------------------

[gcode_macro PRINT_START]
gcode:
  {% set target_bed = params.BED|int %}                                        # Target bed temperature.
  {% set target_extruder = params.EXTRUDER|int %}                              # Target nozzle temperature.

  SET_DISPLAY_TEXT MSG="Heating bed: {target_bed}°C, heating nozzle: 150°C"
  M104 S150                                                                    # Preheat nozzle to 150°C (non-blocking).
  M140 S{target_bed}                                                           # Set bed target temperature (non-blocking).

  SET_GCODE_OFFSET Z=0                                                         # Reset Z offset.
  G28                                                                          # Home all axes.
  G90                                                                          # Set to absolute positioning.
  PARK_WAIT
  M190 S{target_bed}                                                           # Wait for bed to reach target temperature.

  SET_DISPLAY_TEXT MSG="Leveling..."
  QUAD_GANTRY_LEVEL
  PARK_WAIT Z=10
  M109 S150                                                                    # Wait for nozzle to reach 150°C.

  SET_DISPLAY_TEXT MSG="Calibrating Z offset"                                  # Display Z offset calibration message.
  CARTOGRAPHER_TOUCH_HOME                                                      # Calibrate Z offset.

  SET_DISPLAY_TEXT MSG="Bed mesh calibration"                                  # Display mesh calibration message.
  SKEW_PROFILE LOAD=Calilantern
  BED_MESH_CALIBRATE ADAPTIVE=1                                                # Perform bed mesh calibration.

  SET_DISPLAY_TEXT MSG="Heating nozzle: {target_extruder}°C"                   # Display nozzle heating message.
  PARK_WAIT
  M109 S{target_extruder}                                                      # Heat nozzle to target temperature.

  SET_DISPLAY_TEXT MSG="Priming..."
  G0 X10 Y5 F9000                                                              # Move to primeline start point.
  G0 Z0.4                                                                      # Raise Z to 0.4mm.
  G91                                                                          # Switch to relative positioning.
  G1 X100 E20 F1000                                                            # Extrude primeline.
  G0 Y-0.4
  G1 X-25 E5 F1000
  G0 Z0.4
  G90                                                                          # Switch back to absolute positioning.

  SET_DISPLAY_TEXT MSG="Printing..."

#--------------------------------------------------------------------

[gcode_macro PRINT_END]
gcode:
  SET_DISPLAY_TEXT MSG="Finishing..."
  M400
  G92 E0                               # Zeroing the extruder.
  G1 E-10 F2100                        # Retracting the filament.
  G91                                  # Relative position.
  G0 Z1 X20 Y20 F9000                  # Remove nozzle.
  TURN_OFF_HEATERS                     # Close the hot end.
  M107                                 # Switch off the fan.
  G0 Z2 F900                           # Move the nozzle up 2 mm.
  G90                                  # Absolute positioning.
  G0 X150 Y295 F9000                   # Park the nozzle at the rear.
  BED_MESH_CLEAR                       # Unloading net beds.
  SET_SKEW CLEAR=1

  SET_DISPLAY_TEXT MSG="Finished"

#--------------------------------------------------------------------

[gcode_macro CANCEL_PRINT]
rename_existing: _CANCEL_PRINT
gcode:
  SET_IDLE_TIMEOUT TIMEOUT={printer.configfile.settings.idle_timeout.timeout}  # set timeout back to configured value.
  CLEAR_PAUSE
  PRINT_END
  _CANCEL_PRINT

#--------------------------------------------------------------------

[gcode_macro LOAD_FILAMENT]
gcode:
  {% if (not(printer.idle_timeout.state == "Printing") or printer.pause_resume.is_paused) %}
    SAVE_GCODE_STATE NAME=LOAD_STATE
    SET_DISPLAY_TEXT MSG="Loading filament..."
    M83                              # Set extruder to relative.
    G1 E50 F300                      # Load (multiple times to avoid length limit).
    G1 E50 F300
    G1 E50 F600
    G1 E-1 F2100                     # Short retract.
    SET_DISPLAY_TEXT MSG="Filament loaded"
    CLEAR_DISPLAY_SOON
    RESTORE_GCODE_STATE NAME=LOAD_STATE
  {% else %}
    { action_respond_info("Filament loading disabled while printing!") }
  {% endif %}

#--------------------------------------------------------------------

[gcode_macro UNLOAD_FILAMENT]
gcode:
  {% if (not(printer.idle_timeout.state == "Printing") or printer.pause_resume.is_paused) %}
    SAVE_GCODE_STATE NAME=UNLOAD_STATE

    M83                                # Set extruder to relative.
    G1 E5 F120                         # Quick purge.
    G1 E-4 F2100                       # Fast retract.
    G1 E-16 F1200                      # Retract.
    SLEEP MS=1000                      # Wait for filament to cool.
    G1 E16 F300                        # Tip forming.
    G1 E-4 F2100
    G1 E-12 F1200
    SLEEP MS=500
    G1 E-50 F2100                      # Fully retract, in seperate commands to avoid "Extrude only move too long" error.
    G1 E-50 F2100

    SET_DISPLAY_TEXT MSG="Filament unloaded"
    CLEAR_DISPLAY_SOON
    RESTORE_GCODE_STATE NAME=UNLOAD_STATE
  {% else %}
    { action_respond_info("Filament unloading disabled while printing!") }
  {% endif %}

#--------------------------------------------------------------------

[gcode_macro QUERY_LEVEL]
gcode:
  {% if printer.quad_gantry_level.applied %}
    {action_respond_info('Quad gantry level applied: Yes')}
  {% else %}
    {action_respond_info('Quad gantry level applied: No')}
  {% endif %}

#--------------------------------------------------------------------

[gcode_macro QUAD_GANTRY_LEVEL]
rename_existing: _QUAD_GANTRY_LEVEL
gcode:
  # REF: https://klipper.discourse.group/t/faster-quad-gantry-level-macro/19044
  # If QGL is not applied, first run a course calibration.
  {% if not printer.quad_gantry_level.applied %}
    _QUAD_GANTRY_LEVEL RETRIES=0 HORIZONTAL_MOVE_Z={printer.configfile.settings.quad_gantry_level.horizontal_move_z|float + 10.0}
  {% endif %}

  # Then do normal quad gantry level.
  _QUAD_GANTRY_LEVEL

#--------------------------------------------------------------------

[gcode_macro CONDITIONAL_HOMING]
gcode:
  {% if "xyz" not in printer.toolhead.homed_axes %}
      G28
  {% endif %}

  {% if not printer.quad_gantry_level.applied %}
    QUAD_GANTRY_LEVEL
  {% endif %}

#*# <---------------------- SAVE_CONFIG ---------------------->
#*# DO NOT EDIT THIS BLOCK OR BELOW. The contents are auto-generated.
#*#
#*# [heater_bed]
#*# control = pid
#*# pid_kp = 64.599
#*# pid_ki = 2.778
#*# pid_kd = 375.482
#*#
#*# [extruder]
#*# control = pid
#*# pid_kp = 21.703
#*# pid_ki = 1.418
#*# pid_kd = 83.011
#*#
#*# [cartographer scan_model default]
#*# coefficients = 1.3902108345297195,1.8678194696967811,0.8244451467078936,0.3329531273769176,0.5469009902187786,0.780137013354842,-0.3898530089002773,-0.7700899014405973,0.42922898270451026,0.4911744283225742
#*# domain = 3.1498235975054516e-07,3.323030625124981e-07
#*# z_offset = 0
#*# reference_temperature = 41.76
#*# software_version = 1.5.1
#*# mcu_version = CARTOGRAPHER V3 6.1.0
#*#
#*# [cartographer touch_model default]
#*# threshold = 2182
#*# speed = 2
#*# z_offset = -0.05
#*# software_version = 1.5.1
#*# mcu_version = CARTOGRAPHER V3 6.1.0
#*#
#*# [cartographer]
#*# z_backlash = 0.00811
#*#
#*# [bed_mesh default]
#*# version = 1
#*# points =
#*# 	-0.035616, -0.035616, -0.037741, -0.035616, -0.035616, -0.033493, -0.033493, -0.033720, -0.032545, -0.034554, -0.035616, -0.037741, -0.037741, -0.037741, -0.041997, -0.044129, -0.046029, -0.048164, -0.050301, -0.050301, -0.052441, -0.048164, -0.046262, -0.046029, -0.044129, -0.044129, -0.044129, -0.044129, -0.043063, -0.037741
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
#*# tension = 0.2
#*#
#*# [input_shaper]
#*# shaper_type_x = mzv
#*# shaper_freq_x = 52.4
#*# shaper_type_y = mzv
#*# shaper_freq_y = 38.8
#*# shaper_type_z = mzv
#*# shaper_freq_z = 58.0
#*#
#*# [skew_correction Calilantern]
#*# xy_skew = -0.0013429450962293367
#*# xz_skew = 0
#*# yz_skew = 0
