casktura/SIBOOR-Voron-2.4-AUG/(commit log)

2026-04-06 Added BOM file.
2026-04-06 Update BOM file.
2026-04-27 Added my build contents.
    [printer.cfg]
2026-04-27 Formatted macros.
    [printer.cfg]
2026-04-27 Update printer.cfg file.
    [printer.cfg]
2026-04-28 Updated printer.cfg file.
    [printer.cfg]
2026-05-06 Updated printer.cfg file.
    * Added STL files.
    [BTT SFS V2.0 Sensor Mount.stl, Chamber_Sensor_Voron.stl, Chamber_Sensor_Voron.stp, Exhaust_cover.f3d, Exhaust_cover.step, Front_Door_Mod.f3d, Voron BTT SFS Exhaust Cover.stl, Voron Trident Handles.3mf]
2026-05-18 Added STL files.
    [Door hinge mag.step, Door holder left.step, Door holder right.step, Door-holder-left.stl, Door-holder-right.stl, Door-holder.3mf, Door-mag-hinge.3mf, Door-mag-hinge.stl]
2026-05-20 Updated printer.cfg and README.
    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
    [annex_clips_wrench.stl, magnetic_door_hinge_tape_v2__4mm.stl, printer.cfg]
2026-06-09 Updated configuration files.
    * Updated README.md file.
    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
    [Door Jig.stl, Empty_Place_Filler.stl, Fly_Stealthburner_LED.step, Octopus_Stepper_Duct Fan Base.stl, Octopus_Stepper_Duct v3 - No Top Vents.stl, Octopus_Stepper_Duct v3 - No Top or Side Vents.stl, Octopus_Stepper_Duct v3.stl, Slip Cover v3.stl]
2026-06-15 Updated README.md and added STL files.
    * Updated printer.cfg file.
    [GT2 Calibration Wire Pivot 0.032.stl, Meter Base-RC2.stl, Meter Slide-RC2 .stl, Needle 00-RC2.stl, Needle 01-RC2.stl, Needle 02-RC2.stl, Needle 03-RC2.stl, Needle 04-RC2.stl]
2026-06-23 Moved files and refactored.
    [BTT SFS V2.0 Sensor Mount.stl, Chamber_Sensor_Voron.stl, Chamber_Sensor_Voron.stp, Door Jig.stl, Door hinge mag.step, Door holder left.step, Door holder right.step, Door-holder-left.stl]
