casktura/SIBOOR-Voron-2.4-AUG/(notices)

Notices in the files:
00_My_Build/STLs/GT2 Belt Tension Meter/Readme.md:
CC BY-NC-SA 4.0
